GioVeronelli/BREATH/Data_acquired/Furkan/Furkan Protocols.docx

PROTOCOL 1

Protocol 1 – Option 1 – First

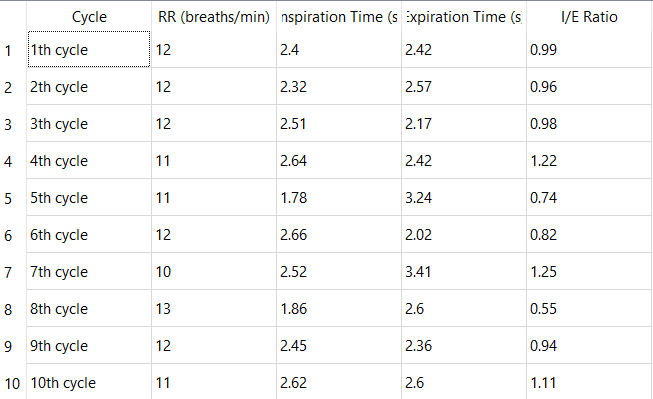
[picture p39: figure]
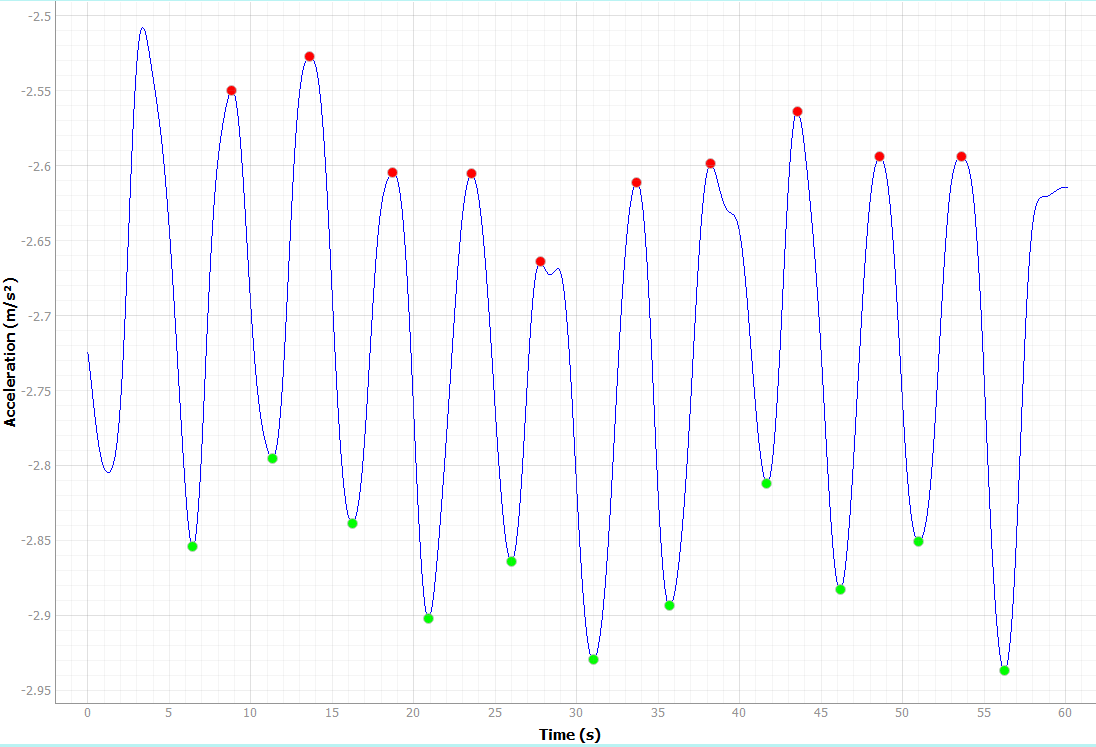
[picture p40: figure]

Protocol 1 – Option 1 – Second

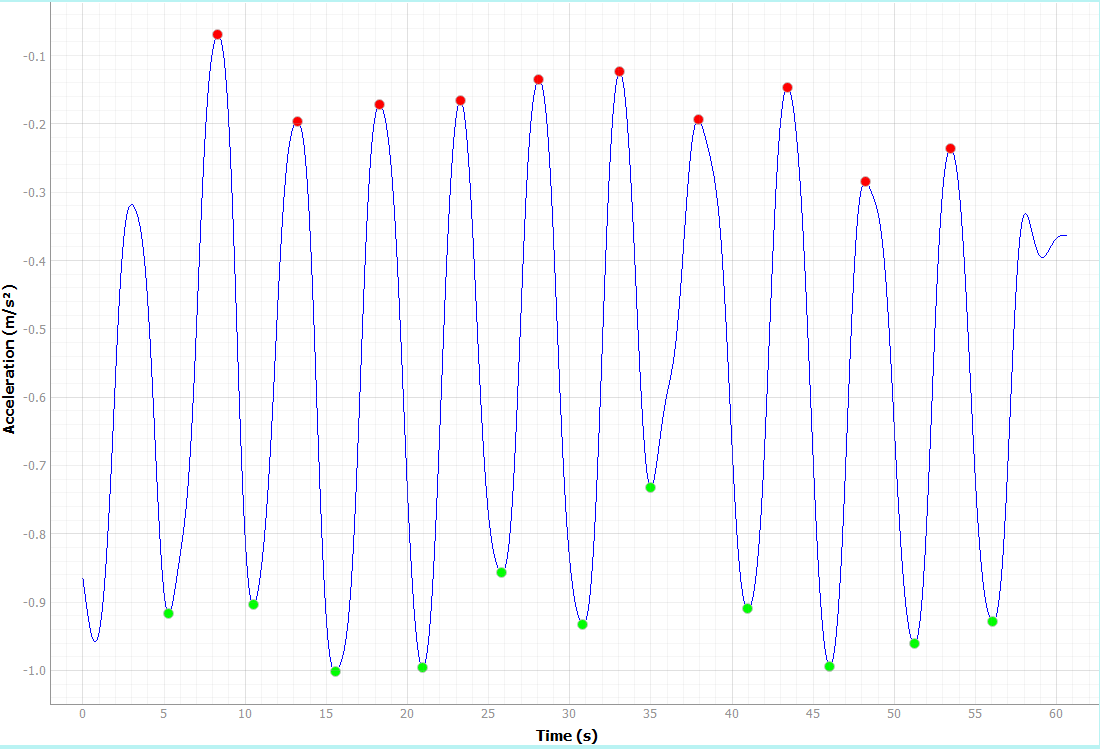
[picture p41: figure]
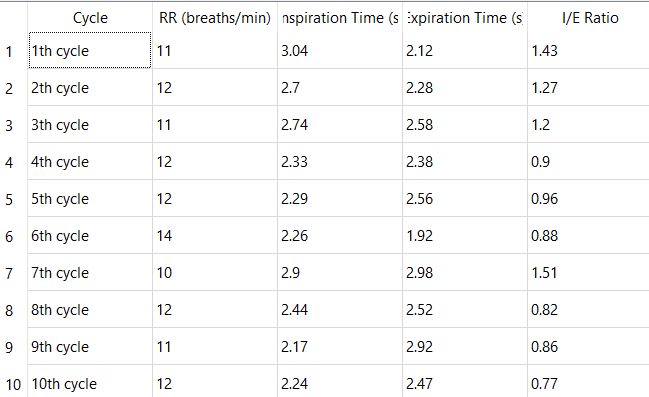
[picture p42: figure]

Protocol 1 – Option 1 – Third

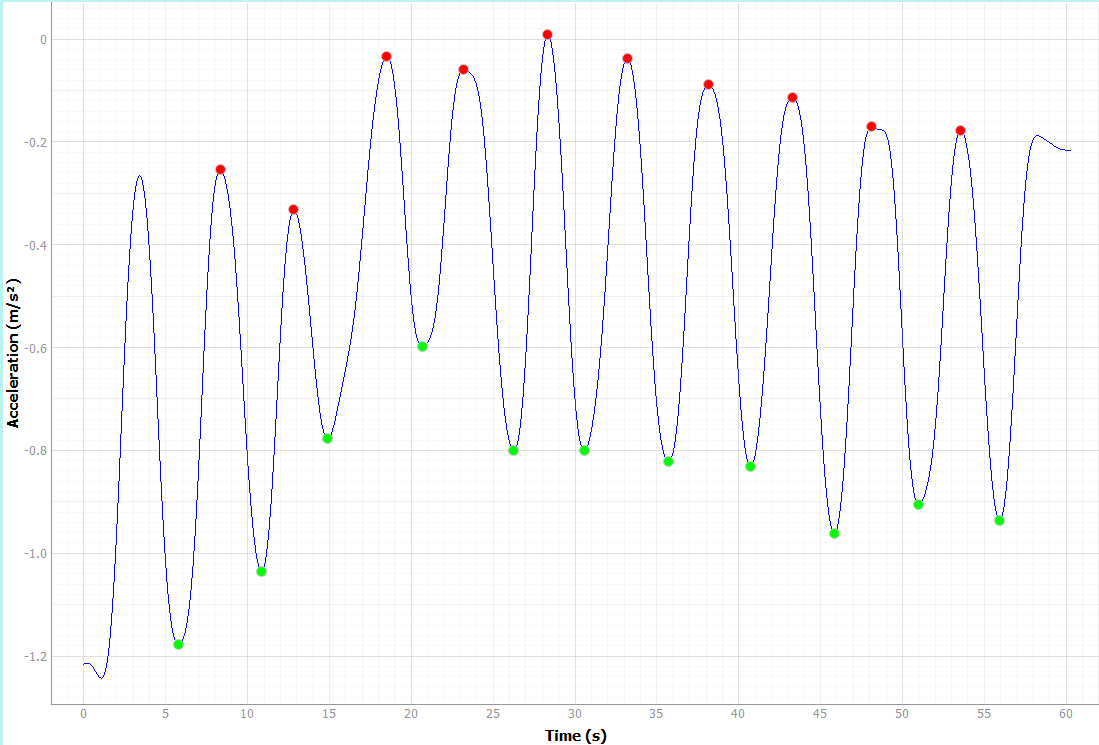
[picture p43: figure]
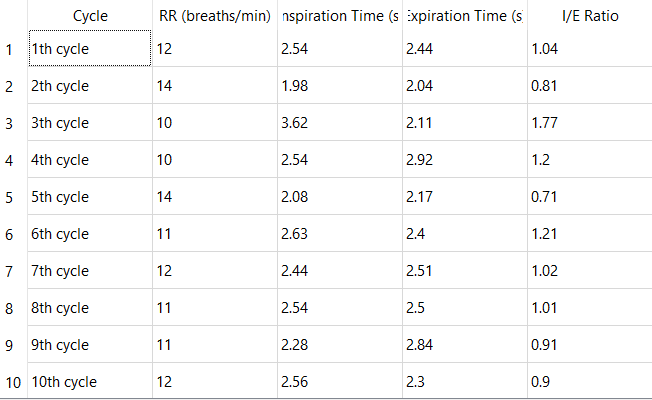
[picture p44: figure]

Protocol 1 Option 2 – First

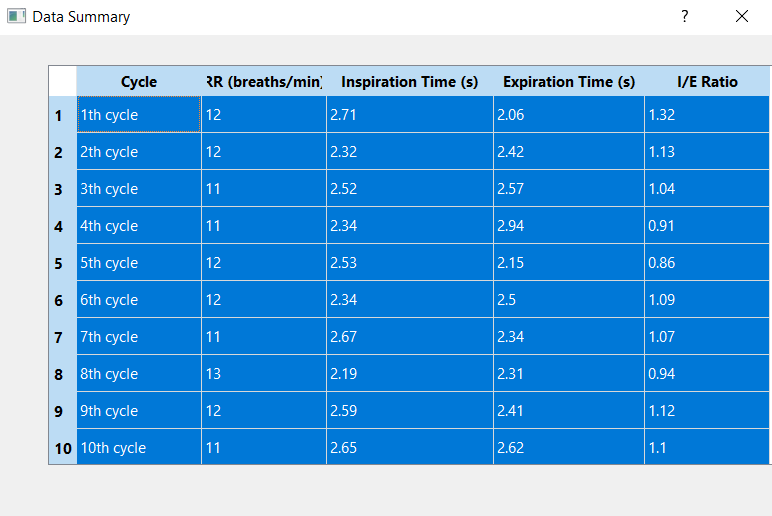
[picture p45: figure]
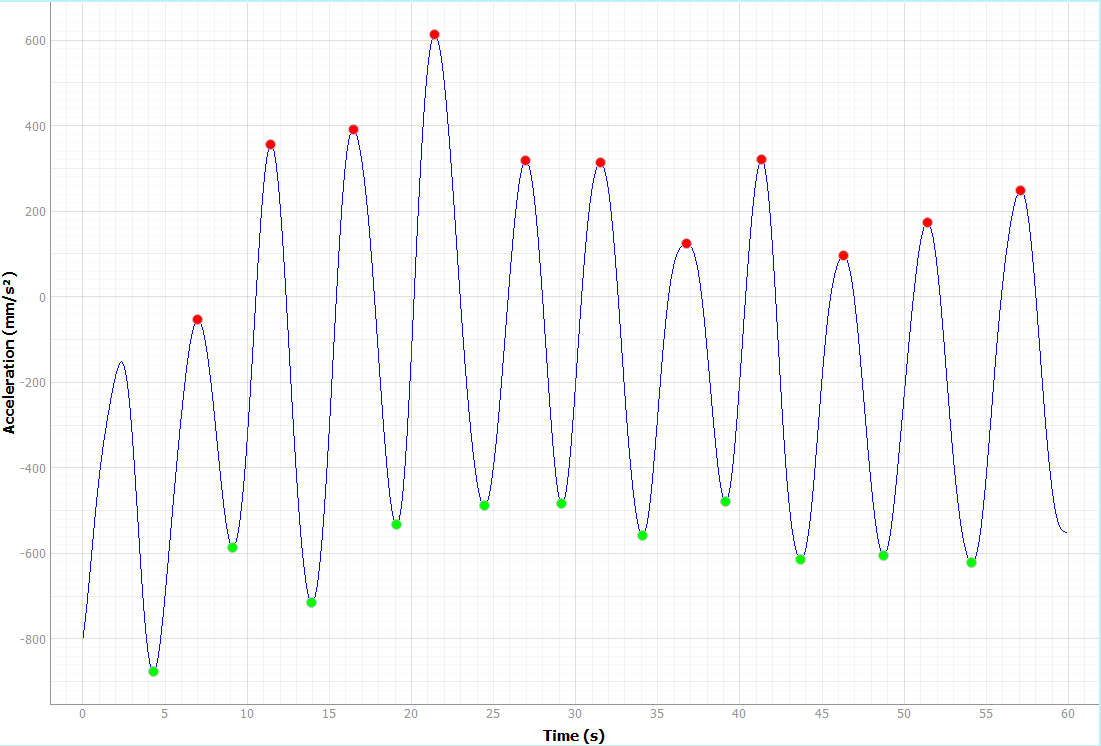
[picture p46: figure]

Protocol 1 Option 2 – Second

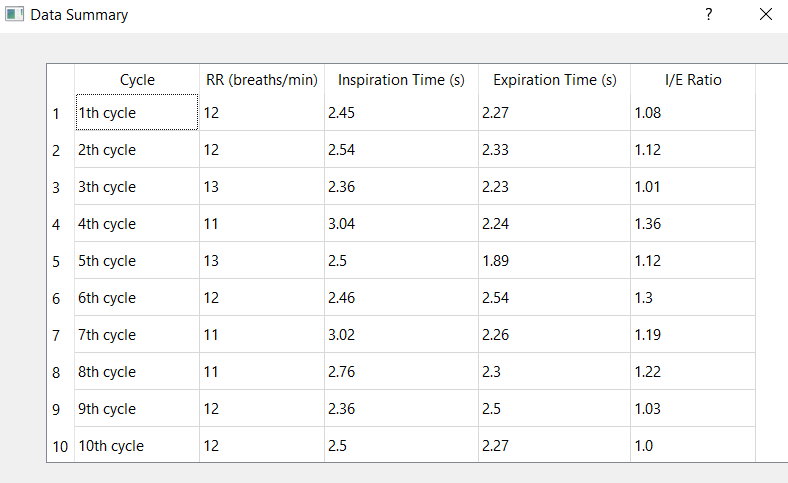
[picture p47: figure]
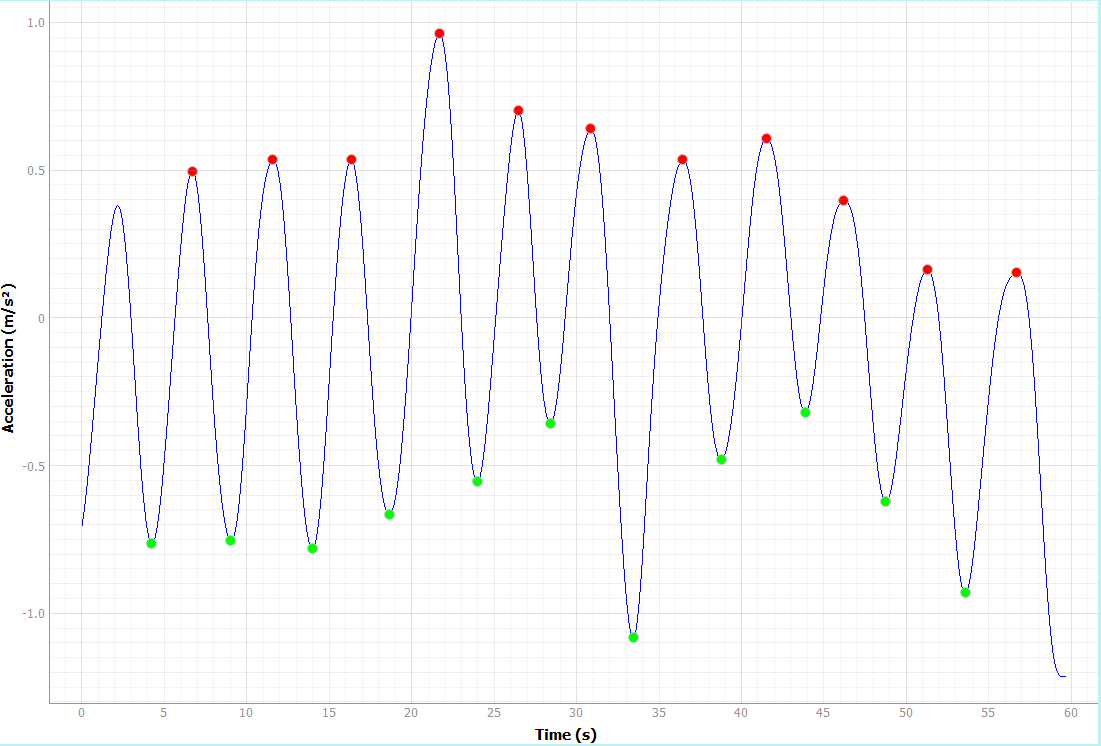
[picture p48: figure]

Protocol 1 Option 2 – Third

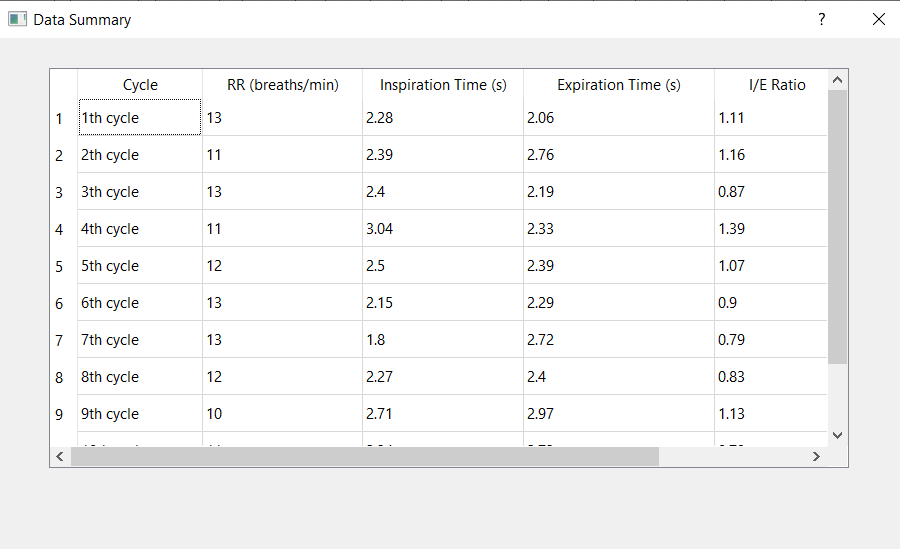
[picture p49: figure]
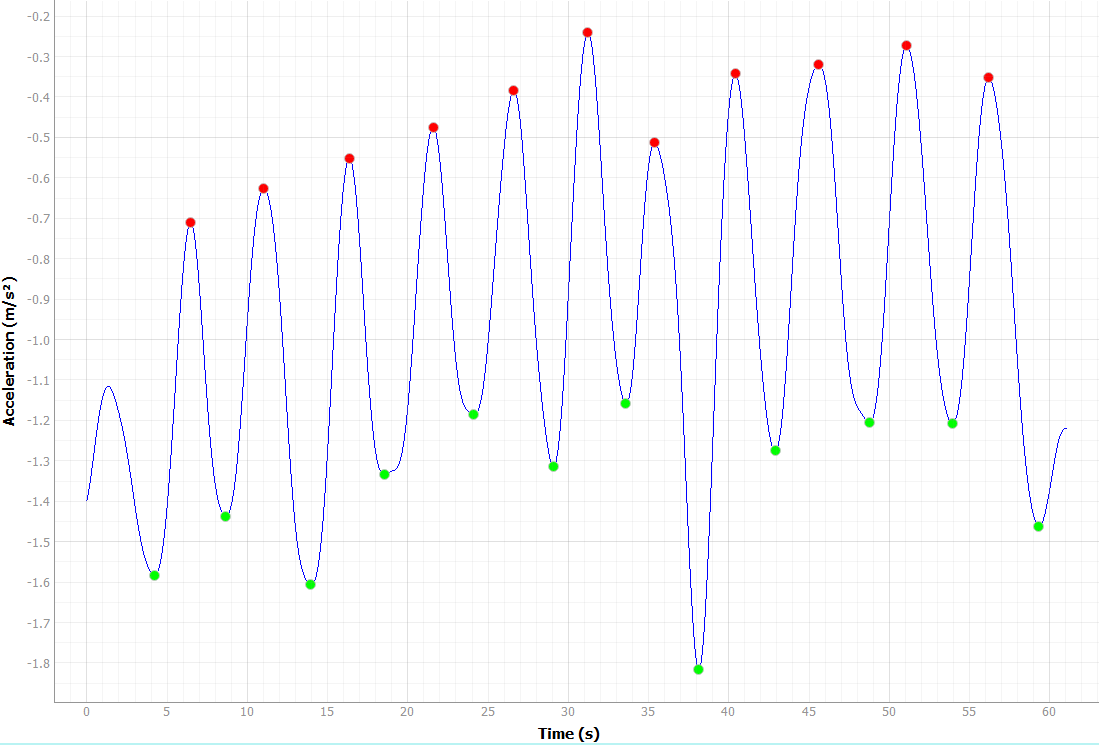
[picture p50: figure]

Protocol 1 – Option 3 – First

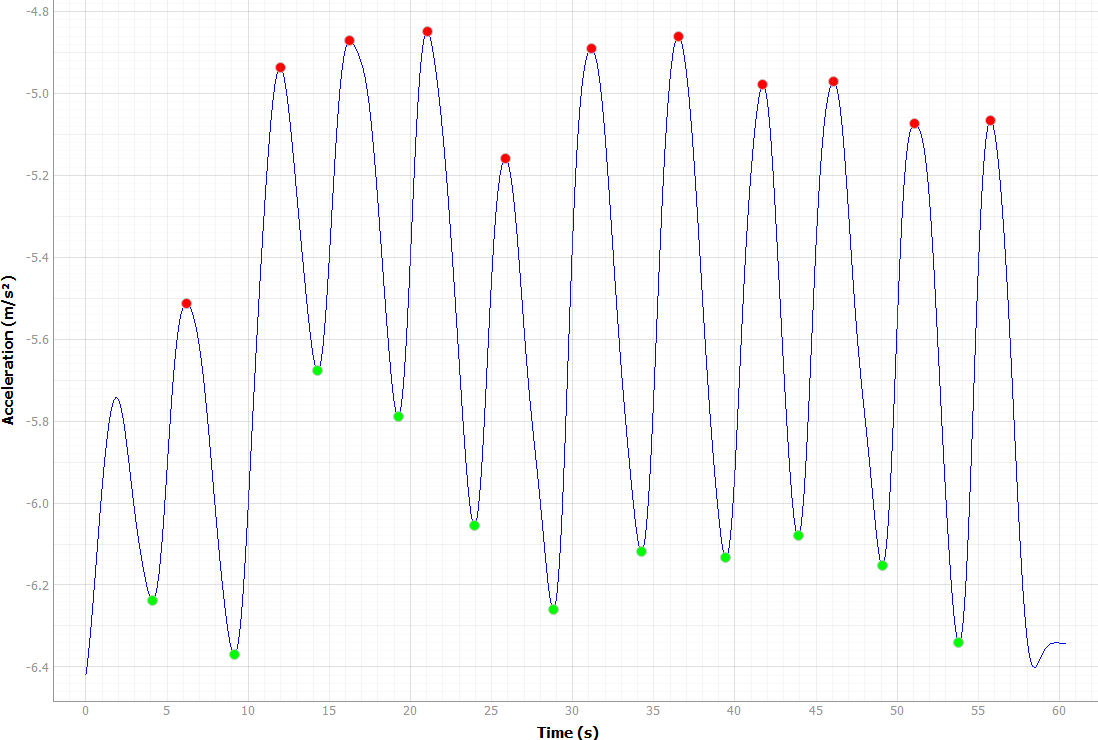
[picture p51: figure]
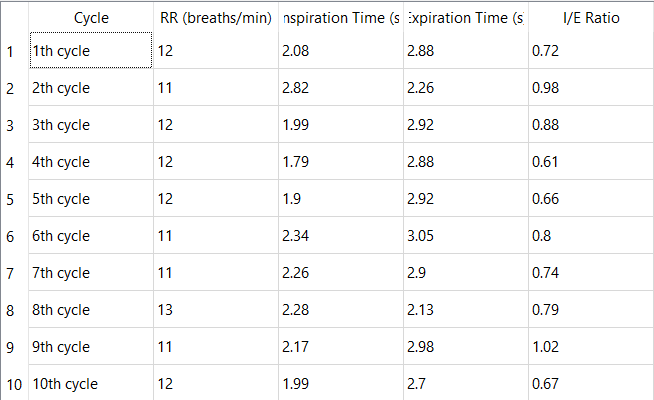
[picture p52: figure]

Protocol 1 – Option 3 – Second

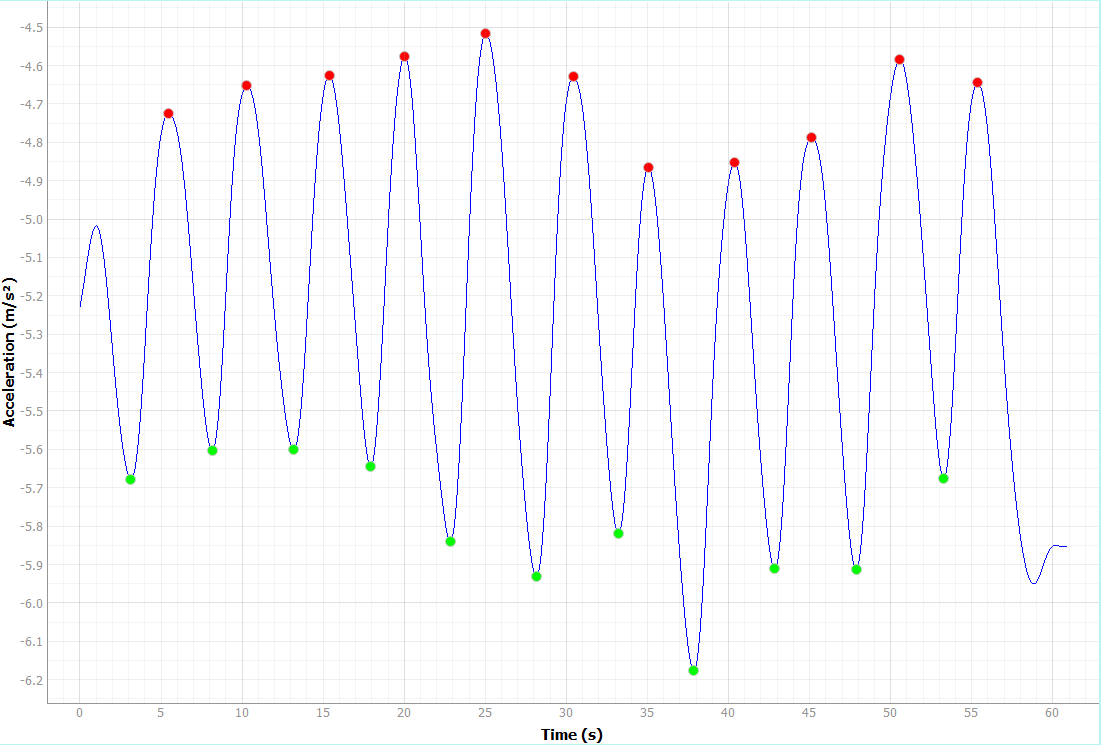
[picture p53: figure]
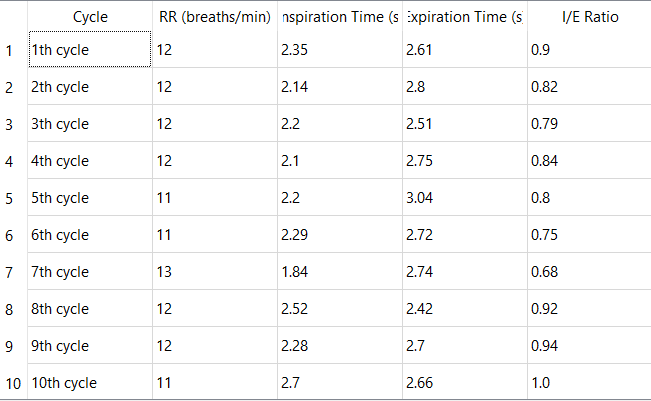
[picture p54: figure]

Protocol 1 – Option 3 – Third

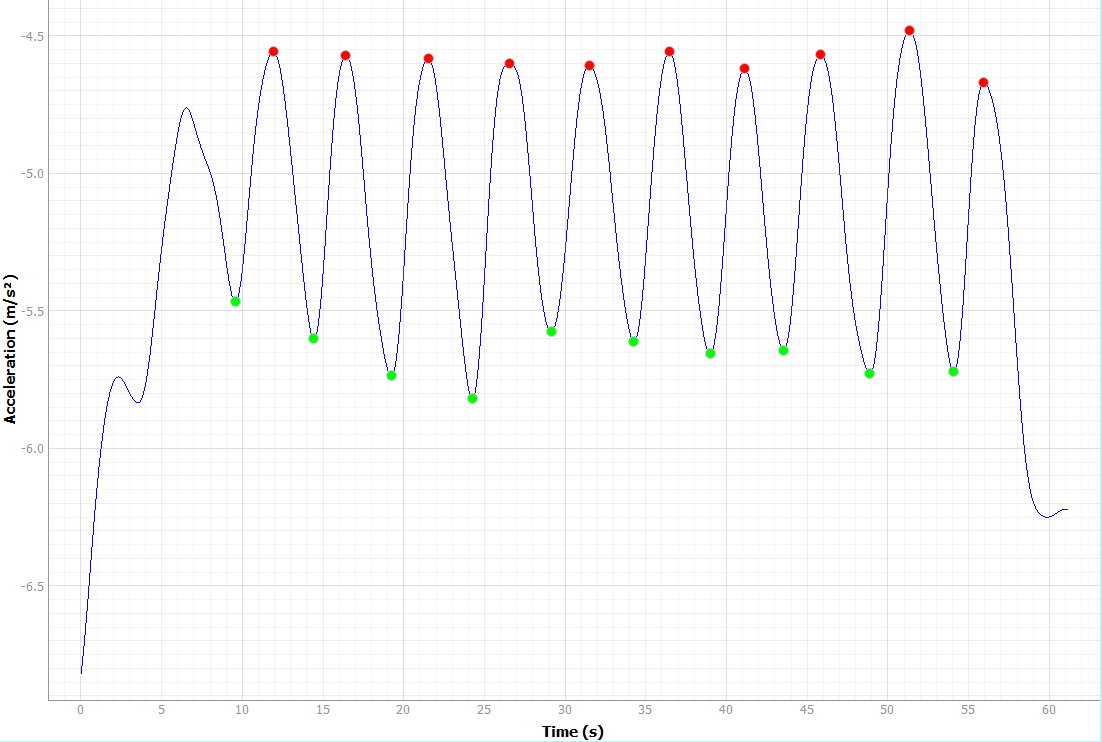
[picture p55: figure]
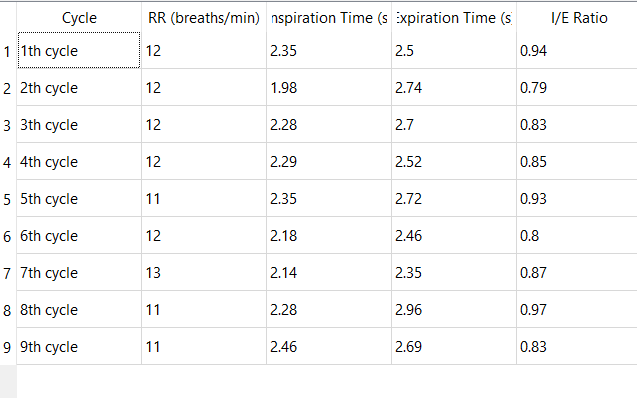
[picture p56: figure]

Protocol 1 – Option 4 – First

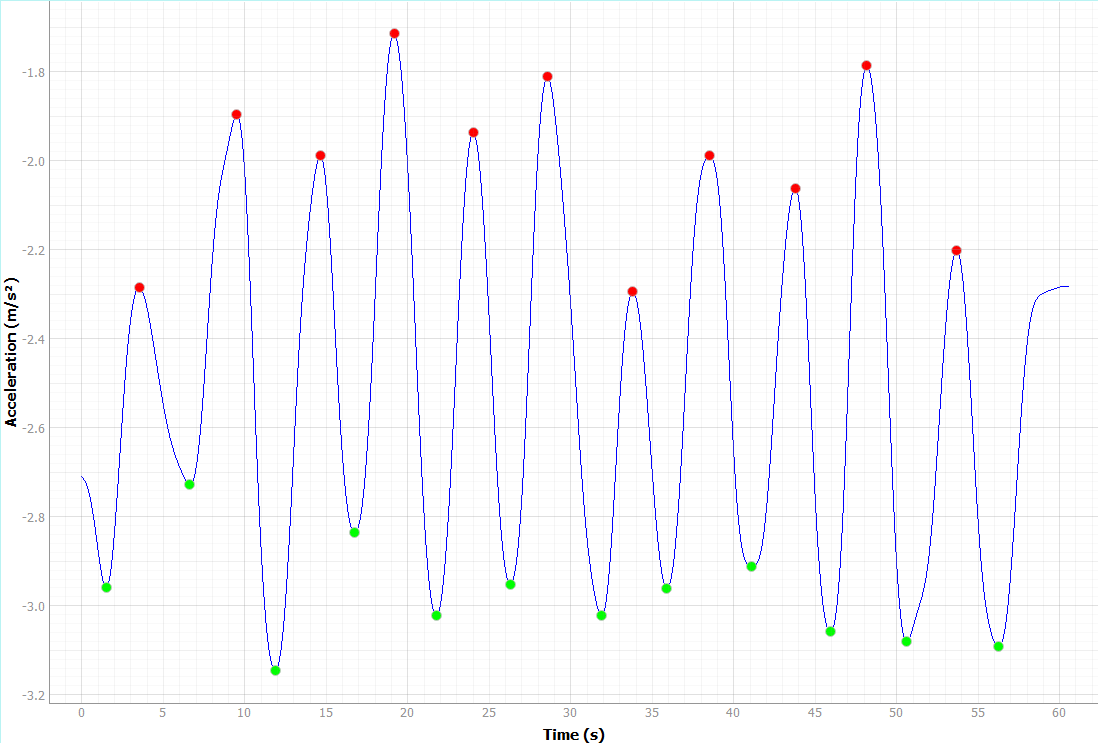
[picture p57: figure]
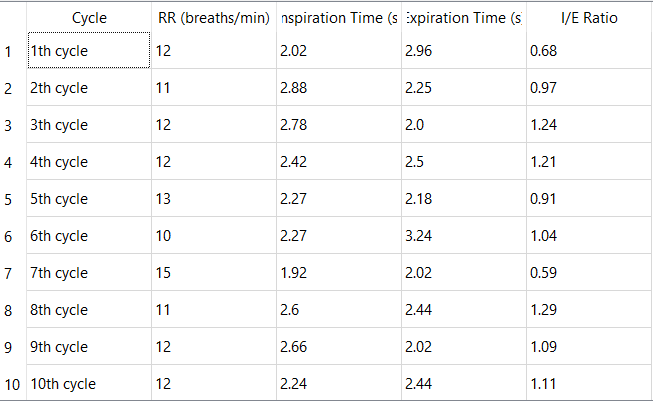
[picture p58: figure]

Protocol 1 – Option 4 – Second

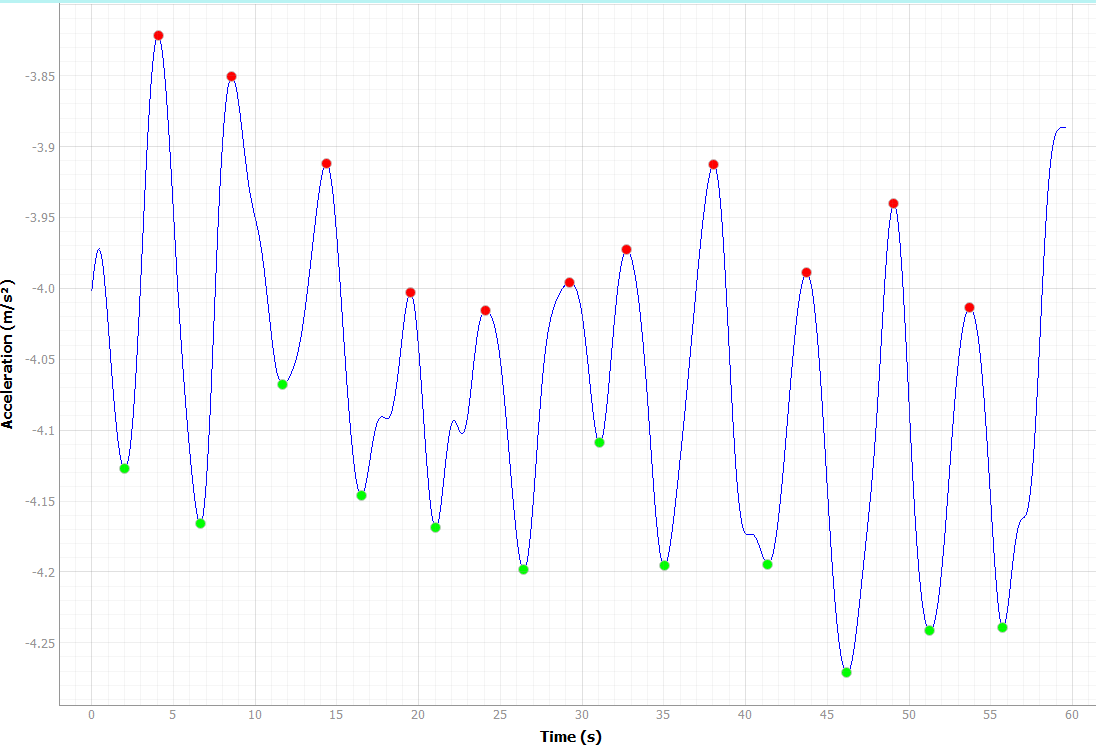
[picture p59: figure]
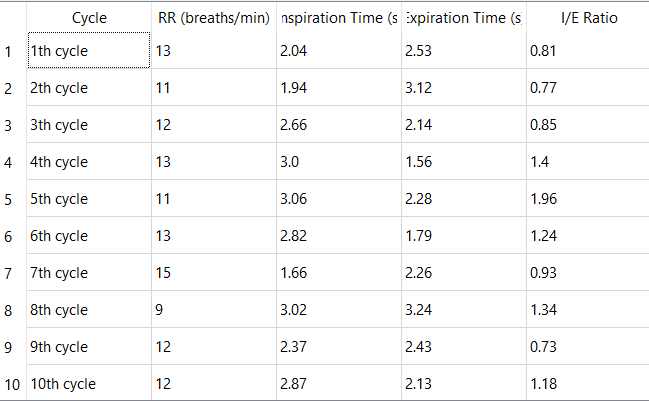
[picture p60: figure]

Protocol 1 – Option 4 – Third

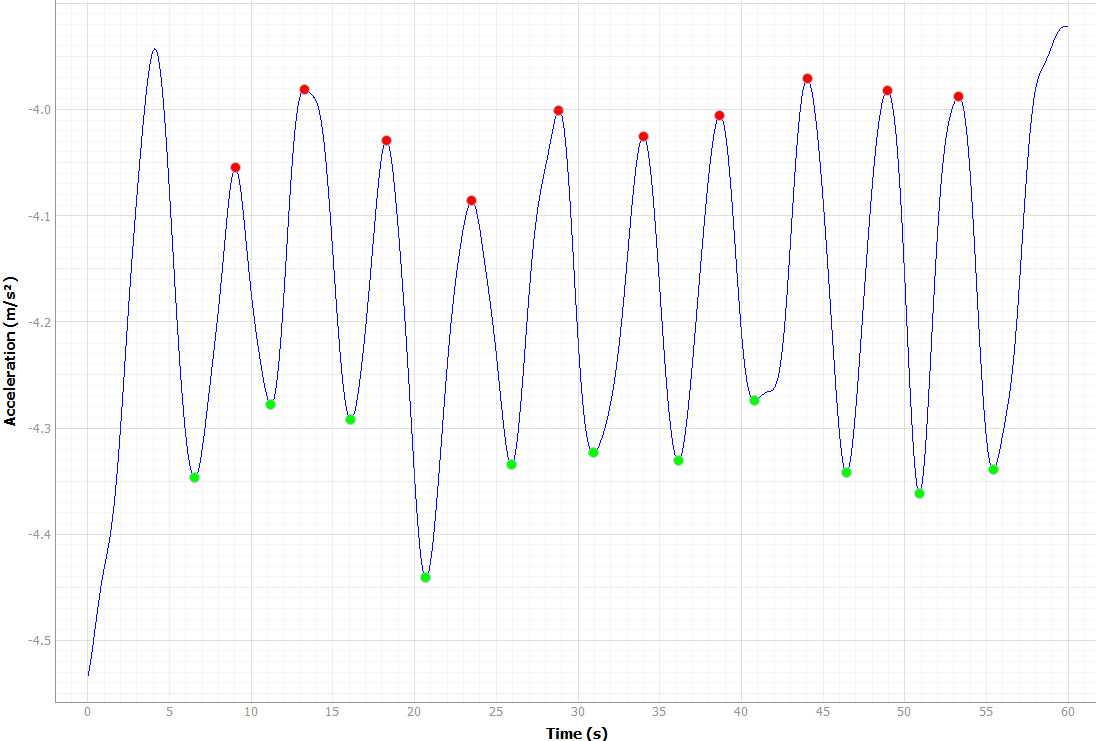
[picture p61: figure]
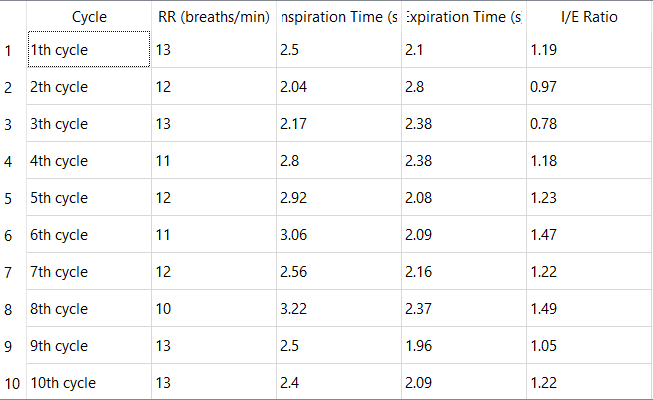
[picture p62: figure]

PROTOCOL 2

Protocol 2 Option 1 – First

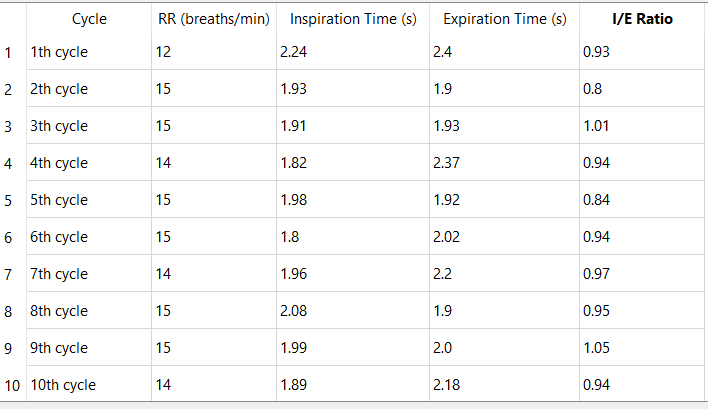
[picture p63: figure]
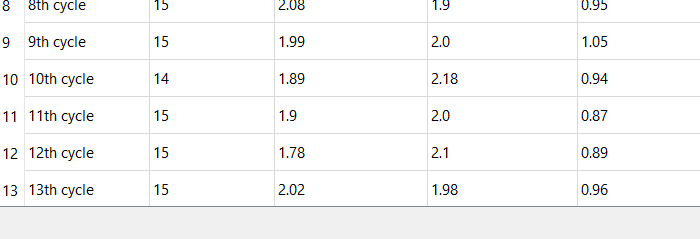
[picture p64: figure]
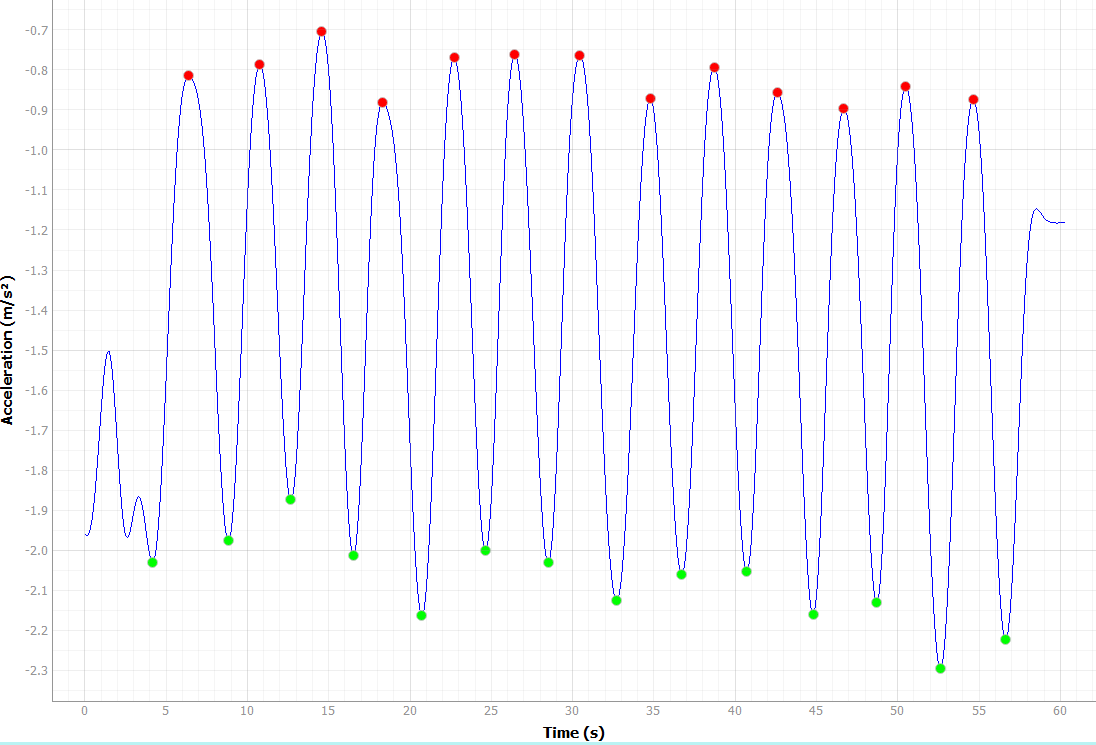
[picture p65: figure]

Protocol 2 Option 1 – Second

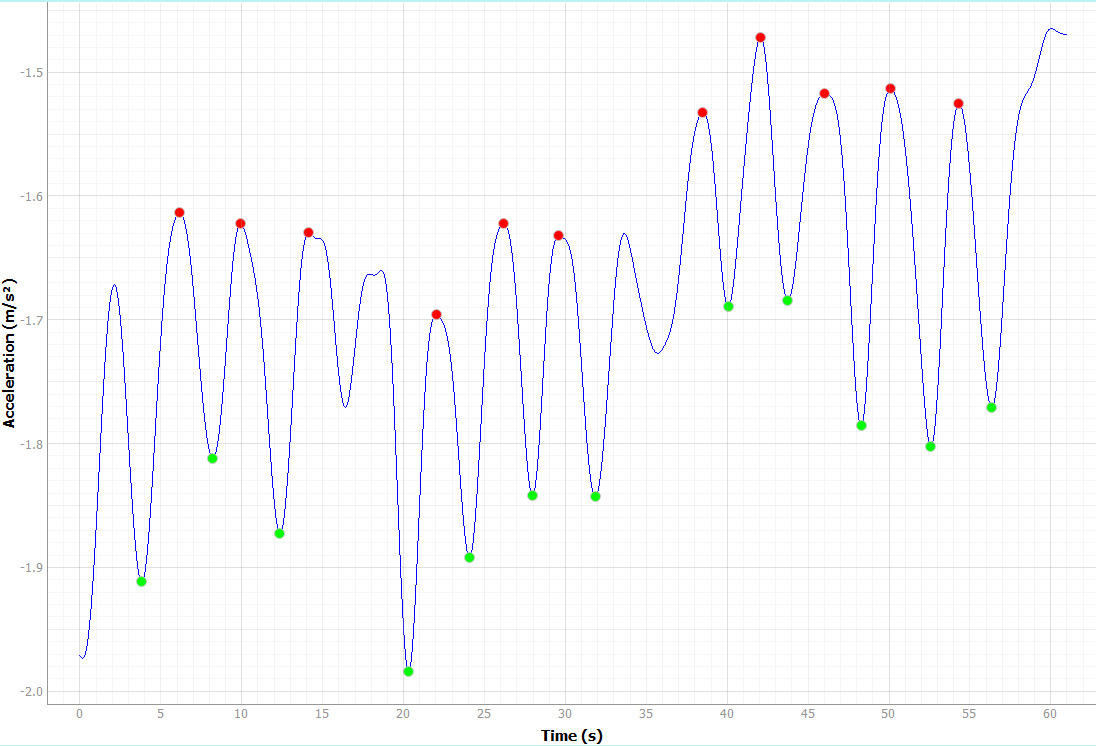
[picture p66: figure]
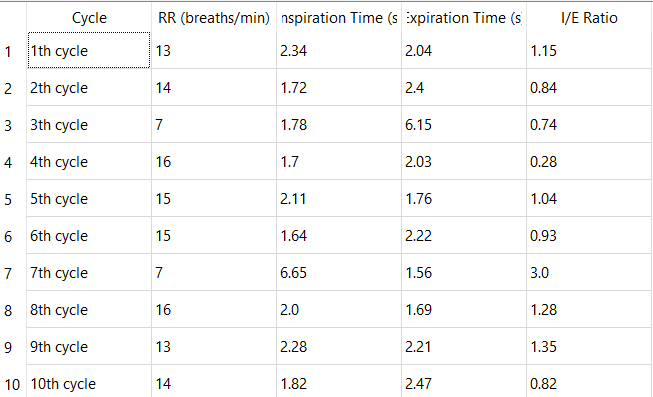
[picture p67: figure]

Protocol 2 Option 1 – Third

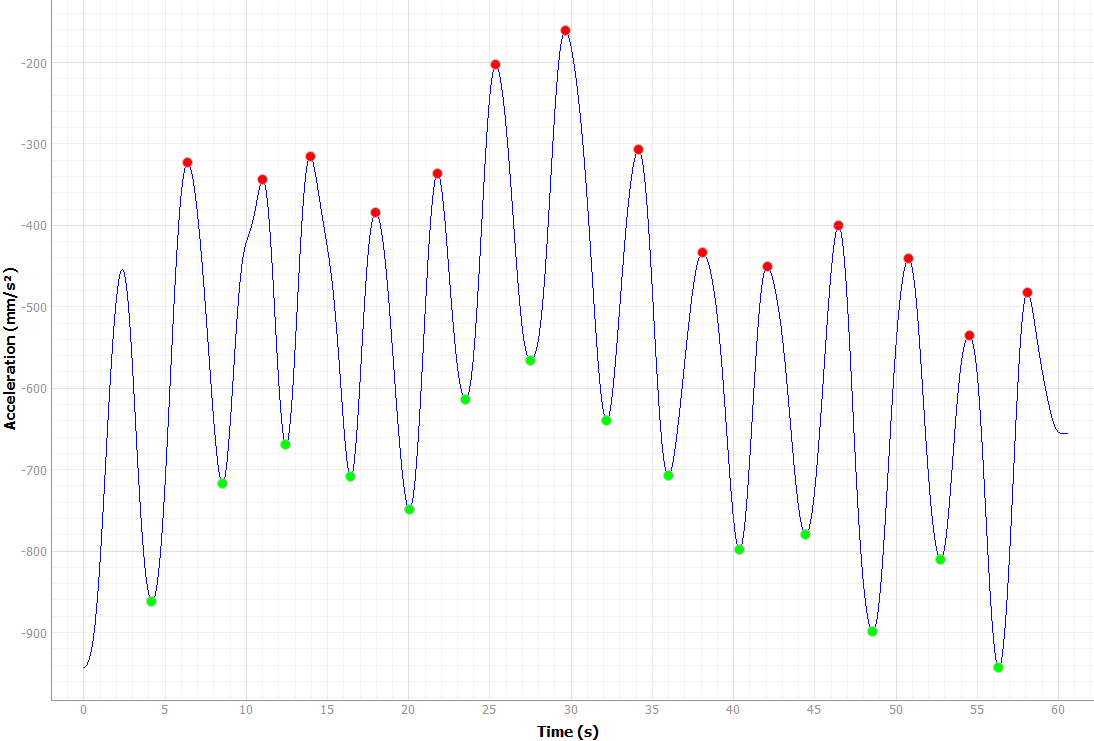
[picture p68: figure]
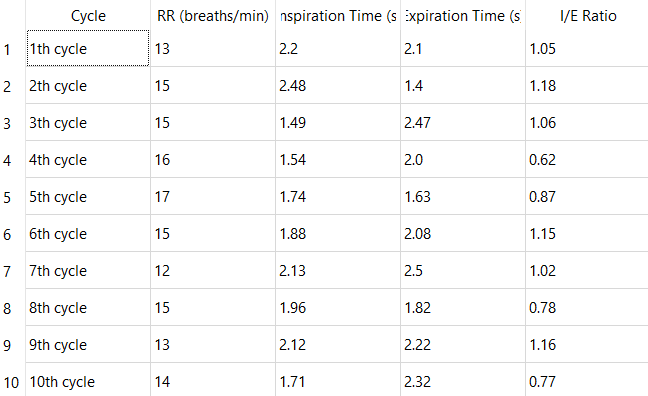
[picture p69: figure]

Protocol 2 Option 2 – First

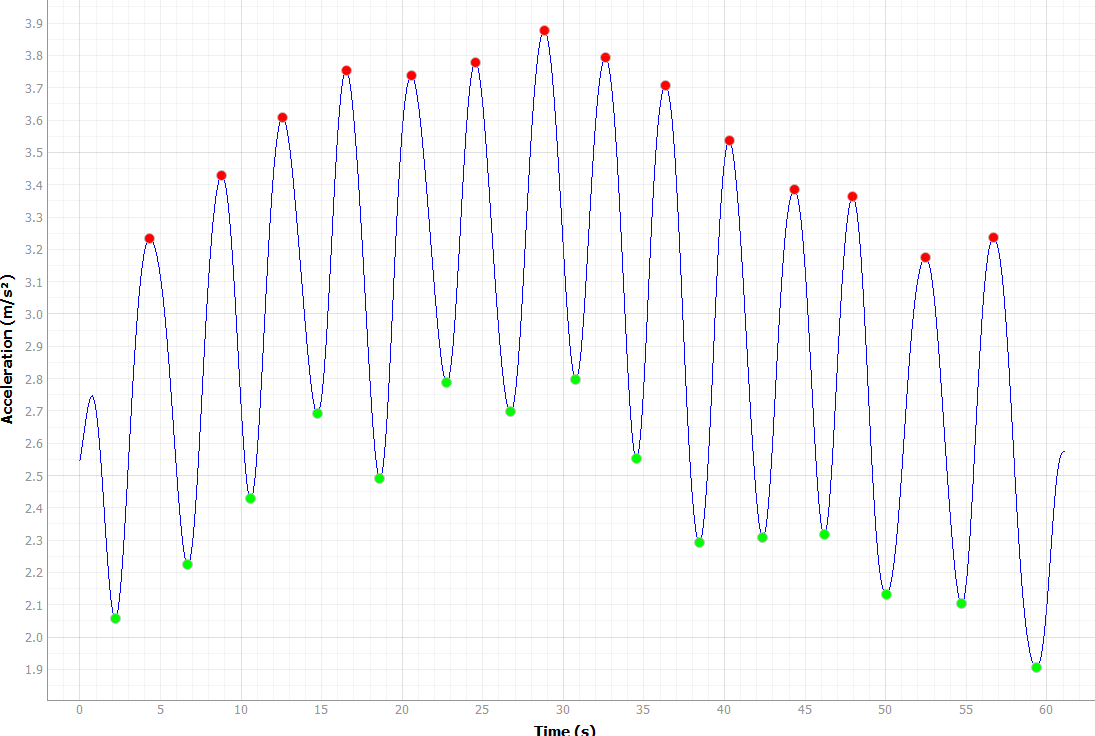
[picture p70: figure]
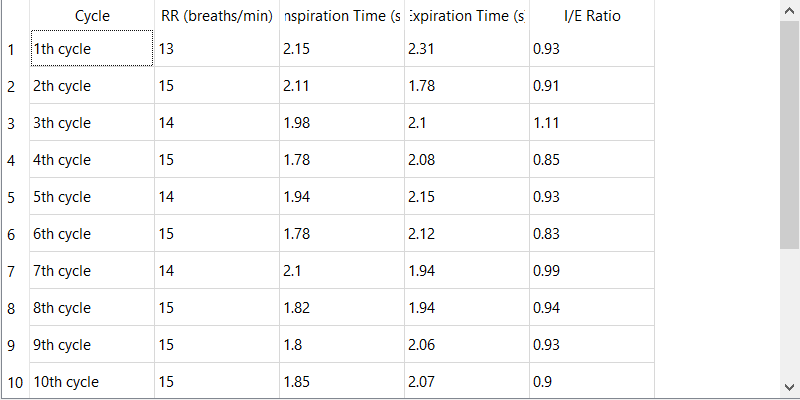
[picture p71: figure]

Protocol 2 Option 2 – Second

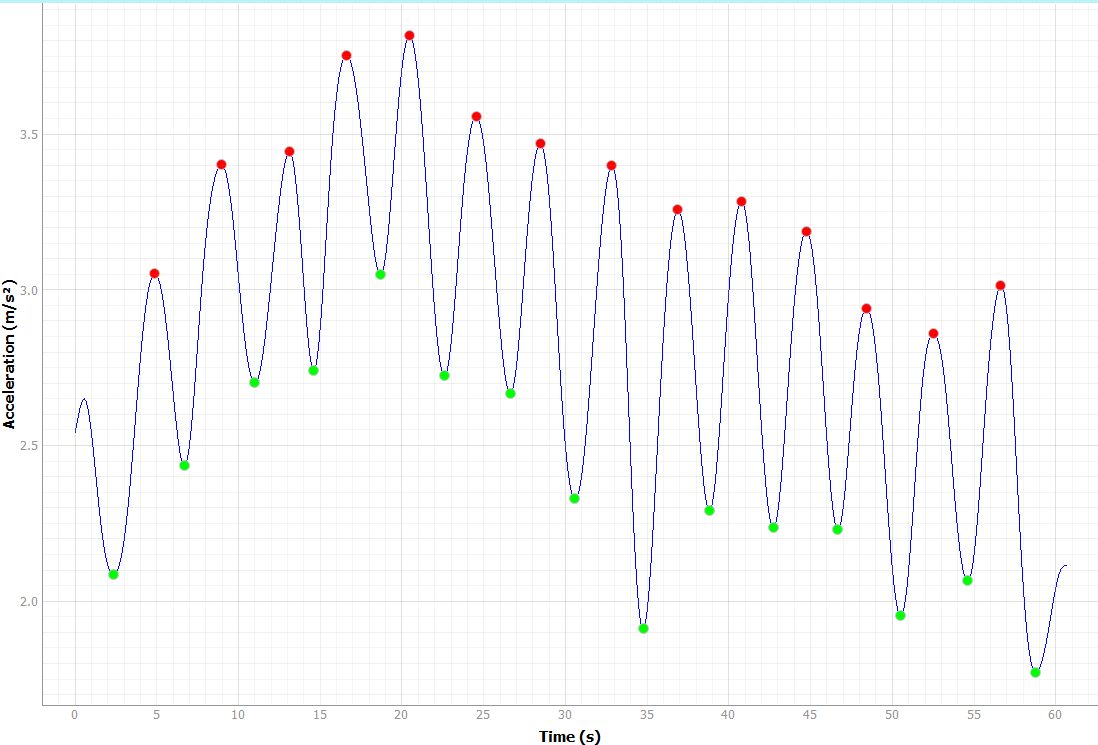
[picture p72: figure]
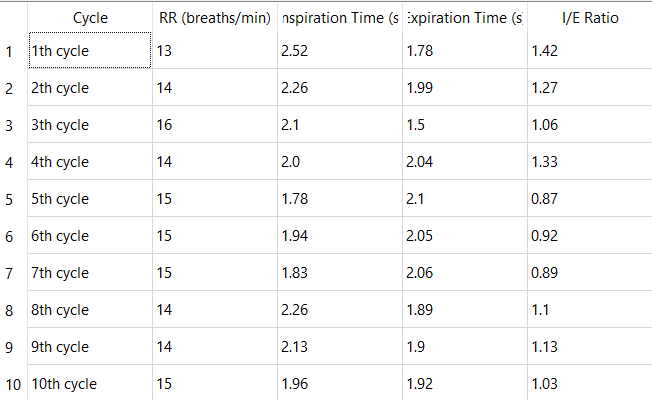
[picture p73: figure]

Protocol 2 Option 2 – Third

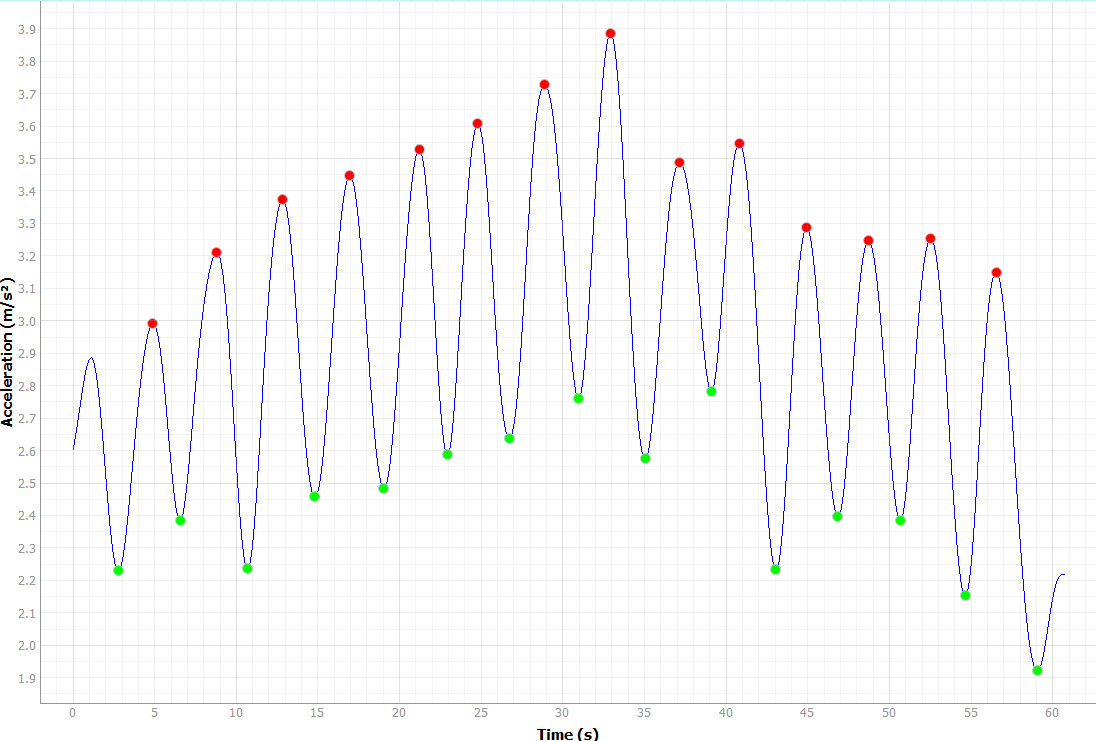
[picture p74: figure]
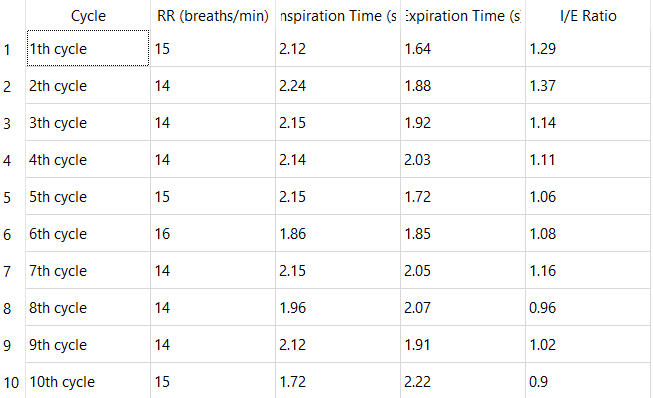
[picture p75: figure]

Protocol 2 Option 3 – First

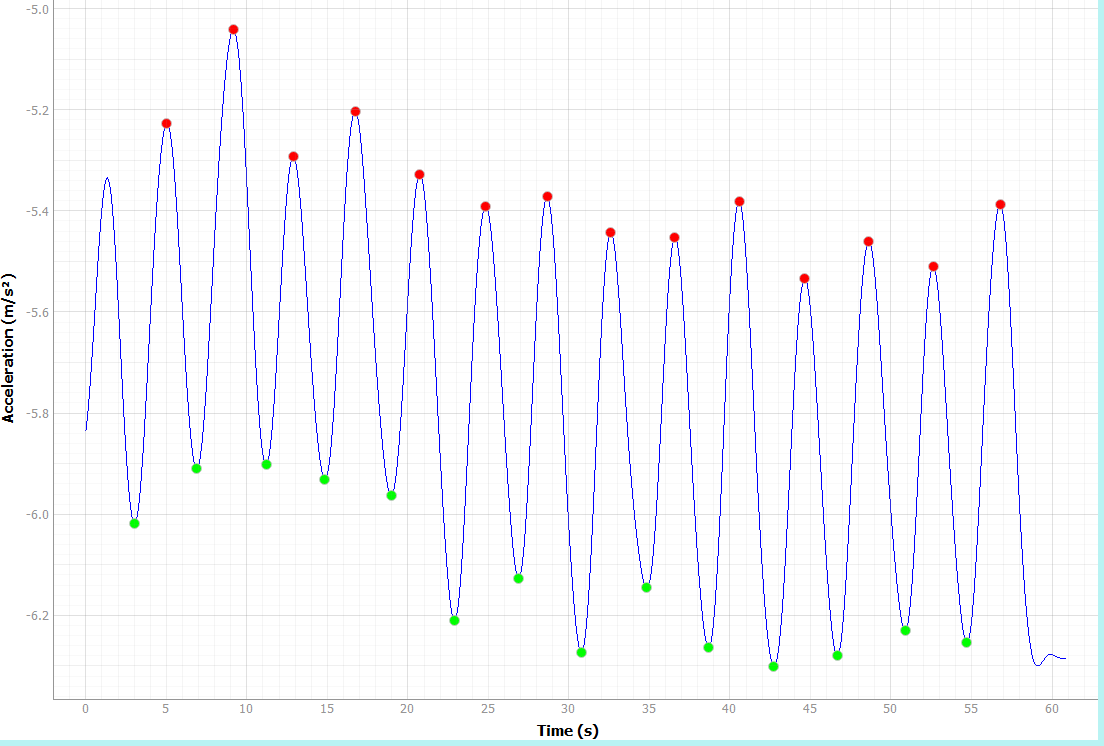
[picture p76: figure]
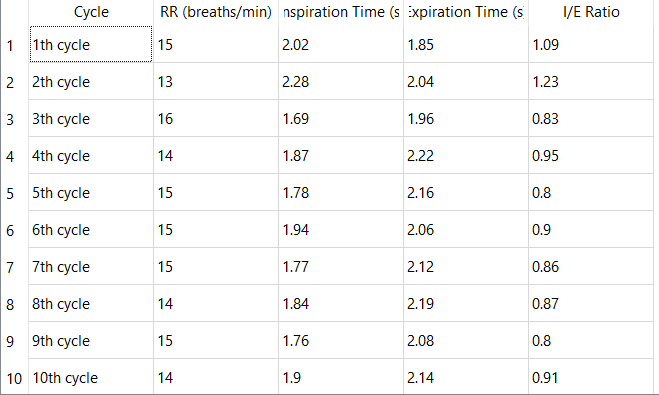
[picture p77: figure]

Protocol 2 Option 3 – Second

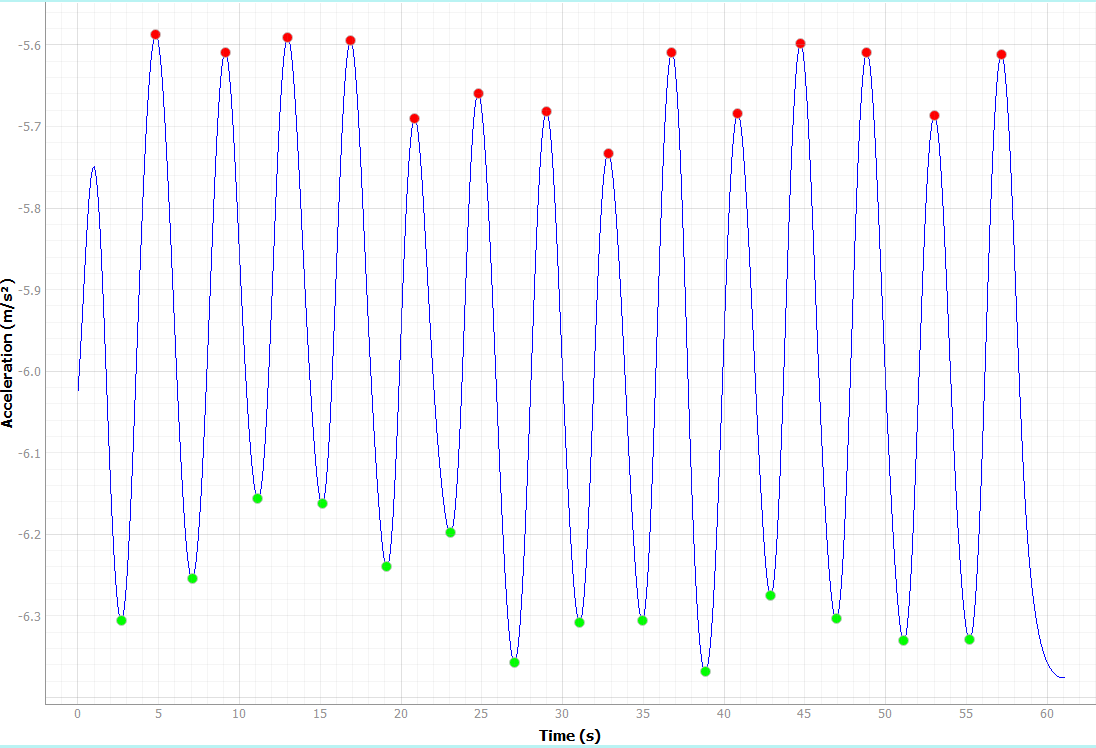
[picture p78: figure]
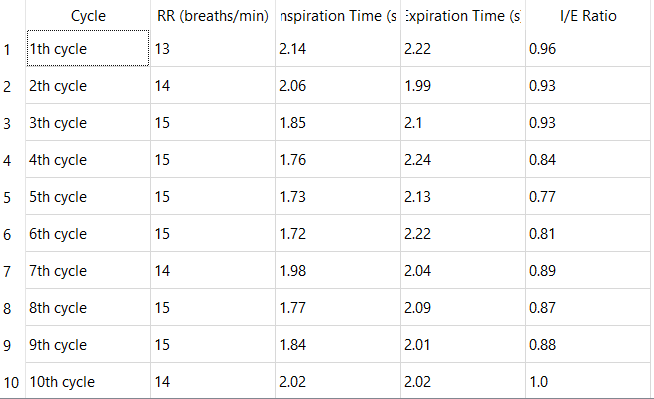
[picture p79: figure]

Protocol 2 Option 3 – Third

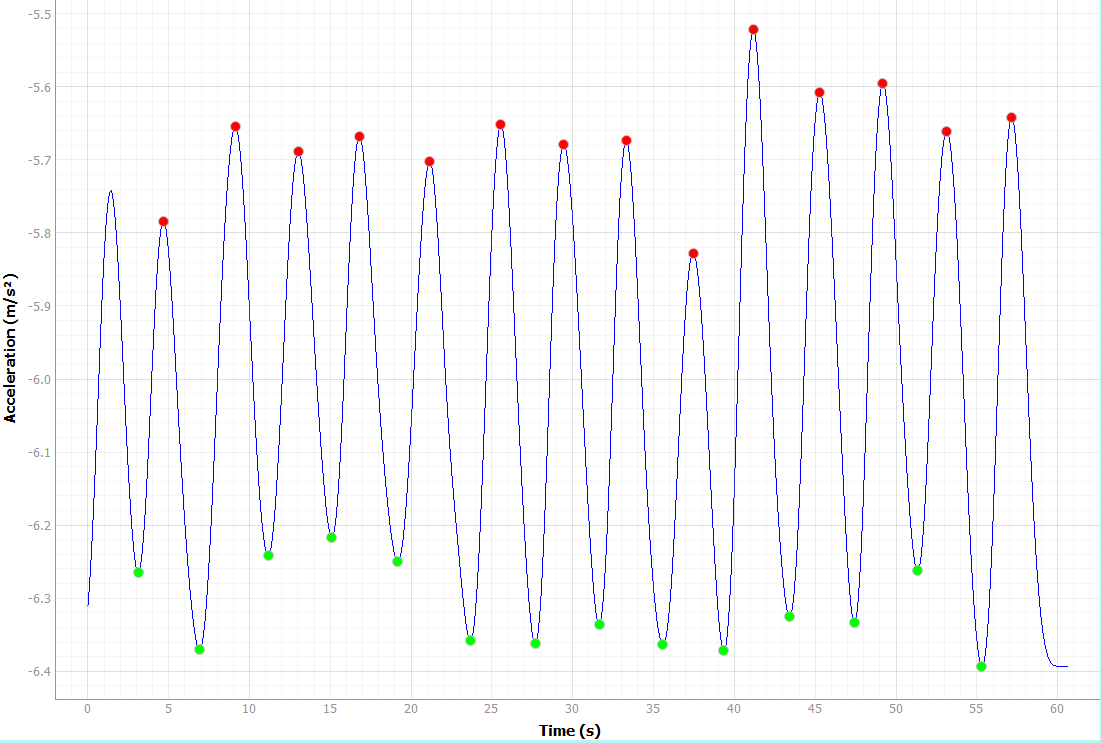
[picture p80: figure]
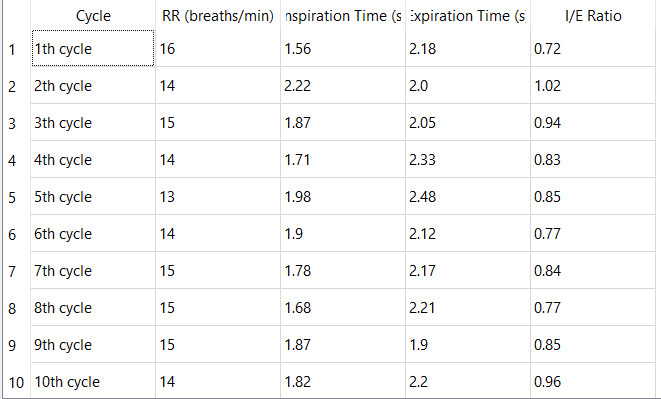
[picture p81: figure]

Protocol 2 Option 4 – First

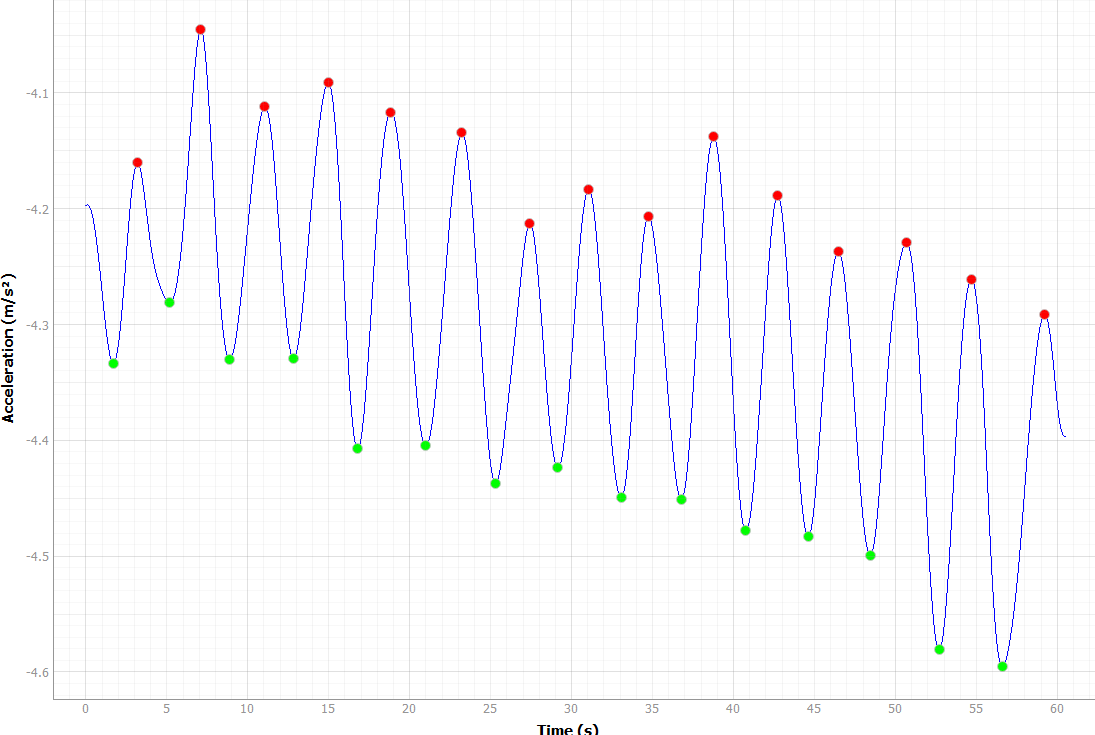
[picture p82: figure]
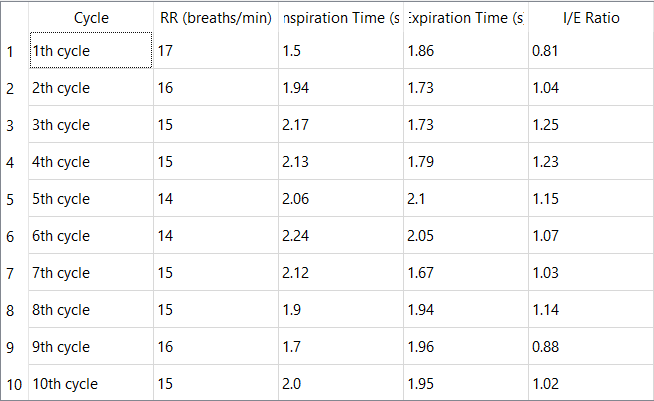
[picture p83: figure]

Protocol 2 Option 4 – Second

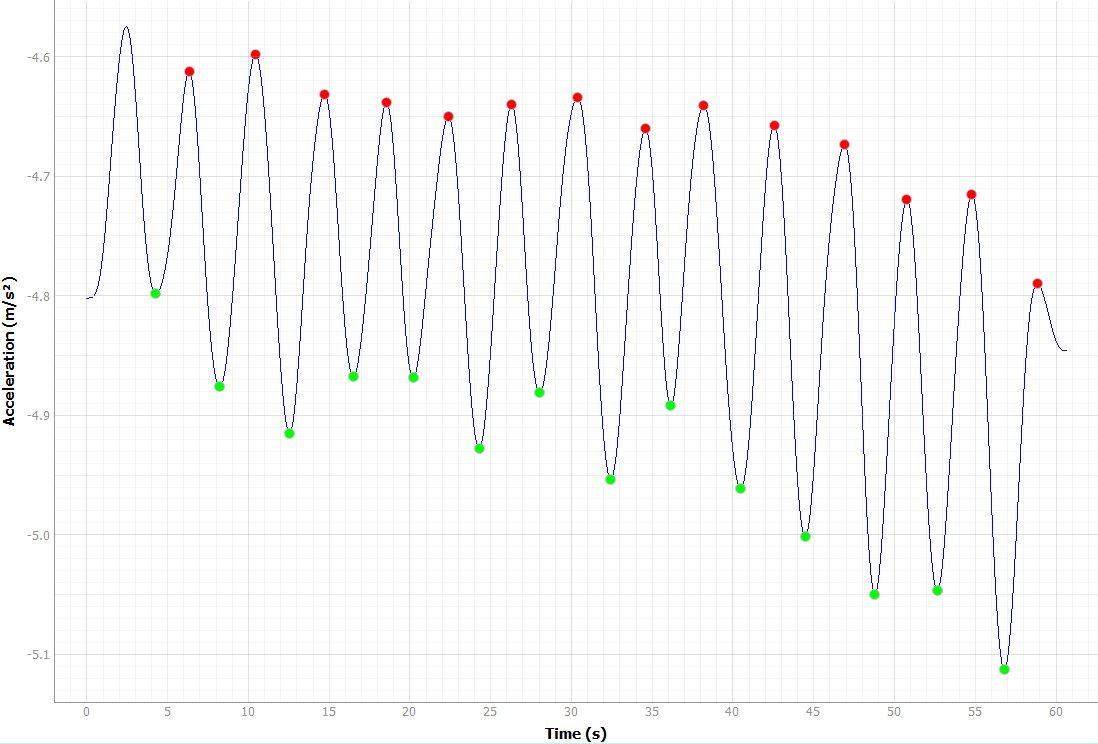
[picture p84: figure]
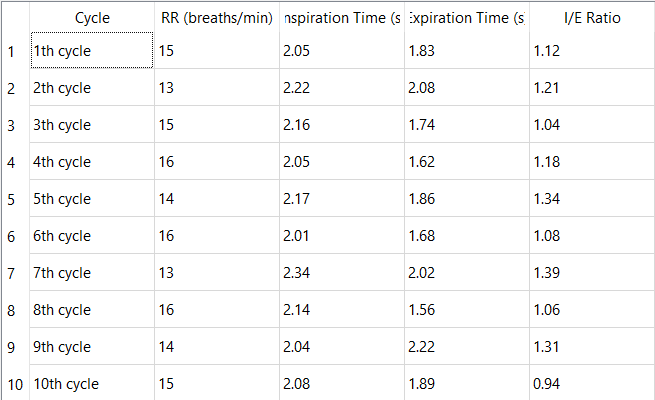
[picture p85: figure]

Protocol 2 Option 4 – Third

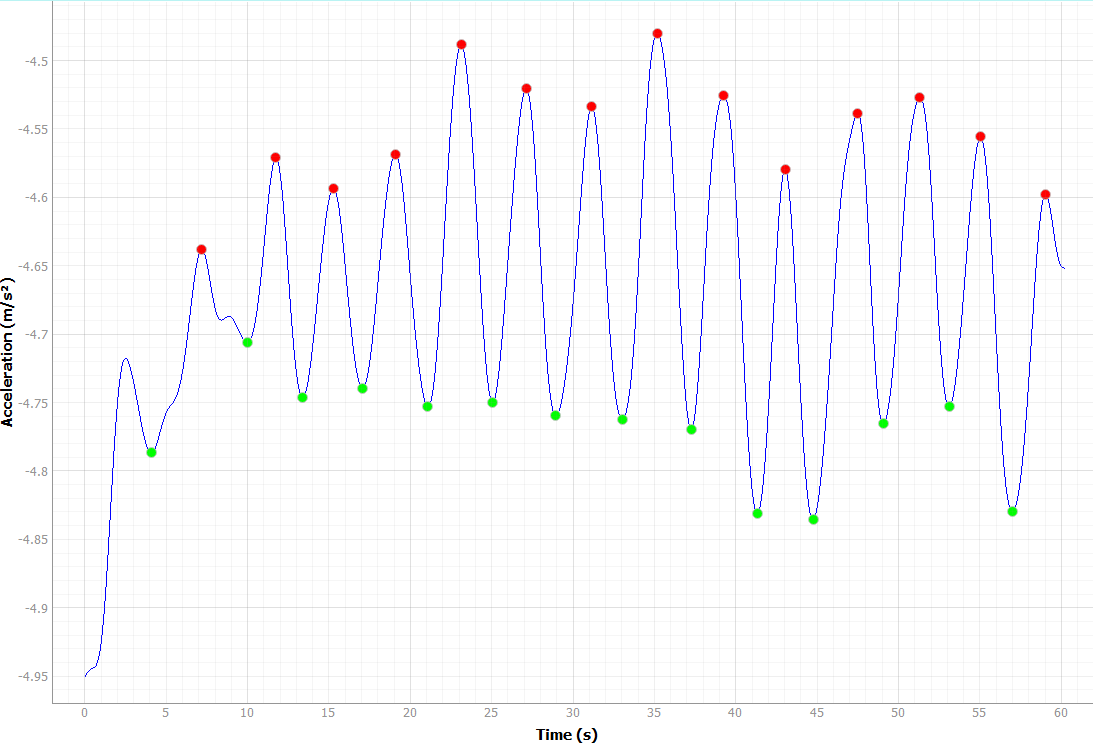
[picture p86: figure]
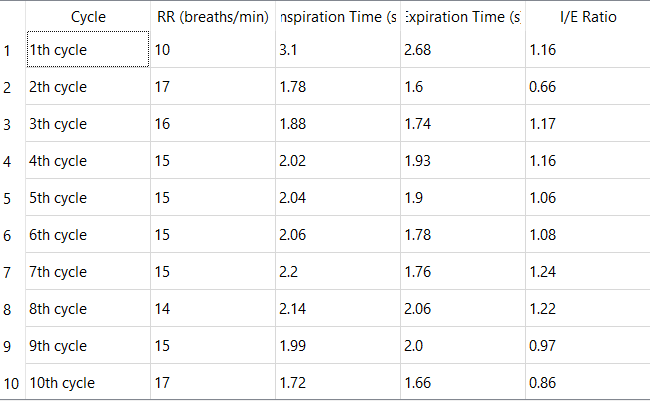
[picture p87: figure]

PROTOCOL 3

Protocol 3 Option 1 – First

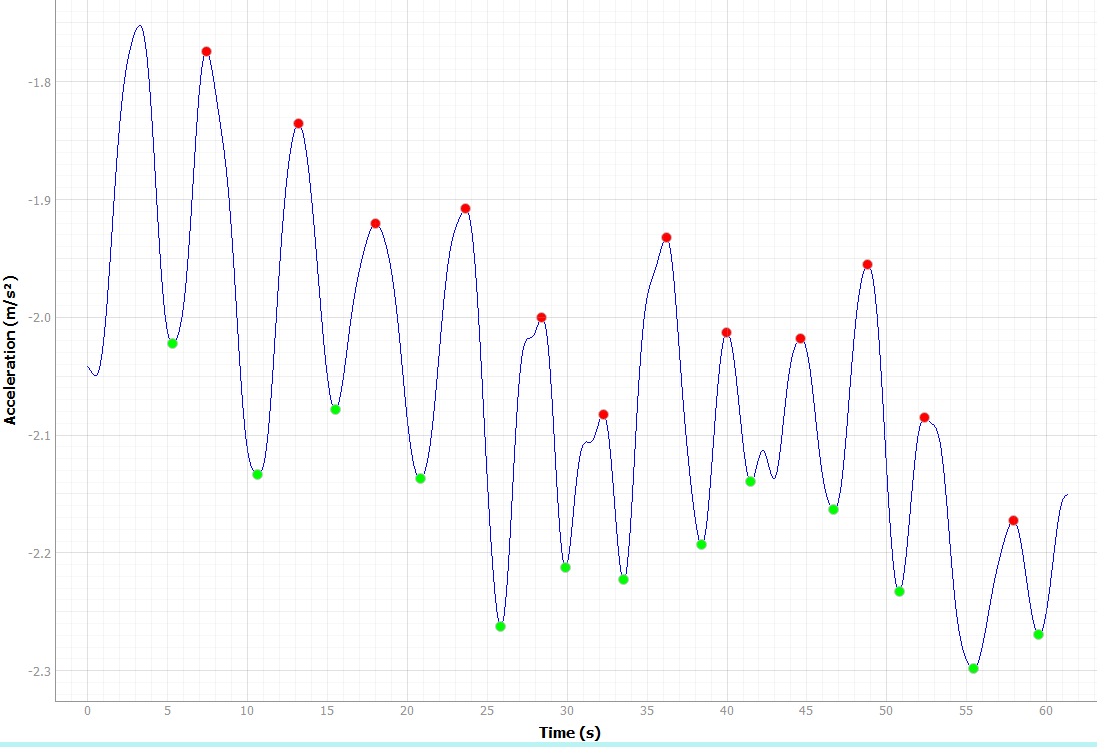
[picture p88: figure]
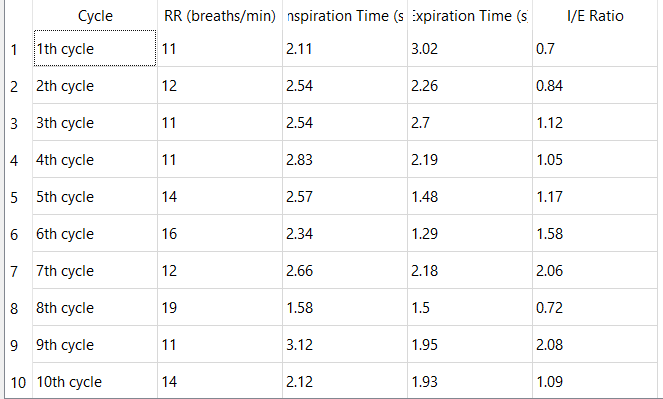
[picture p89: figure]

Protocol 3 Option 1 – Second

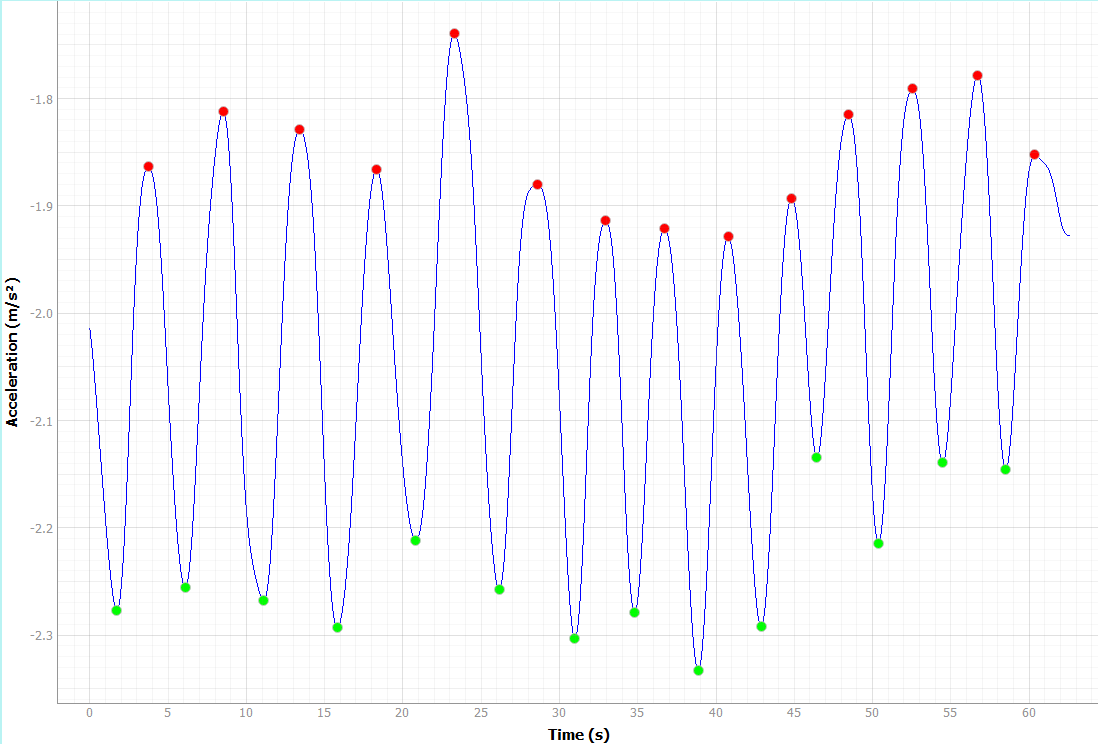
[picture p90: figure]
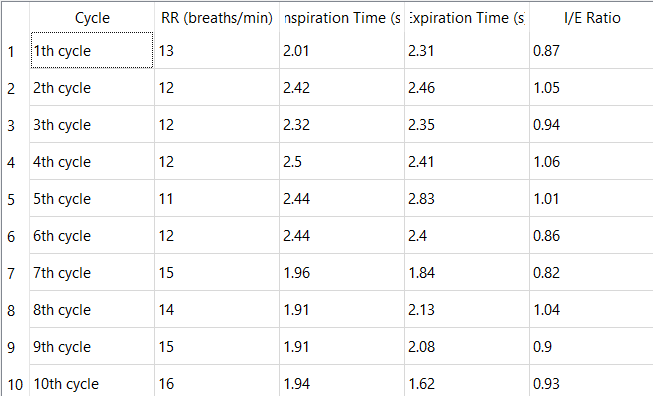
[picture p91: figure]

Protocol 3 Option 1 – Third

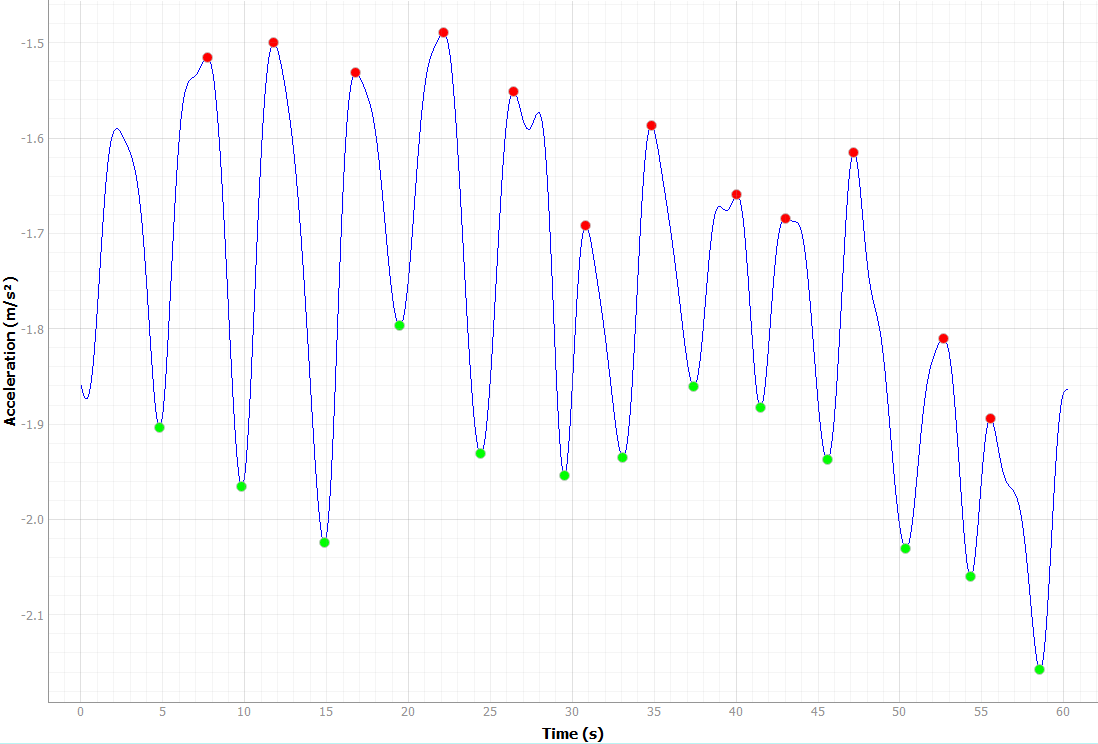
[picture p92: figure]
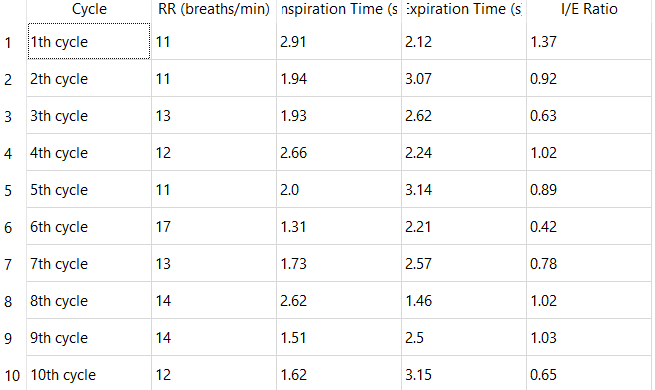
[picture p93: figure]

Protocol 3 Option 2 – First

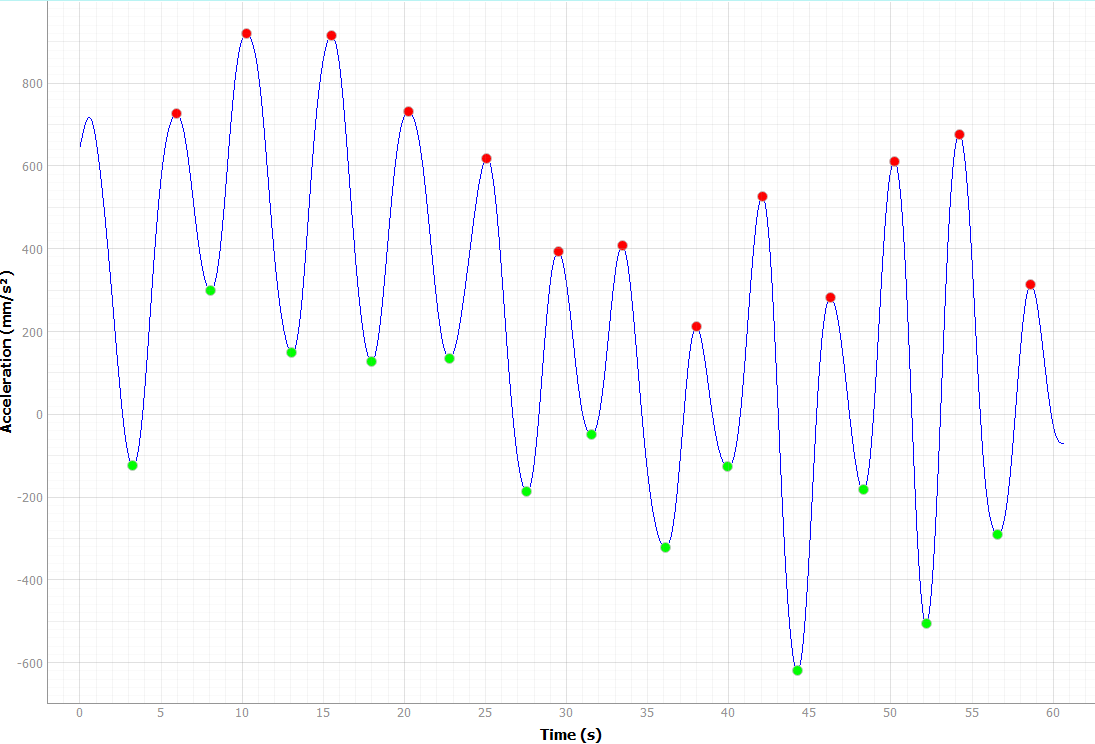
[picture p94: figure]
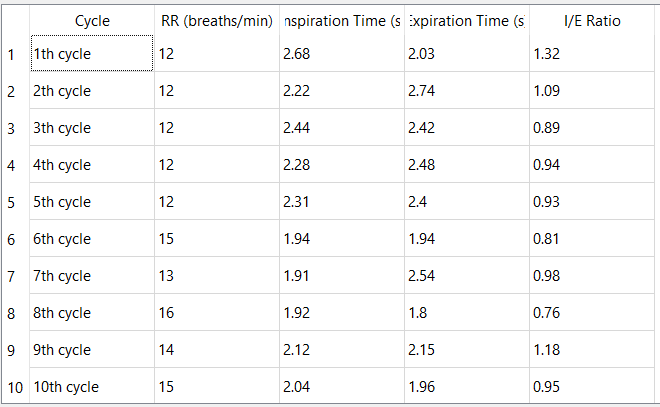
[picture p95: figure]

Protocol 3 Option 2 – Second

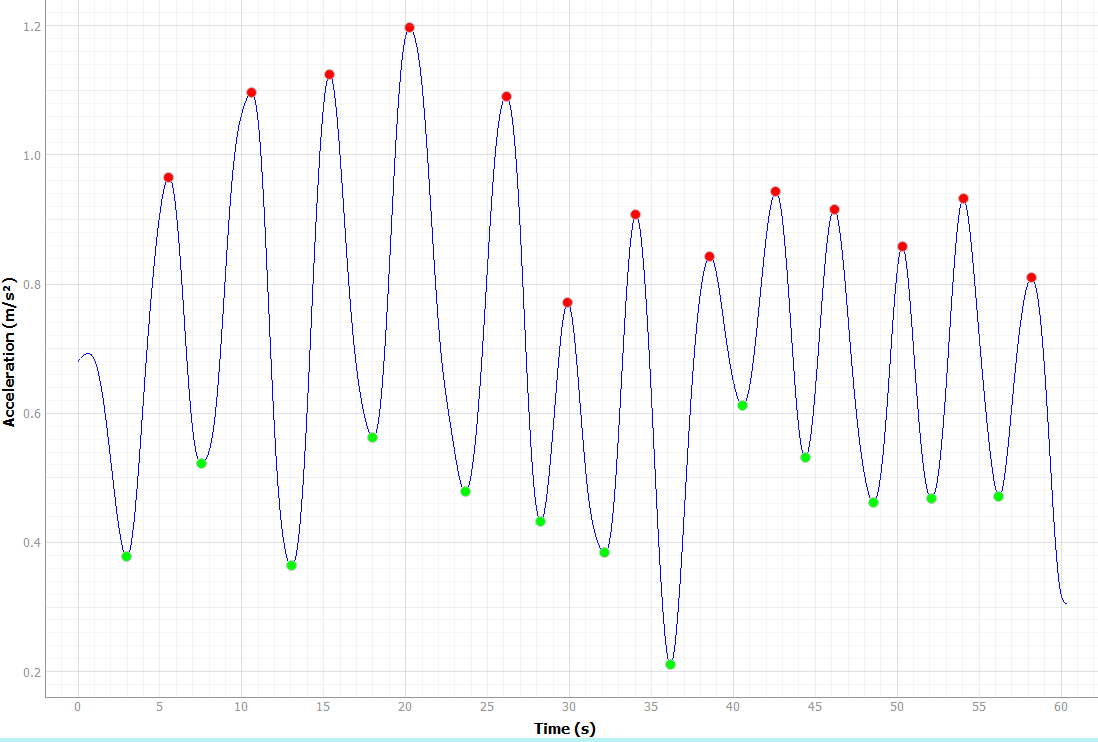
[picture p96: figure]
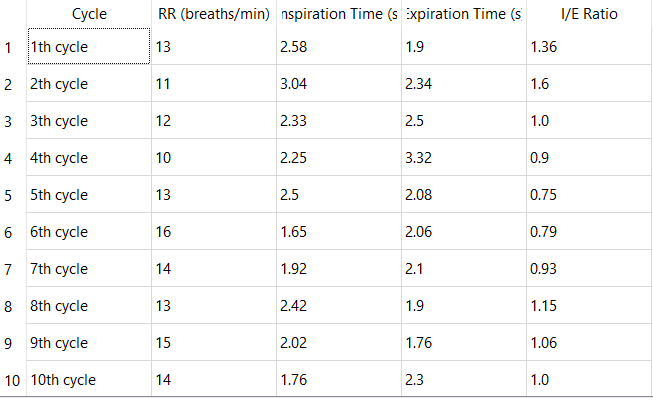
[picture p97: figure]

Protocol 3 Option 2 – Third

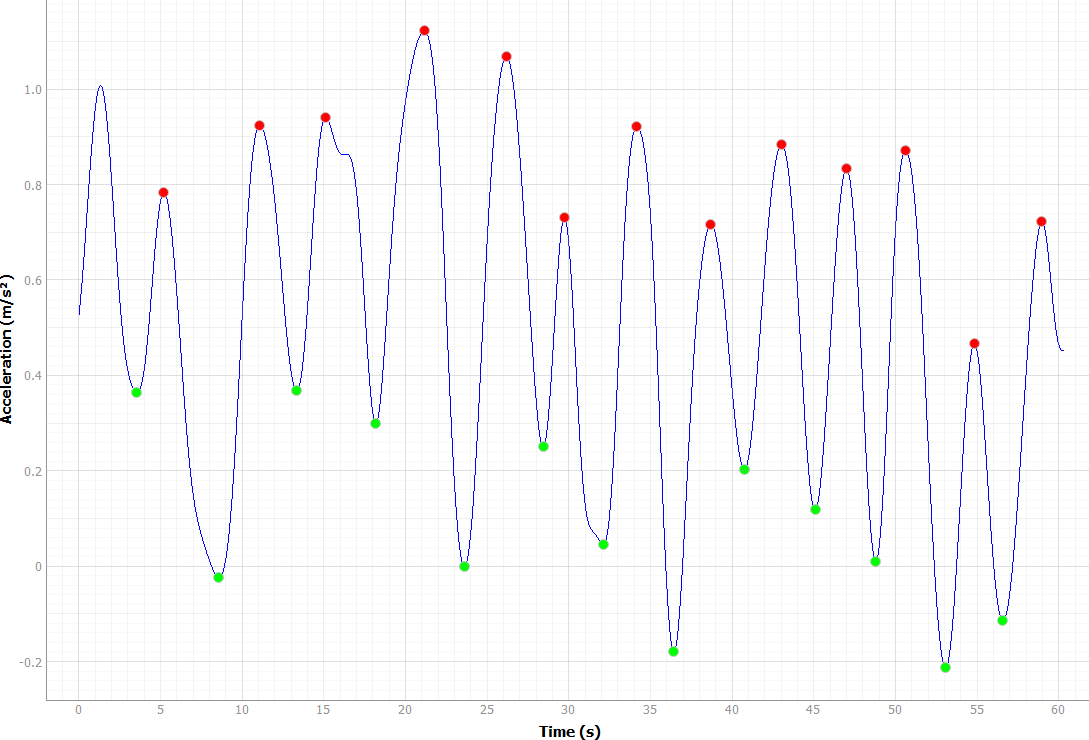
[picture p98: figure]
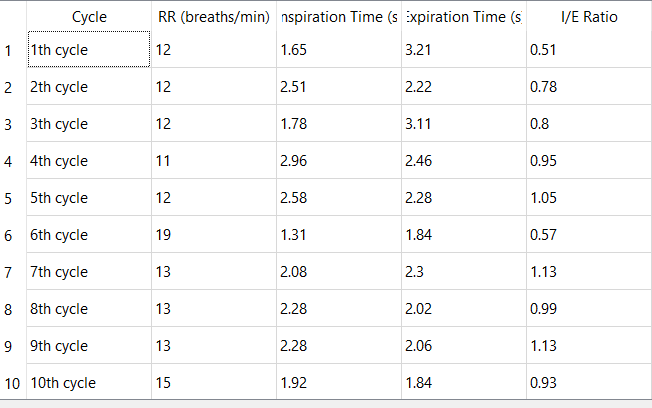
[picture p99: figure]

Protocol 3 Option 3 – First

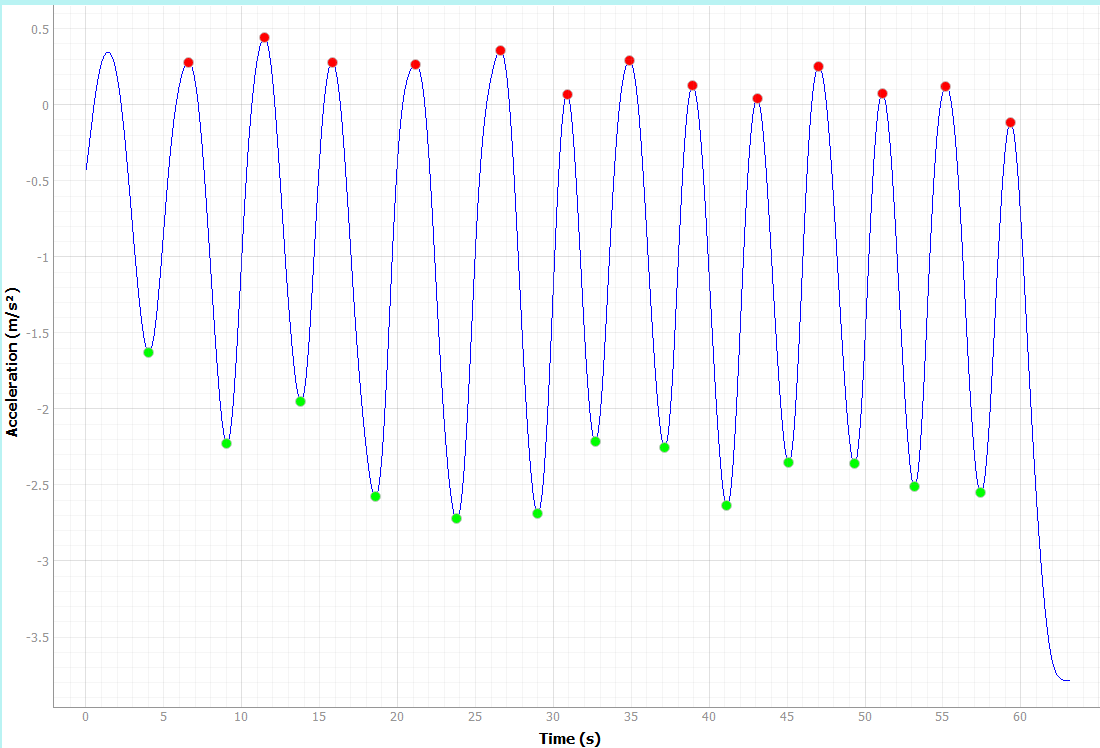
[picture p100: figure]
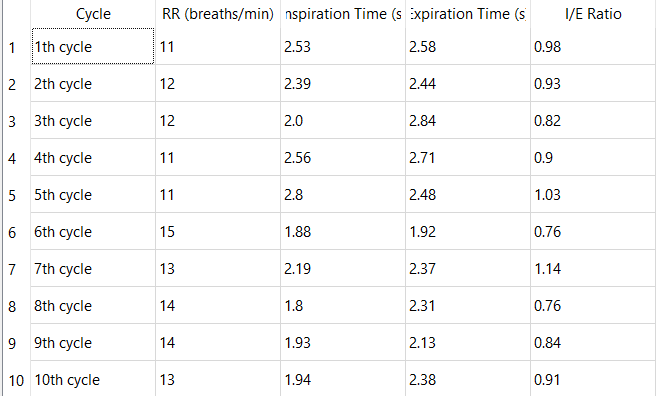
[picture p101: figure]

Protocol 3 Option 3 – Second

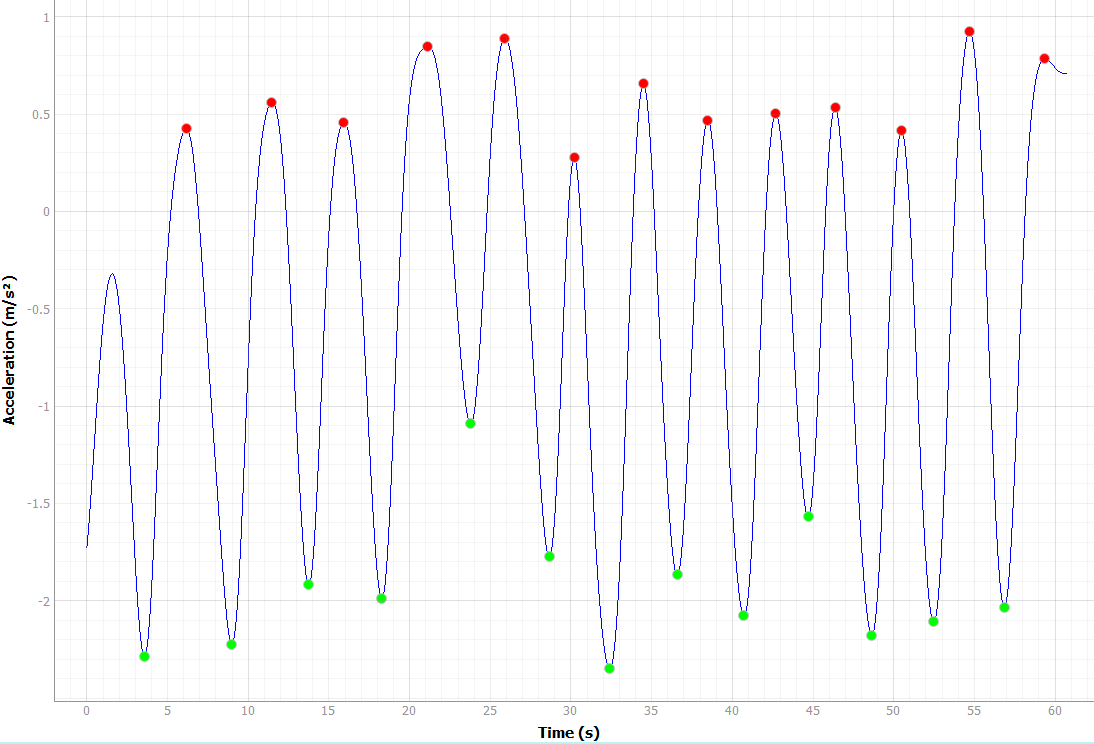
[picture p102: figure]
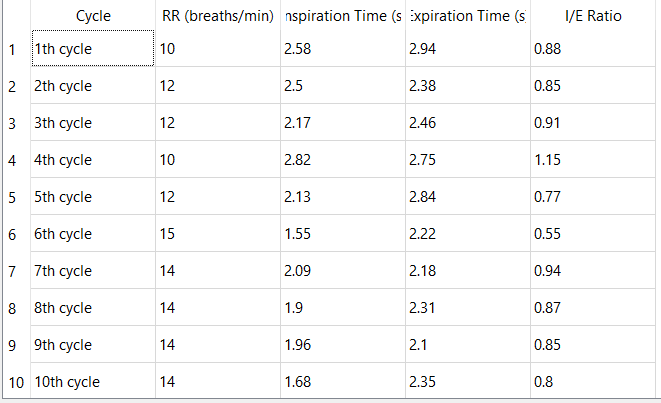
[picture p103: figure]

Protocol 3 Option 3 – Third

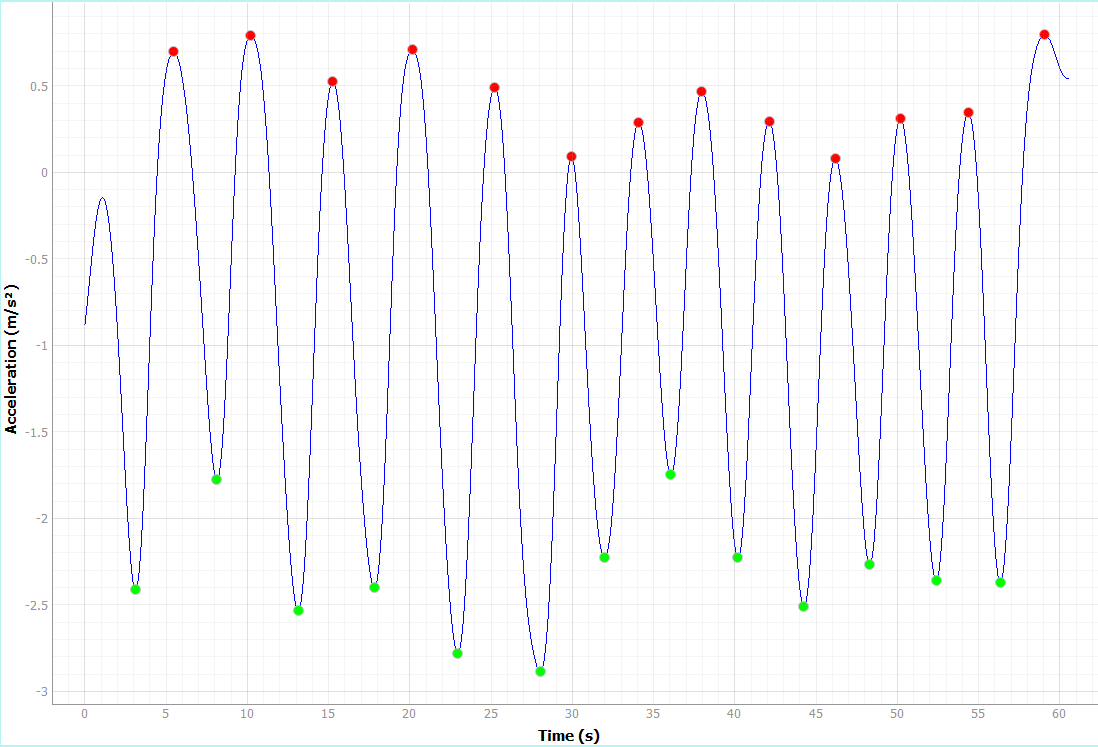
[picture p104: figure]
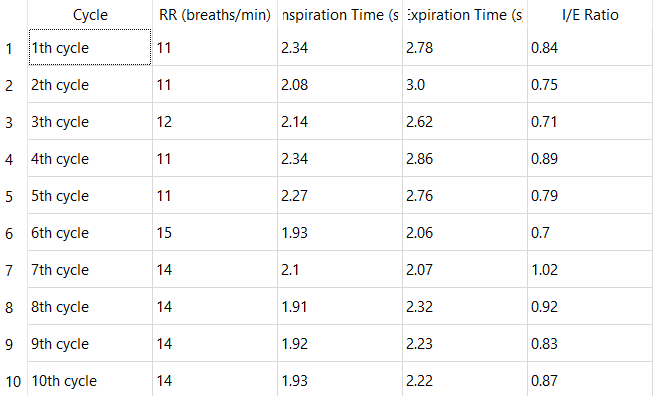
[picture p105: figure]

Protocol 3 Option 4 – First

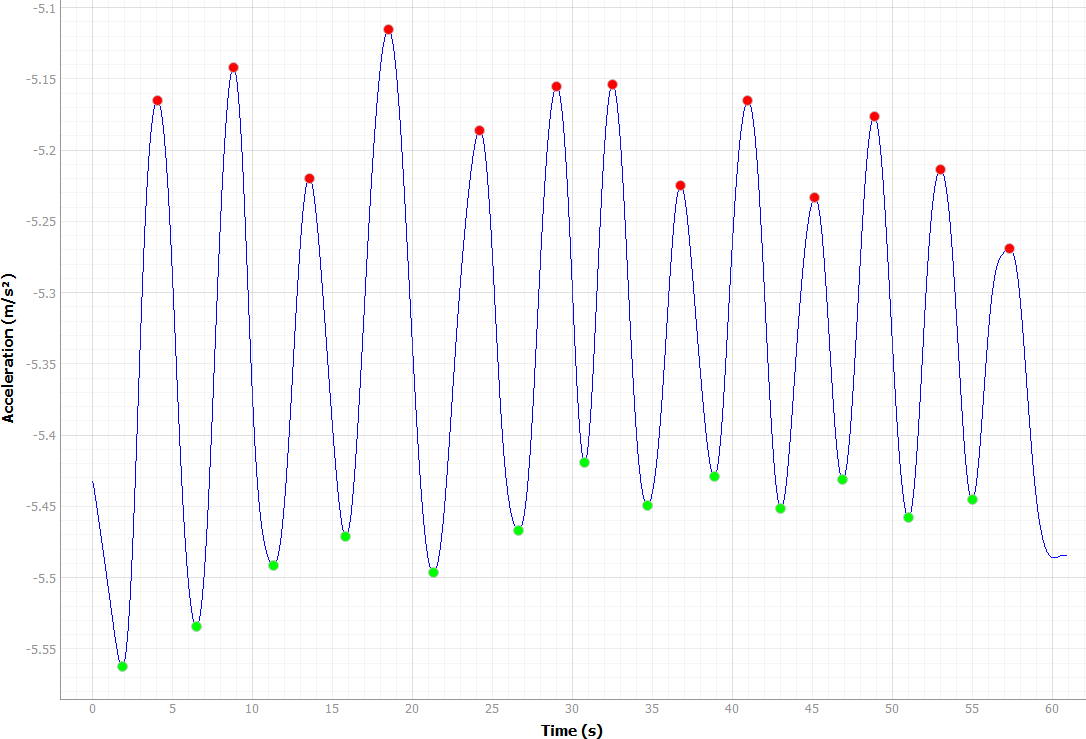
[picture p106: figure]
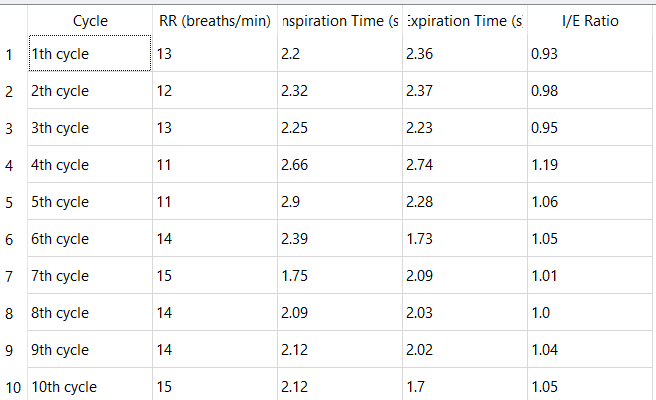
[picture p107: figure]

Protocol 3 Option 4 – Second

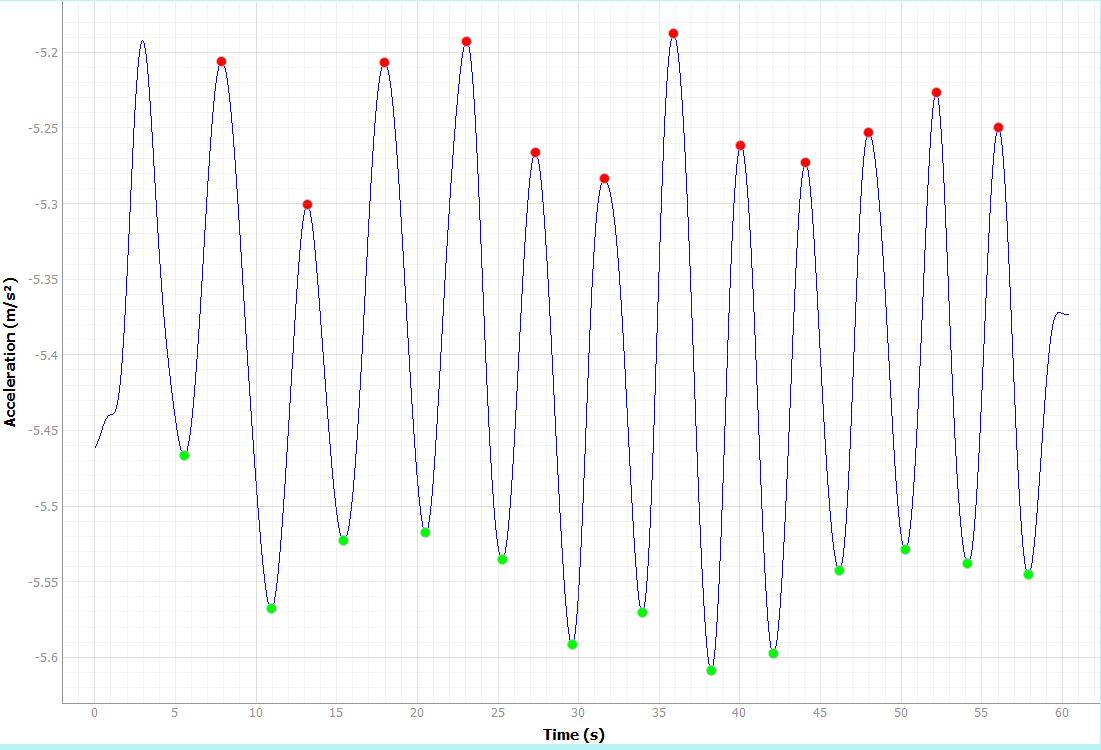
[picture p108: figure]
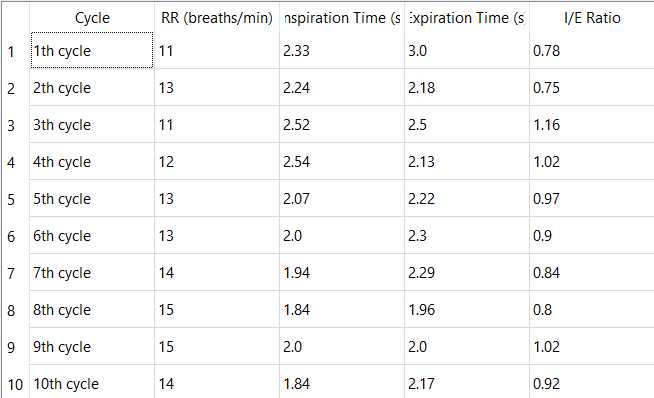
[picture p109: figure]

Protocol 3 Option 4 – Third

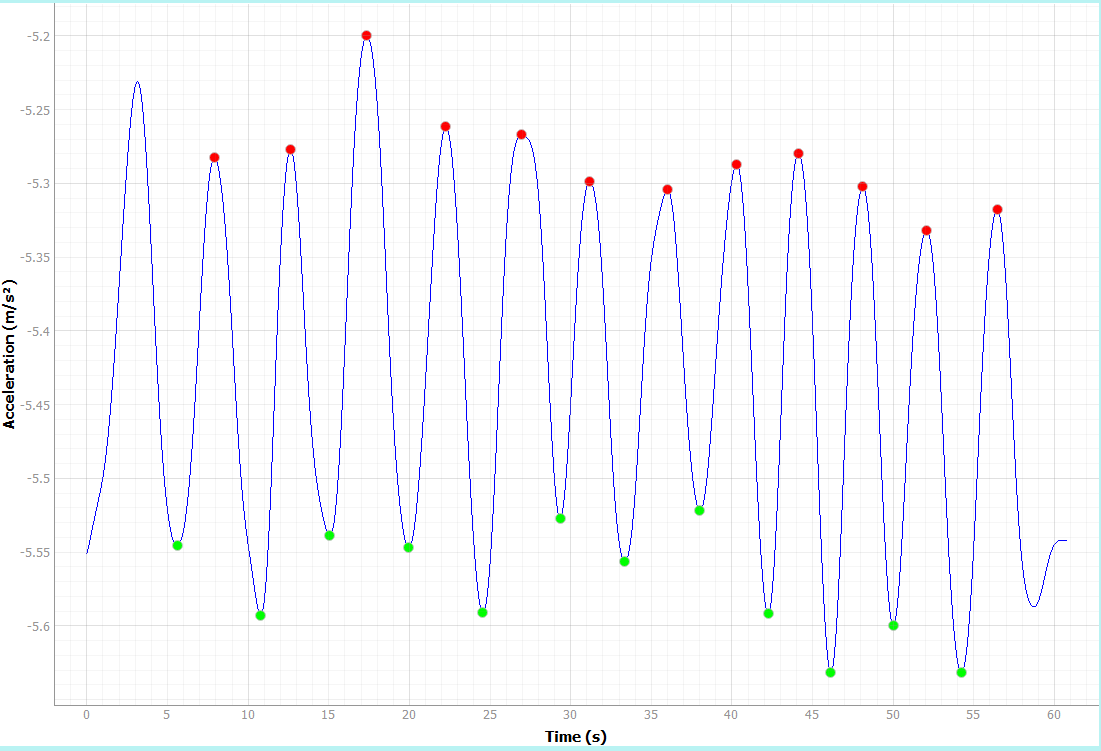
[picture p110: figure]
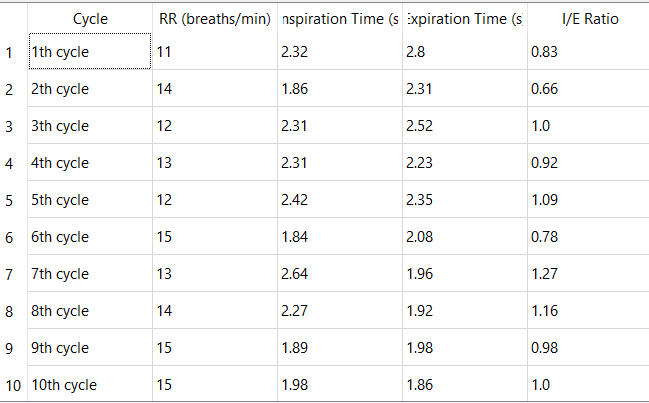
[picture p111: figure]

PROTOCOL 4

Protocol 4 Option 1 – First

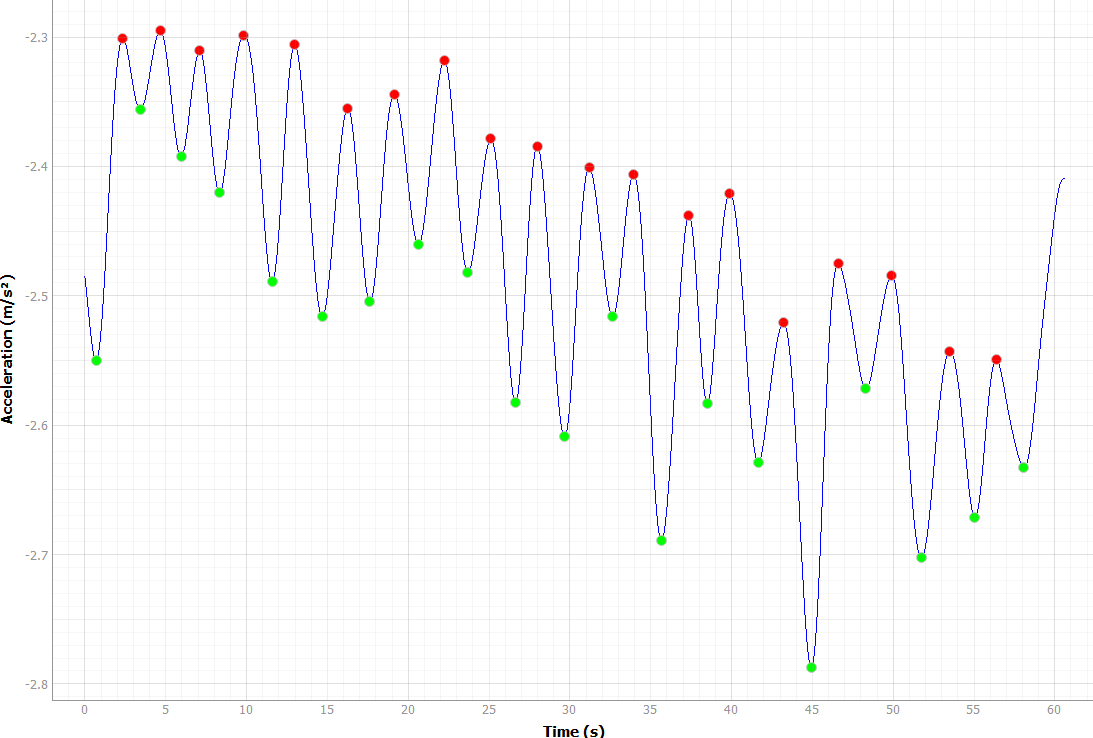
[picture p112: figure]
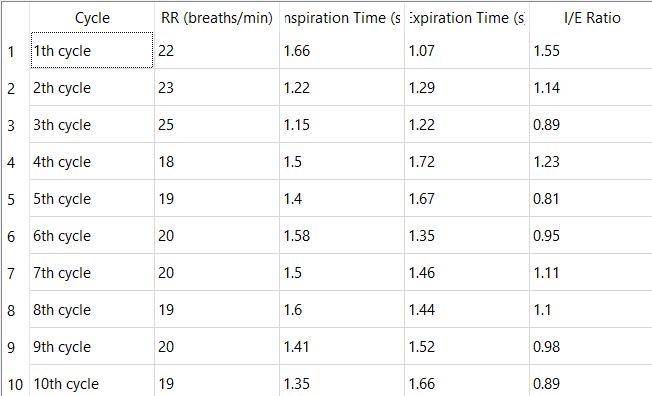
[picture p113: figure]
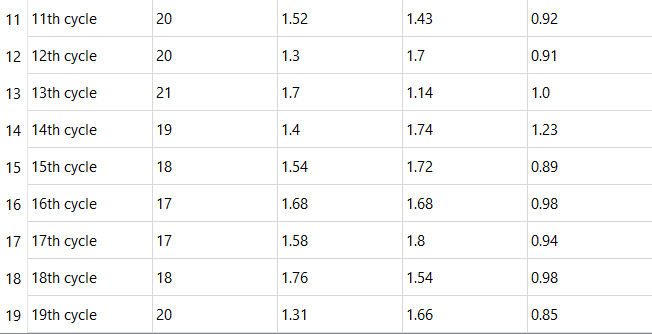
[picture p114: figure]

Protocol 4 Option 1 – Second

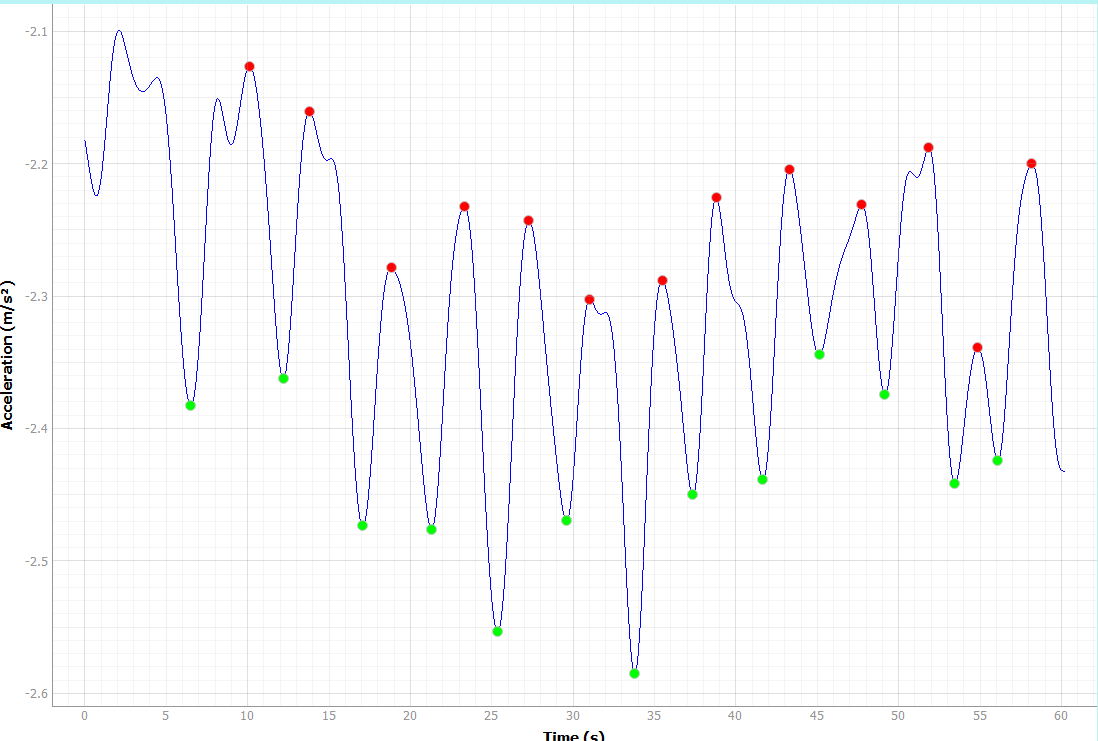
[picture p115: figure]
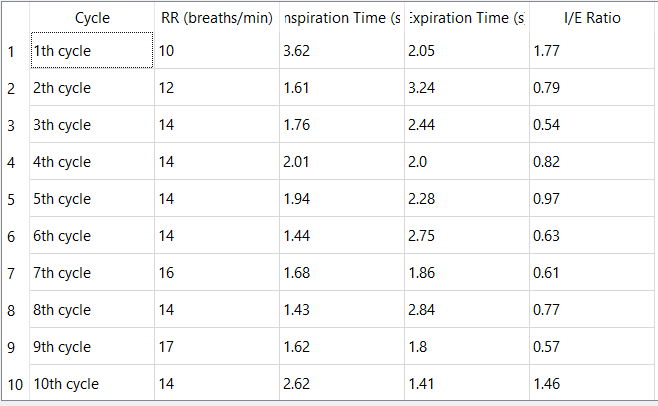
[picture p116: figure]

Protocol 4 Option 1 - Third

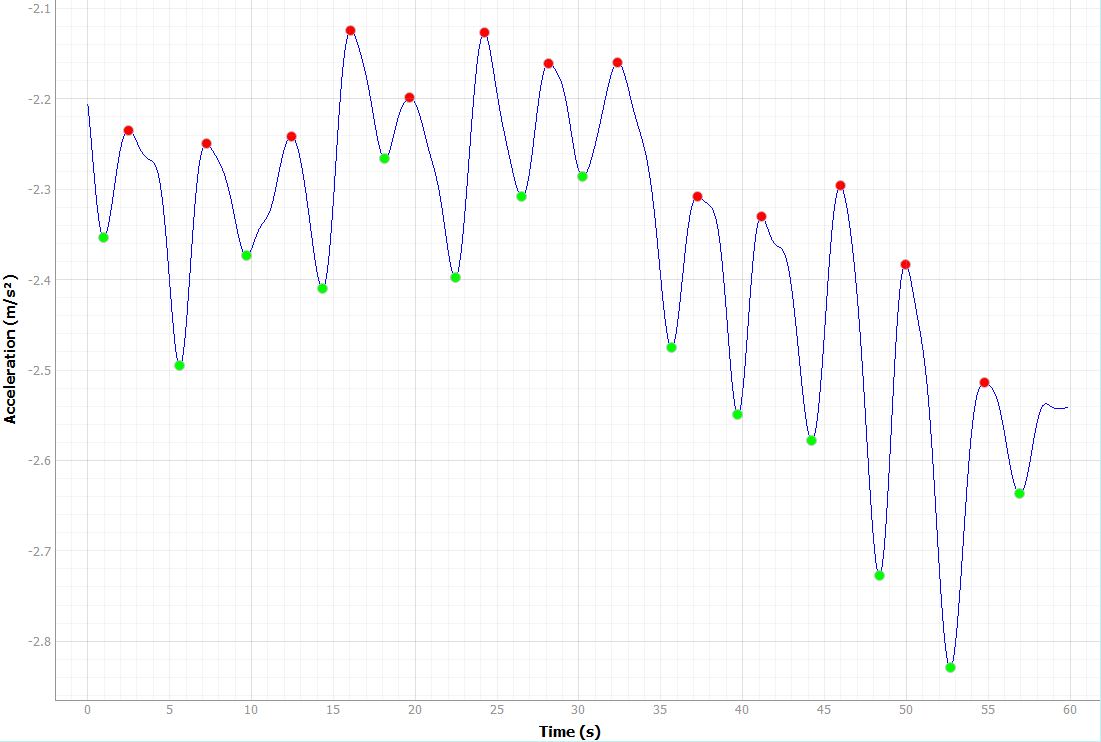
[picture p117: figure]
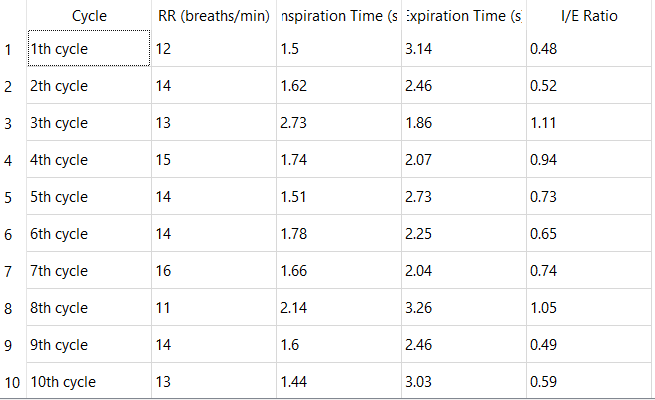
[picture p118: figure]

Protocol 4 Option 2 – First

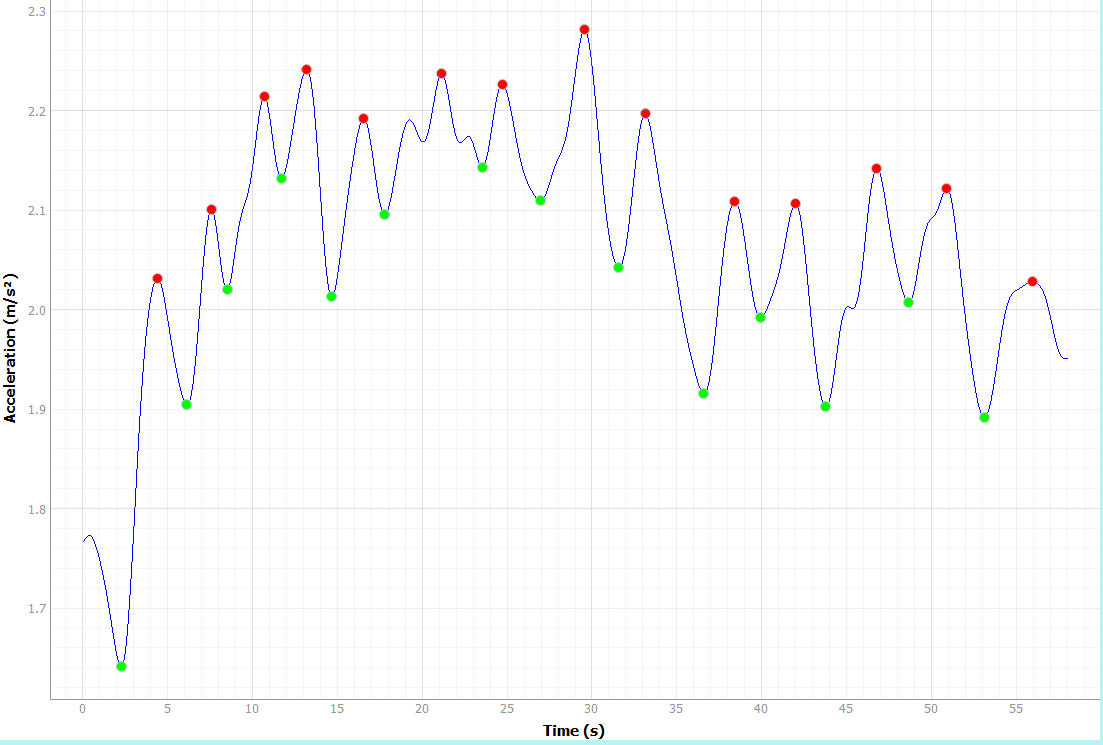
[picture p119: figure]
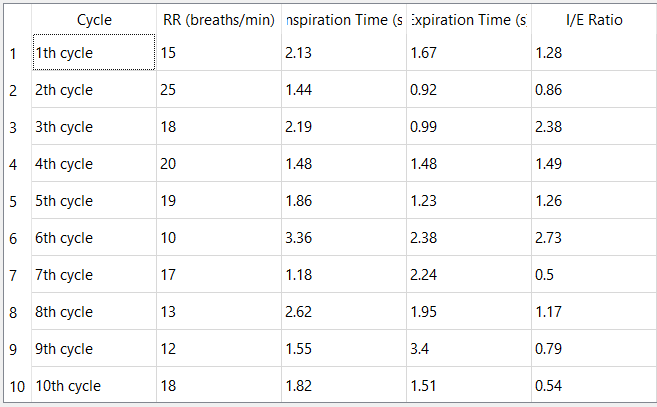
[picture p120: figure]

Protocol 4 Option 2 – Second

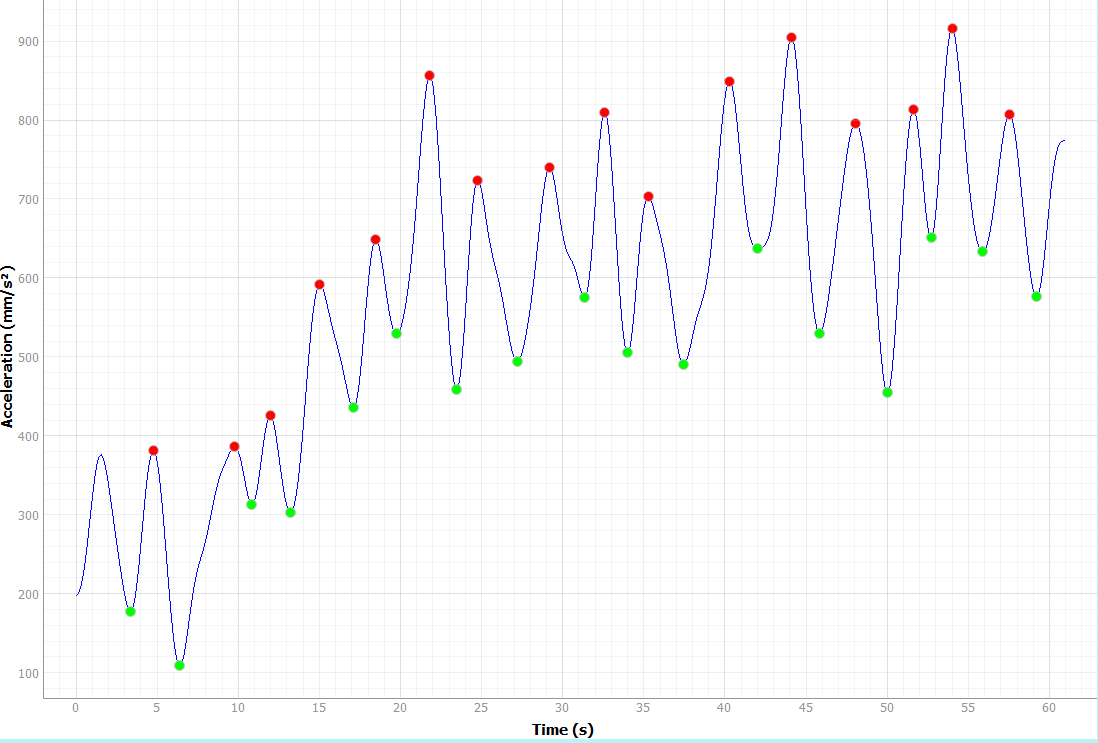
[picture p121: figure]
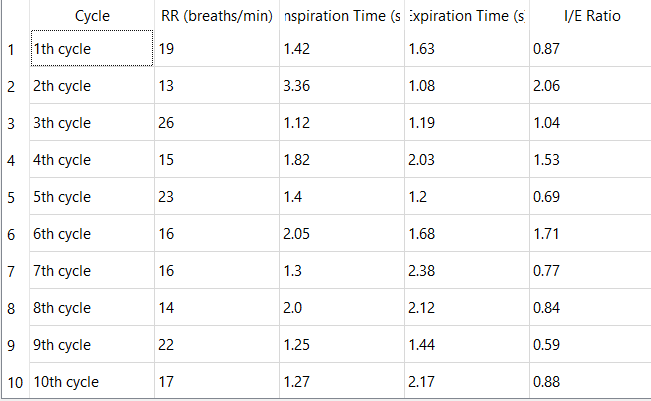
[picture p122: figure]
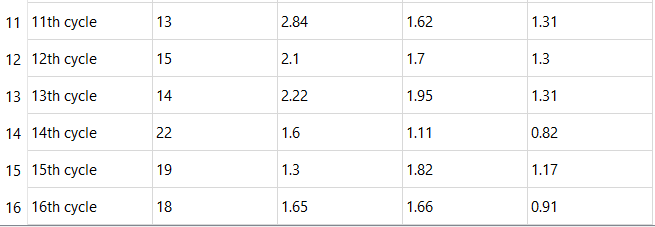
[picture p123: figure]

Protocol 4 Option 2 - Third

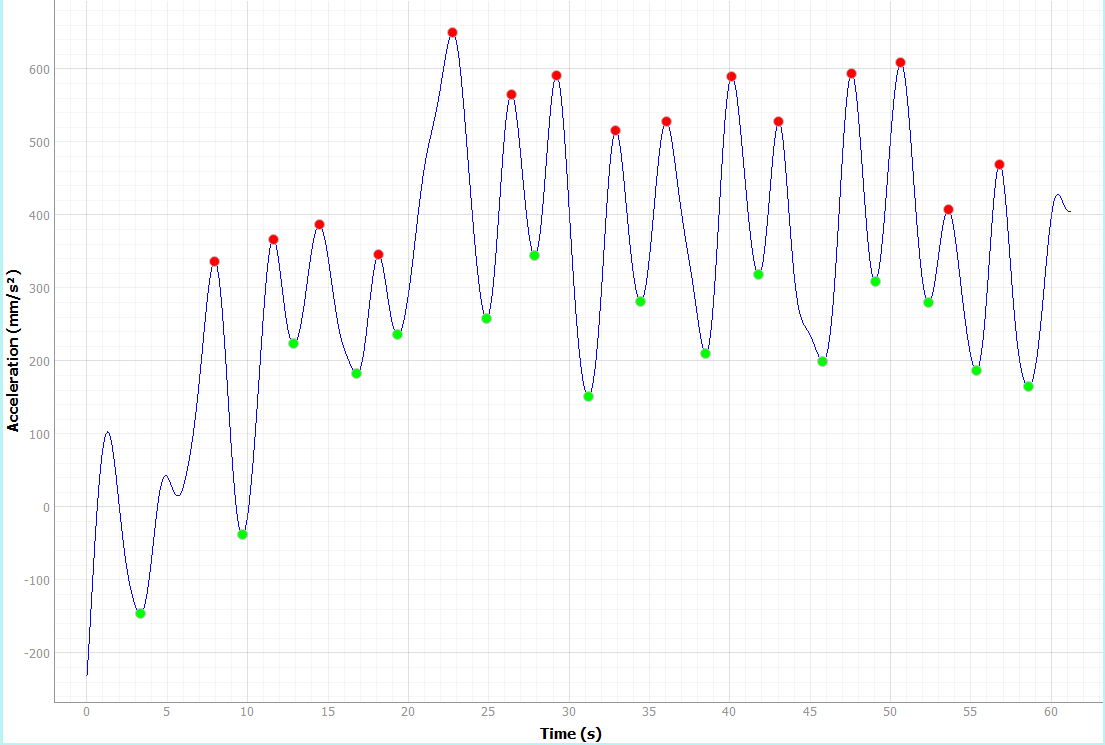
[picture p124: figure]
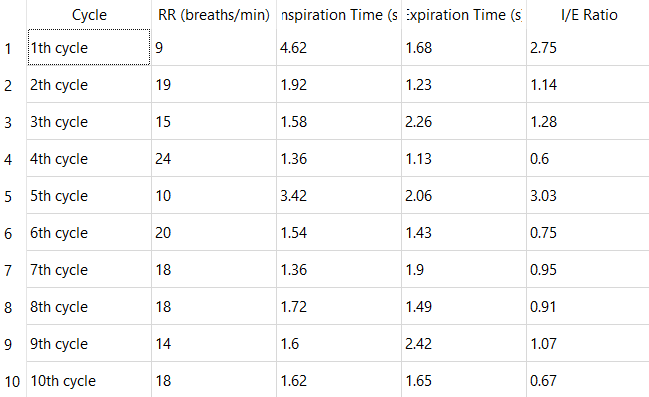
[picture p125: figure]
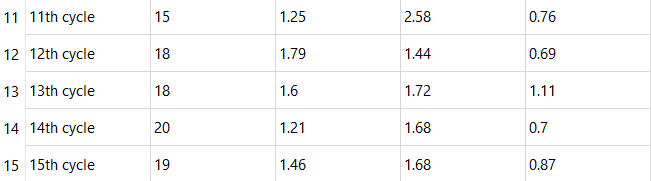
[picture p126: figure]

Protocol 4 Option 3 – First

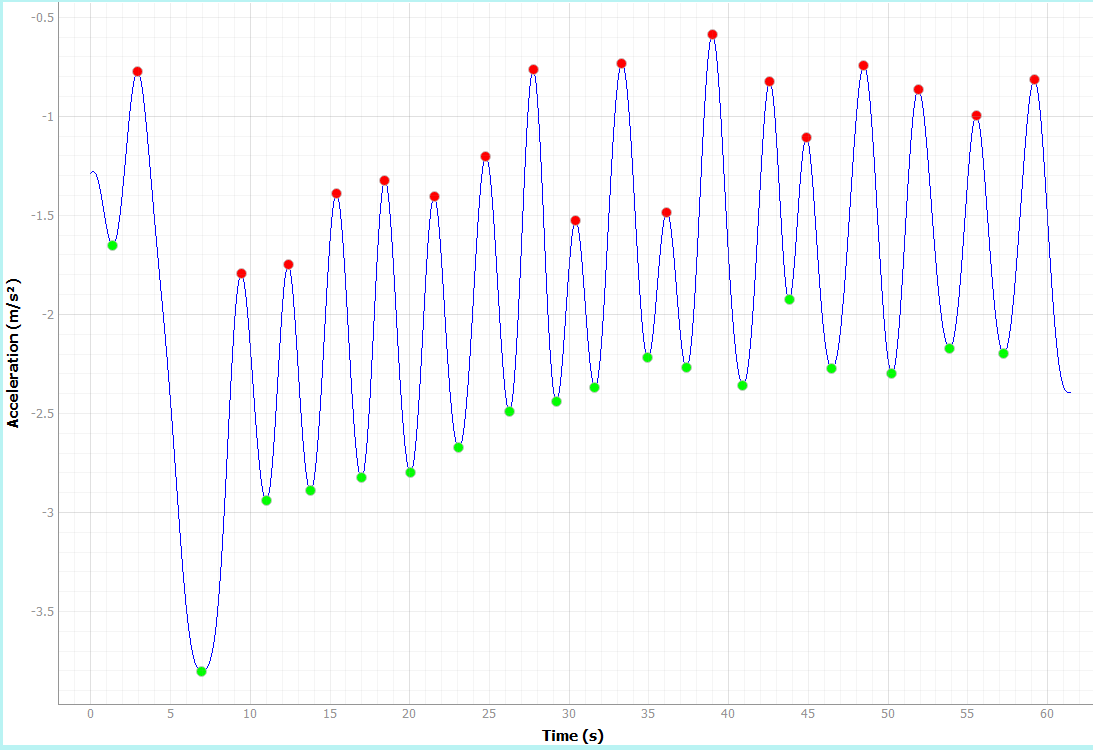
[picture p127: figure]
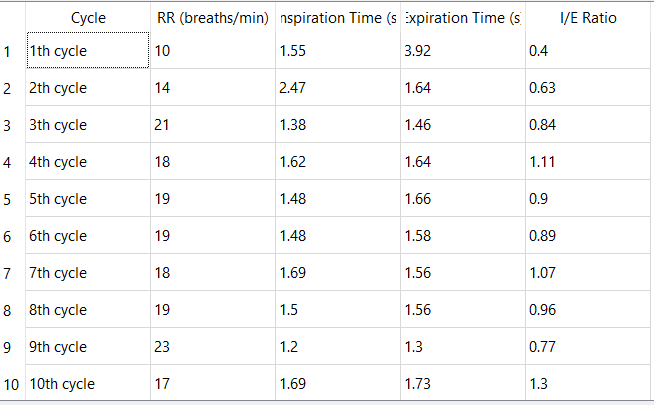
[picture p128: figure]
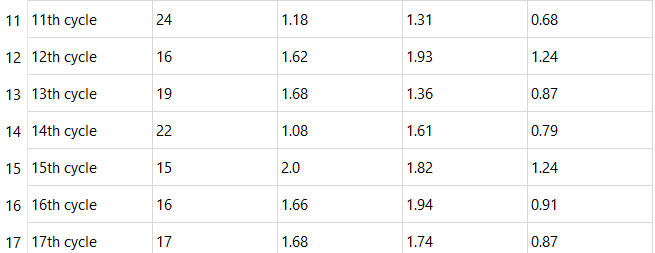
[picture p129: figure]

Protocol 4 Option 3 - Second

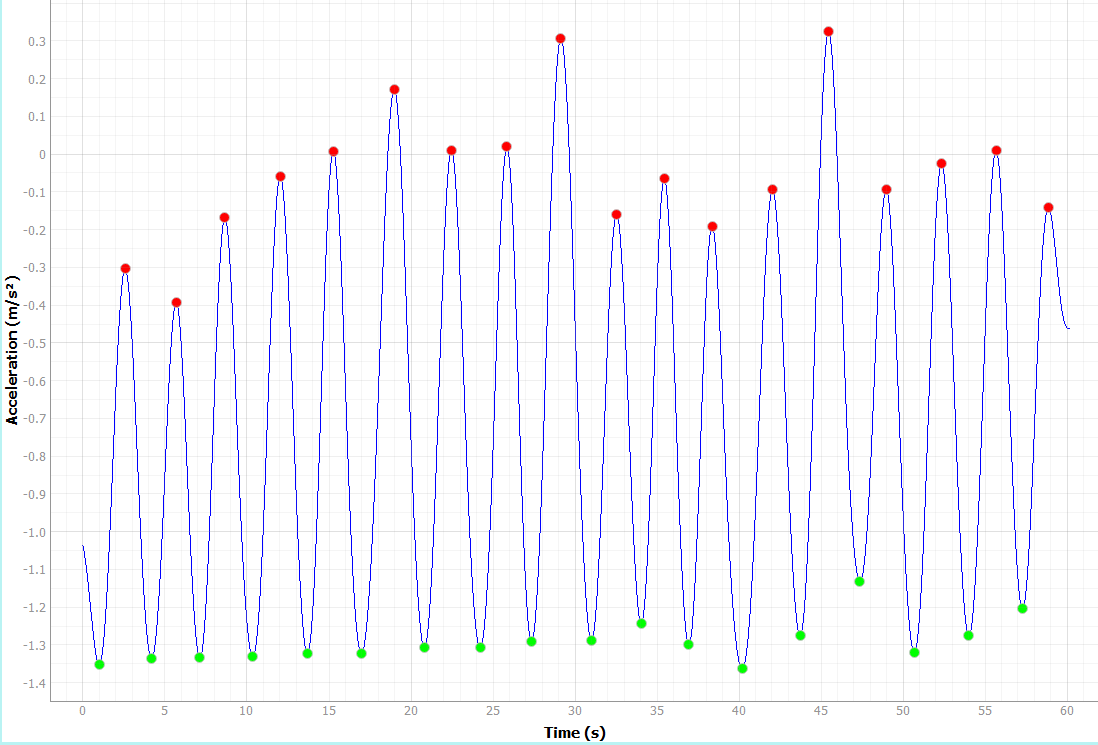
[picture p130: figure]
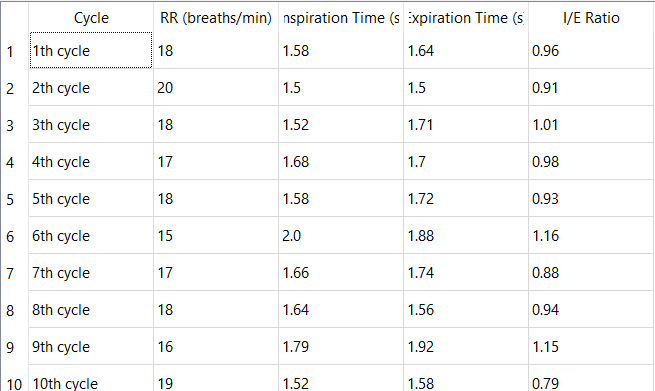
[picture p131: figure]
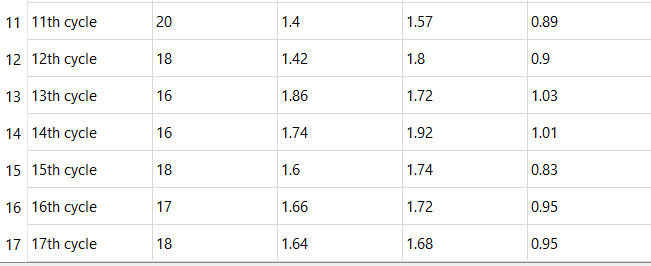
[picture p132: figure]

Protocol 4 Option 3 - Third

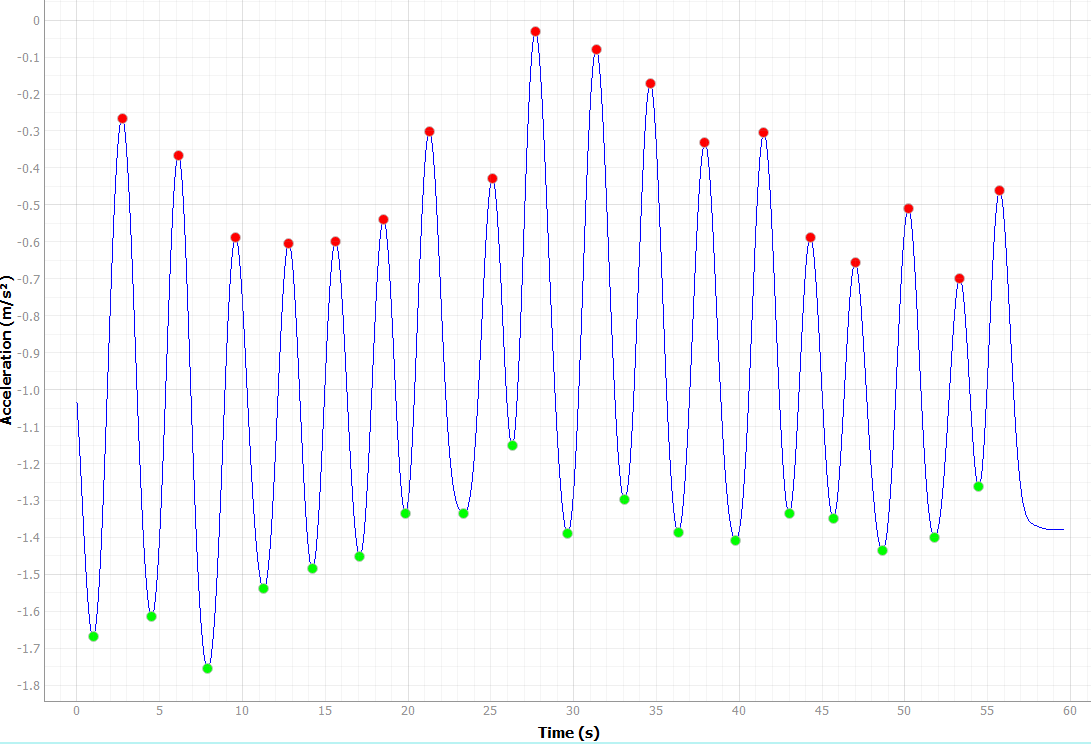
[picture p133: figure]
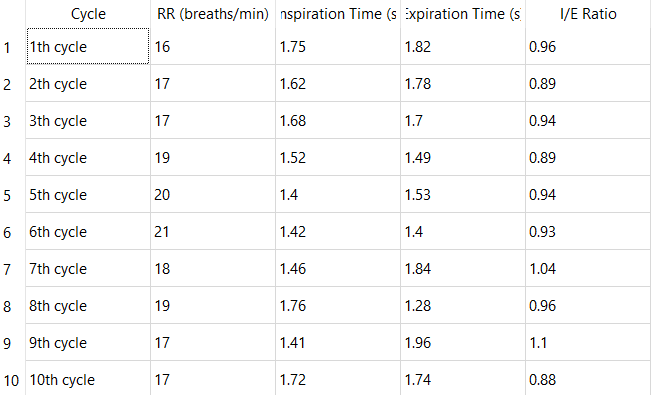
[picture p134: figure]
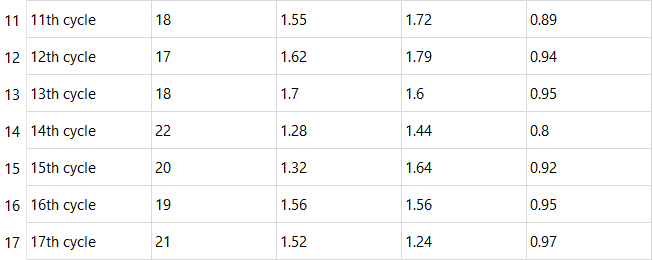
[picture p135: figure]

Protocol 4 Option 4 – First

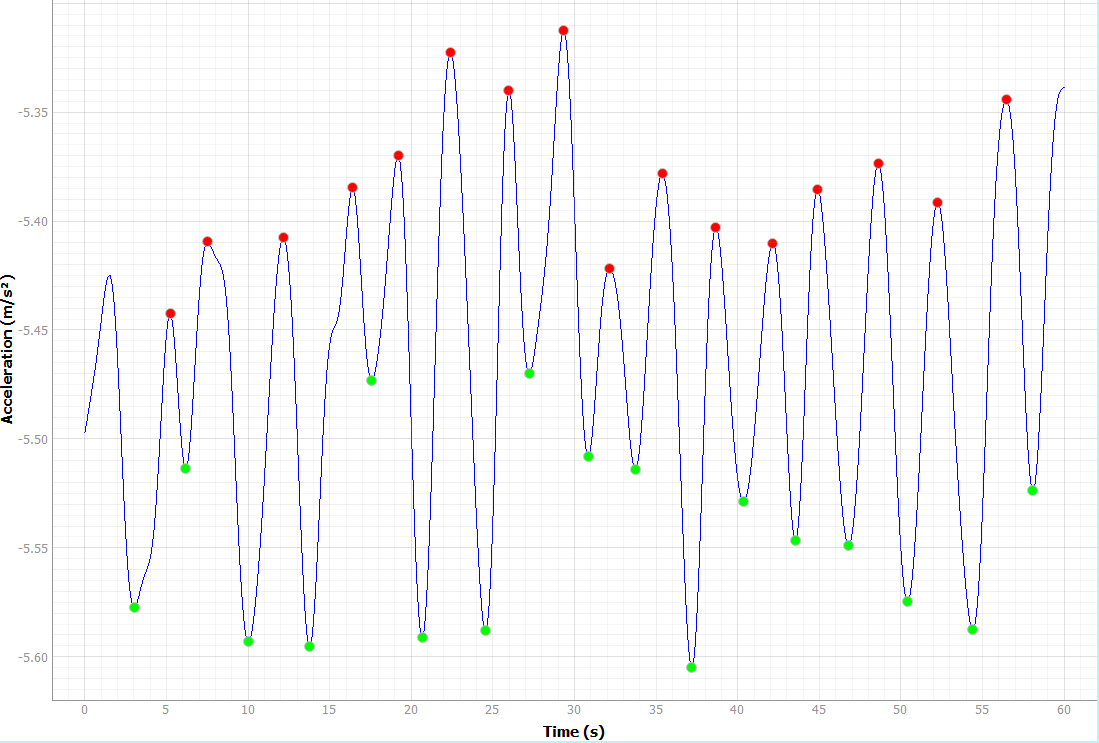
[picture p136: figure]
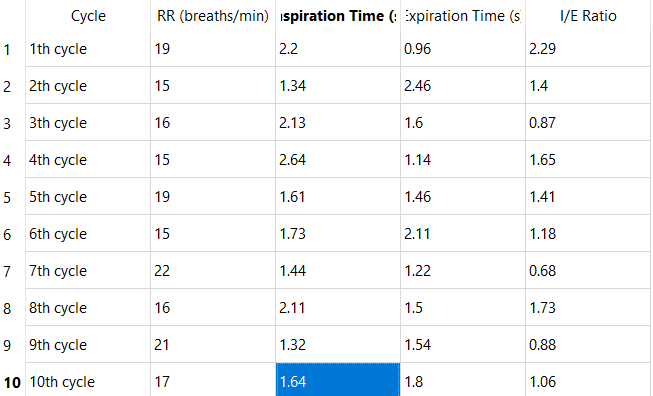
[picture p137: figure]
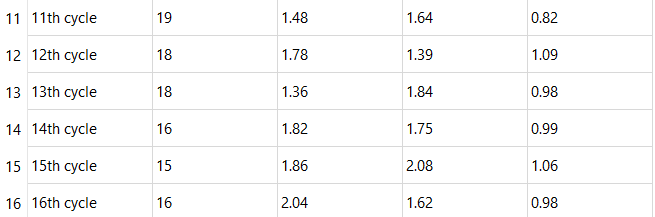
[picture p138: figure]

Protocol 4 Option 4 – Second

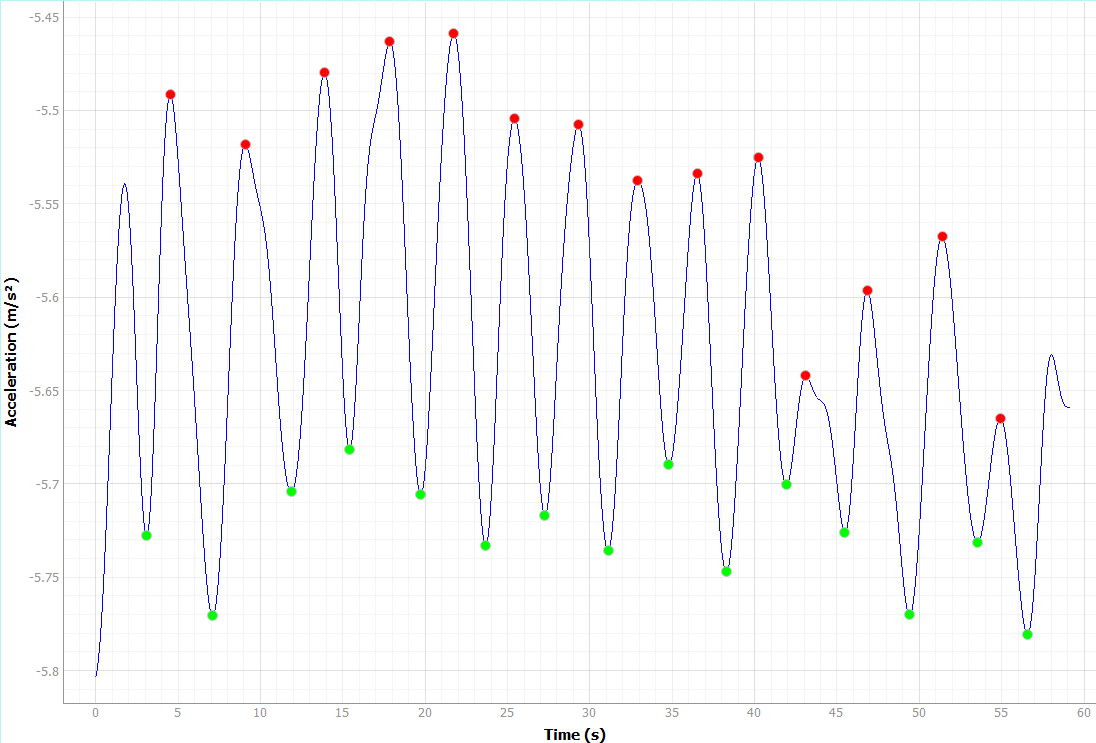
[picture p139: figure]
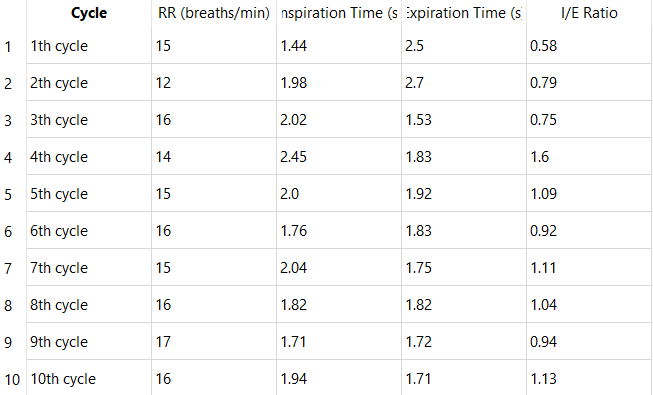
[picture p140: figure]

Protocol 4 Option 4 – Third

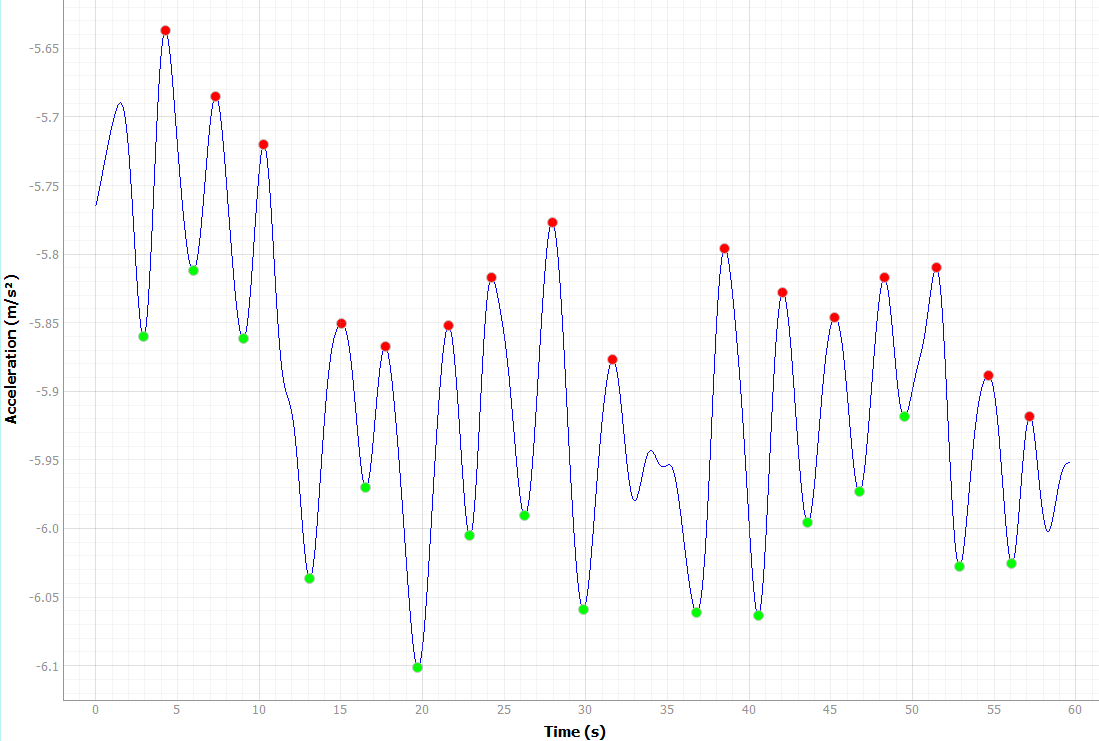
[picture p141: figure]
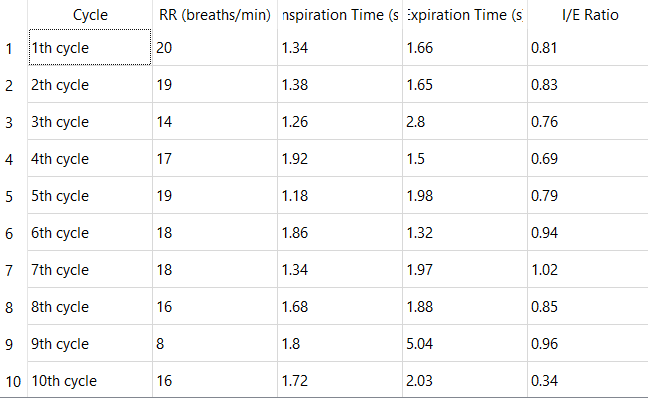
[picture p142: figure]
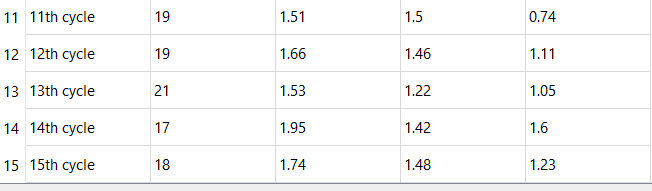
[picture p143: figure]

Weight Try Furkan:

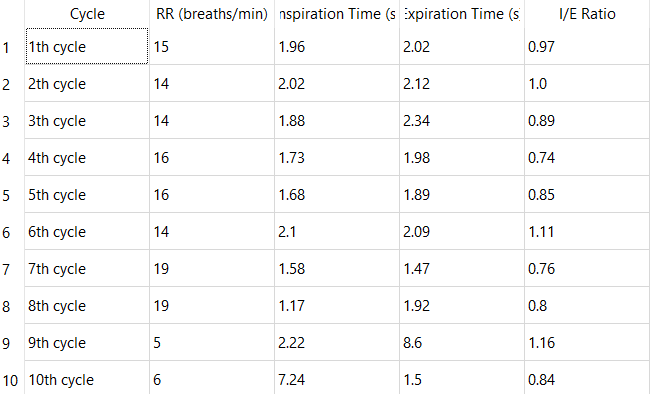
[picture p144: figure]
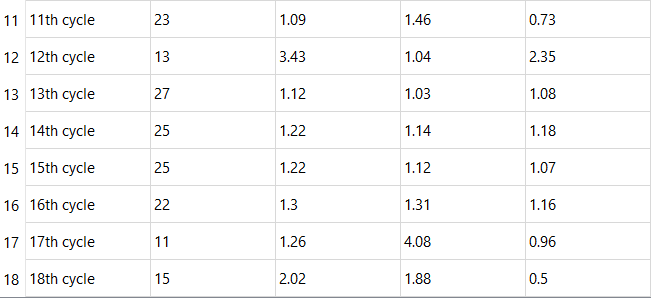
[picture p145: figure]
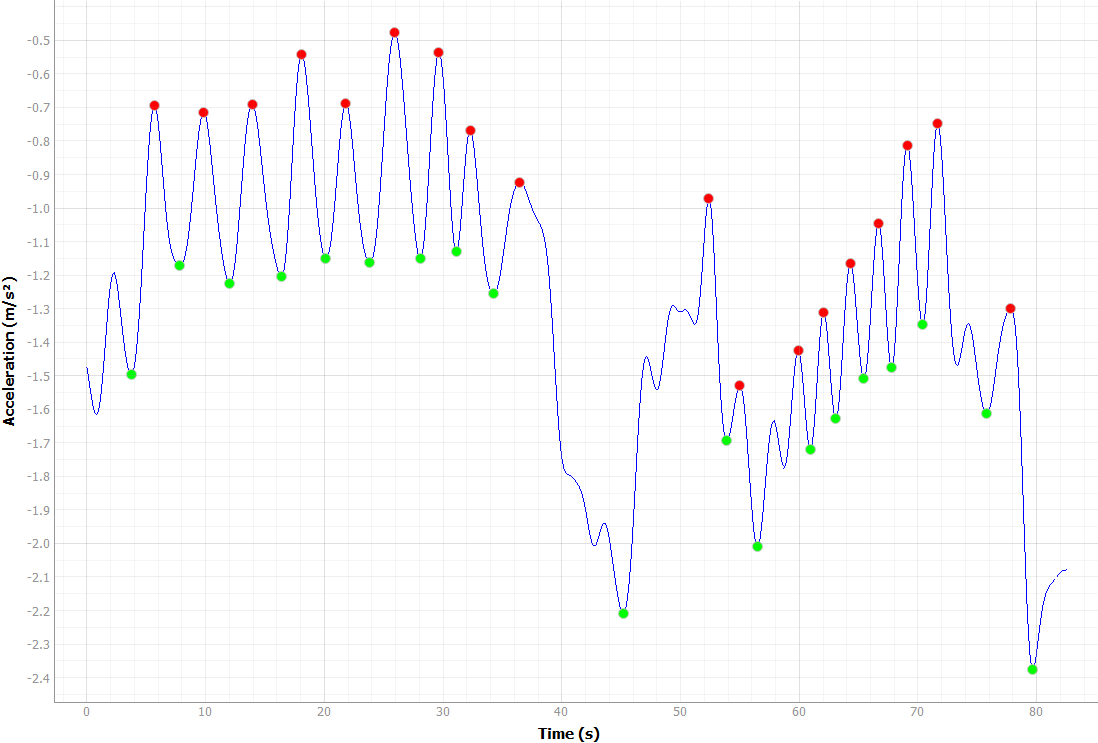
[picture p146: figure]
