GioVeronelli/BREATH/Images/BandSitting1.jpg

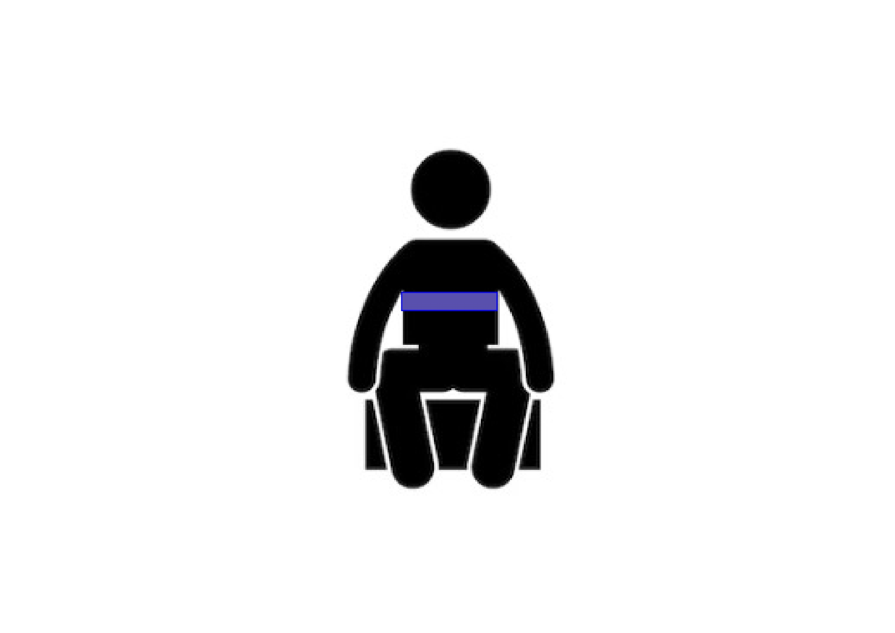
Images/BandSitting1.jpg
