GioVeronelli/BREATH/Images/BandSitting.jpg

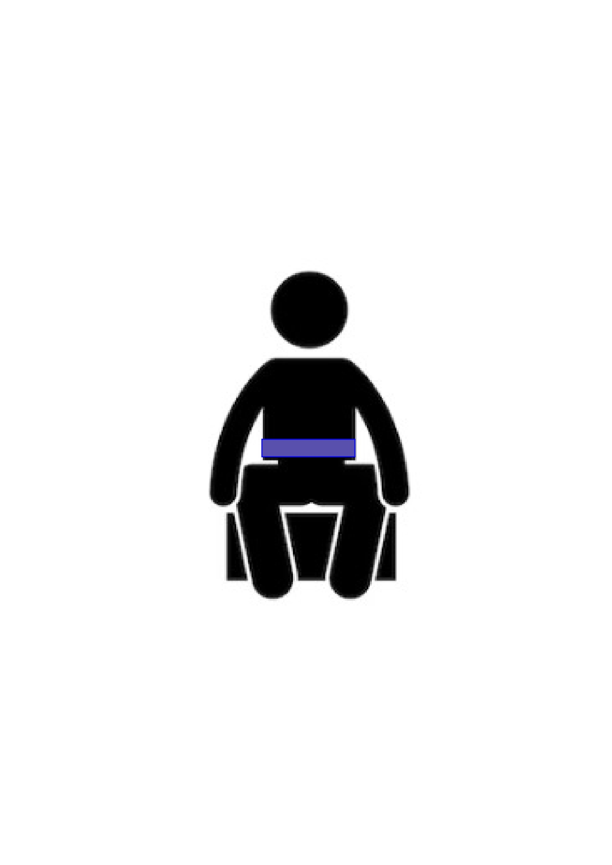
Images/BandSitting.jpg
