GioVeronelli/BREATH/Images/Custom_ISR_Data.jpg

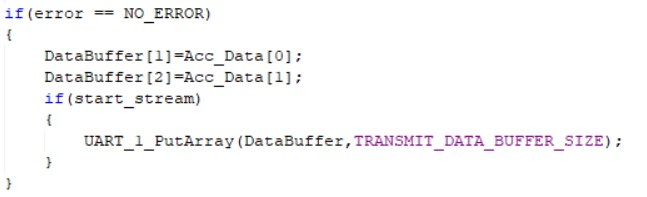
Images/Custom_ISR_Data.jpg
