GioVeronelli/BREATH/Images/First_RT_Acq.png

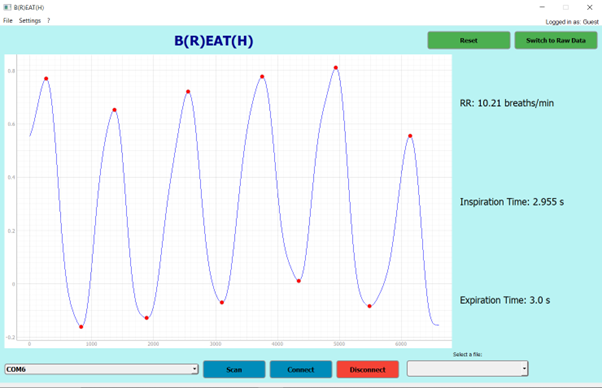
Images/First_RT_Acq.png
