GioVeronelli/BREATH/Images/GUI_ReadData.png

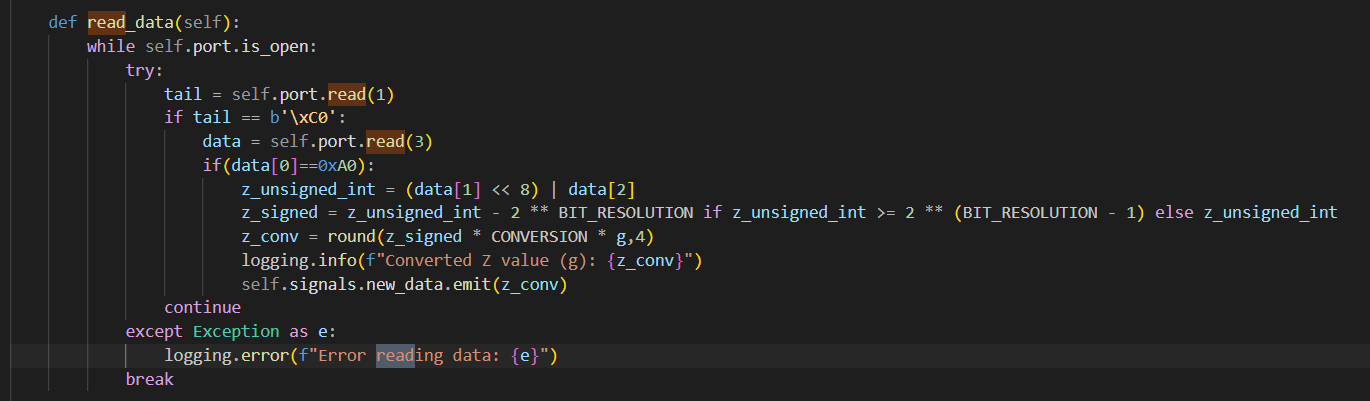
Images/GUI_ReadData.png
