GioVeronelli/BREATH/Images/InterruptRoutines.png

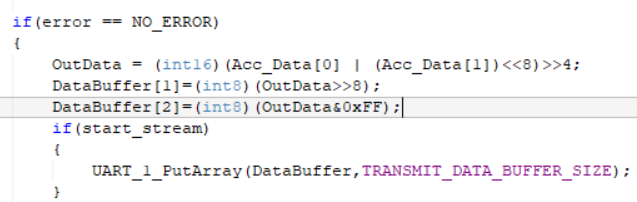
Images/InterruptRoutines.png
