GioVeronelli/BREATH/Images/PCB.jpg

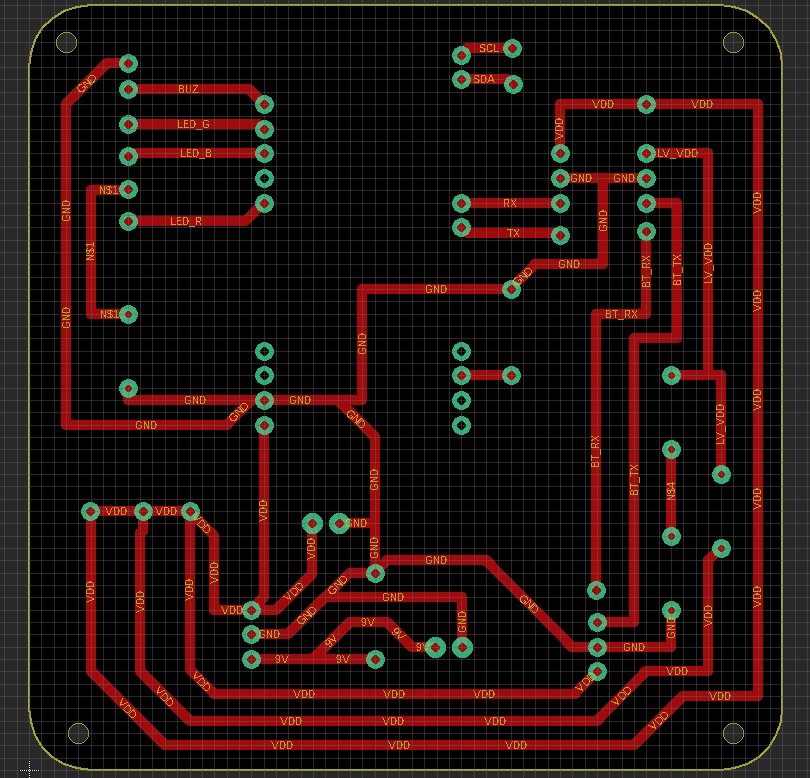
Images/PCB.jpg
