GioVeronelli/BREATH/Images/Pins.jpg

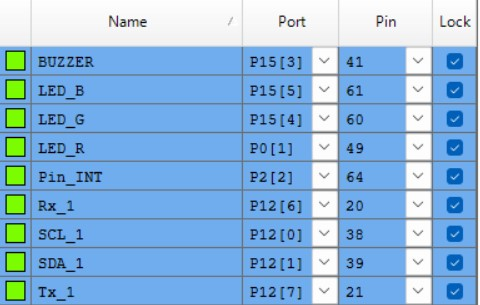
Images/Pins.jpg
