GioVeronelli/BREATH/Images/Raw_Acquisition1.jpg

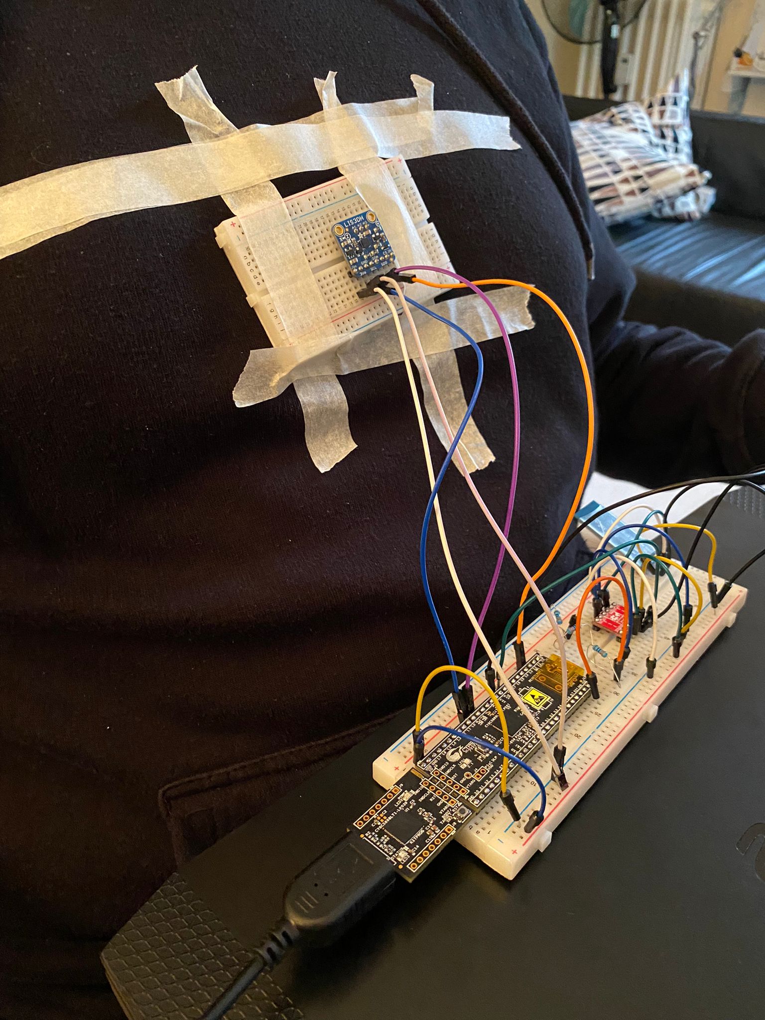
Images/Raw_Acquisition1.jpg
