GioVeronelli/BREATH/Images/Raw_Acquisition2.jpg

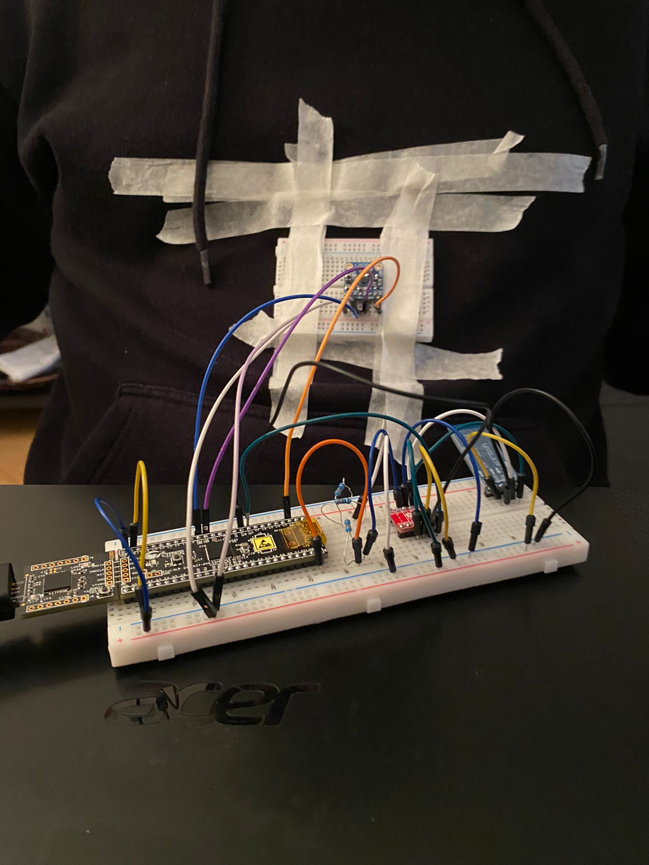
Images/Raw_Acquisition2.jpg
