GioVeronelli/BREATH/Images/Raw_Acquisition3.jpg

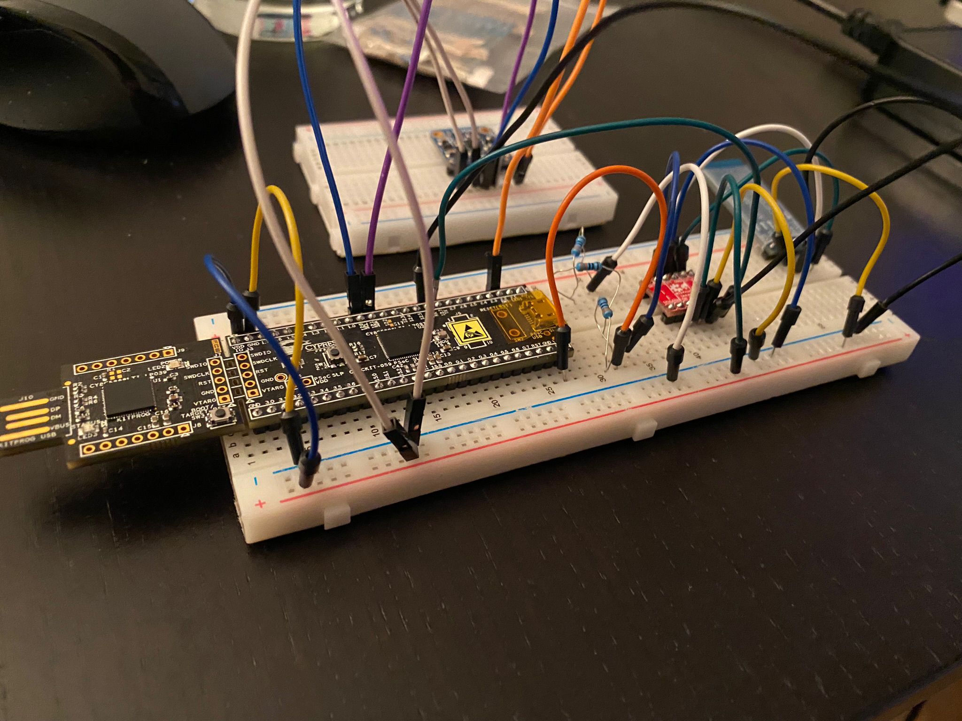
Images/Raw_Acquisition3.jpg
