GioVeronelli/BREATH/Images/TopDesign.jpg

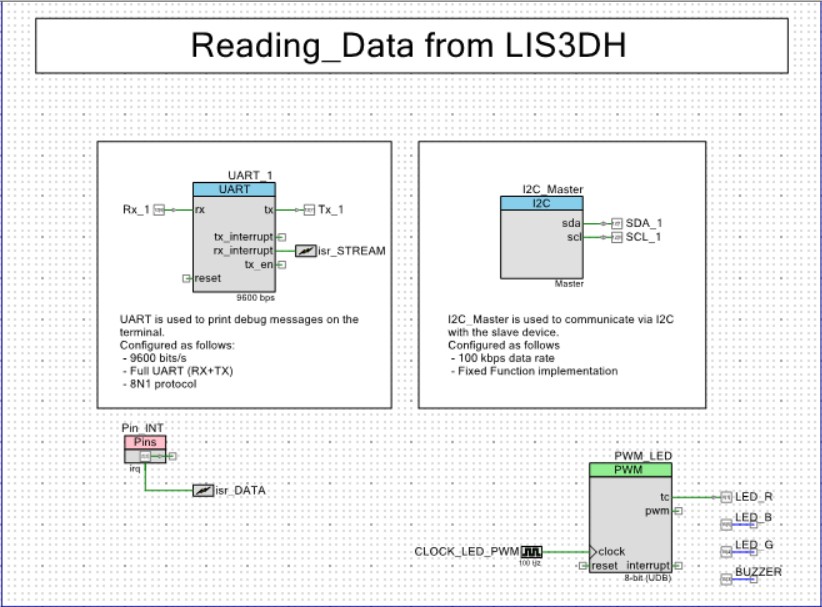
Images/TopDesign.jpg
