GioVeronelli/BREATH/Data_acquired/Guest_B(R)EAT(H)_Test_00-23-57_00-24-56.csv

Raw Data
-0.7063
-1.3342
-0.8633
-1.0595
-0.824
-1.1772
-1.0595
-0.7456
-0.6671
-1.0987
-0.5886
-1.0987
-0.8633
-0.4709
-0.8633
-1.0202
-1.3734
-1.2949
-1.5696
-0.9025
-0.6278
-0.7063
-0.8633
-0.6278
-1.138
-0.5886
-0.824
-0.7848
-0.5886
-1.0202
-1.0595
-0.8633
-1.2949
-1.0202
-0.9025
-1.4126
-1.1772
-1.2164
-1.4519
-0.7848
-0.7063
-1.2164
-1.0595
-0.9418
-1.1772
-0.9025
-0.981
-1.3734
-1.5304
-1.2949
-1.3734
-1.4519
-1.2164
-1.4126
-1.2949
-0.9418
-0.824
-1.138
-1.0595
-0.7848
-1.2557
-1.2949
-1.4126
-1.4911
-1.2557
-1.3734
-1.2557
-0.9418
-1.1772
-1.3734
-1.0202
-1.1772
-1.0987
-0.981
-0.9418
-0.7063
-0.981
-0.7456
-1.0595
-1.0595
-1.2557
-0.981
-1.0595
-1.2949
-1.1772
-1.0595
-0.981
-1.5304
-1.4126
-1.4519
-1.2164
-1.5696
-1.5696
-1.138
-0.9025
-1.4126
-0.824
-1.3342
-1.4126
-1.0595
-1.0595
-0.7456
-0.824
-0.5886
-1.2557
-1.0202
-1.0595
-1.4519
-1.3734
-1.2164
-1.2164
-1.3734
-1.1772
-1.5696
-1.3342
-0.981
-1.2164
-0.981
-0.9025
-1.5696
-1.0987
-1.2164
-1.2164
-1.1772
-1.5696
-1.0595
-1.2164
-1.4911
-1.1772
-1.4126
-1.4519
-1.2164
-1.7658
-1.6481
-1.5304
-1.5696
-1.0202
-1.4911
-1.2949
-1.6088
-1.4126
-1.4519
-0.9025
-0.981
-1.3342
-0.9025
-1.138
-1.8443
-1.1772
-1.6481
-1.2949
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
