GioVeronelli/BREATH/Data_acquired/Guest_B(R)EAT(H)_Test_00-30-52_00-31-54.csv

Raw Data
-0.7456
-0.5101
-0.7848
-1.0987
-0.7063
-0.6671
-1.0202
-0.7848
-1.1772
-0.7848
-0.7063
-0.5886
-0.7848
-1.0595
-1.0595
-0.9418
-1.138
-0.9418
-0.6671
-1.0202
-0.7063
-0.5494
-0.7848
-0.824
-0.5886
-0.981
-0.6671
-0.9025
-1.138
-0.9025
-0.824
-1.138
-0.9418
-0.9418
-0.9025
-0.981
-0.6671
-0.5494
-0.7456
-0.6671
-0.981
-0.824
-1.0595
-0.7063
-0.6278
-0.3924
-0.8633
-0.981
-0.981
-0.7848
-1.0987
-0.9025
-0.5494
-0.6278
-1.0202
-0.5101
-0.5886
-0.824
-1.0202
-0.6671
-0.3924
-1.0987
-0.7063
-0.7848
-0.4316
-0.4709
-1.0202
-0.824
-0.8633
-0.981
-0.7848
-0.6278
-0.9418
-1.0595
-0.4316
-0.6671
-0.7848
-0.3532
-0.7456
-0.9025
-1.2949
-1.2164
-1.3342
-1.0202
-0.4709
-0.1177
-0.981
-0.7848
-0.4709
-1.2164
-0.981
-0.7456
-0.7848
-1.138
-0.7848
-1.138
-0.9025
-0.8633
-0.4316
-0.5494
-0.5494
-0.6671
-0.824
-1.2164
-0.981
-0.7848
-0.5494
-0.9418
-0.7848
-0.5494
-0.7456
-0.5886
-0.9025
-0.5494
-0.7848
-1.0987
-1.0202
-0.9025
-1.138
-0.824
-0.7063
-0.4709
-0.6671
-0.3139
-0.3924
-0.9418
-1.0595
-1.0987
-0.7063
-1.3342
-0.9418
-0.5494
-0.7848
-0.7456
-0.2747
-0.824
-0.5101
-0.4709
-0.8633
-1.0202
-0.7063
-0.7063
-0.7848
-0.5886
-1.4519
-0.9418
-0.7063
-0.7848
-0.981
-0.4316
-0.824
-0.9025
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
