GioVeronelli/BREATH/Data_acquired/Guest_B(R)EAT(H)_Test_02-07-59_02-09-04.csv

Raw Data
-4.6303
-4.4341
-4.1594
-4.4341
-4.2379
-4.5518
-4.2379
-3.8063
-4.2772
-4.1594
-4.6696
-4.1987
-4.0417
-4.2379
-4.1987
-4.5911
-4.748
-4.5911
-4.5518
-4.0417
-4.3949
-4.7088
-4.905
-4.6303
-4.3556
-4.1987
-4.5126
-4.7873
-4.748
-4.4734
-4.2772
-4.6303
-4.8658
-4.5126
-4.1594
-4.4734
-4.6303
-4.9442
-4.7088
-4.748
-4.2772
-4.4734
-4.6696
-4.9835
-4.5911
-4.1594
-4.2379
-4.5518
-4.9442
-4.5911
-4.6303
-4.4734
-4.3556
-4.8658
-4.4734
-4.3556
-4.6303
-4.5911
-4.905
-4.4734
-4.5126
-4.1202
-4.4734
-4.5911
-4.905
-4.5126
-4.5518
-4.0025
-4.081
-4.5126
-4.3556
-4.1987
-3.8848
-3.6886
-4.3949
-4.3556
-4.3164
-4.6303
-4.9835
-4.8658
-4.905
-5.1797
-5.062
-4.8265
-4.6303
-4.8265
-4.905
-5.5721
-5.3366
-5.1012
-4.7088
-5.1012
-5.5328
-5.6898
-5.4544
-5.2582
-5.2974
-6.0822
-5.8075
-5.9252
-6.4746
-6.3176
-5.9645
-6.5531
-6.7493
-6.6316
-6.4354
-6.3961
-6.9455
-6.9062
-6.5923
-7.1024
-7.024
-6.3961
-5.6898
-5.2582
-5.8468
-5.9252
-5.6506
-5.4936
-5.2582
-4.9835
-5.1797
-4.7873
-4.4341
-4.9442
-4.9835
-4.748
-4.6696
-4.905
-4.7873
-4.3556
-4.081
-4.3164
-4.3949
-4.3949
-3.8455
-3.4139
-3.2177
-3.6101
-3.1392
-3.2569
-3.6886
-3.4924
-3.1392
-3.4531
-3.5316
-3.0607
-2.9822
-2.5506
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
