GioVeronelli/BREATH/Data_acquired/Guest_B(R)EAT(H)_Test_22-11-20_22-12-31.csv

Raw Data
-9.81
-9.4961
-9.1822
-9.5746
-9.3391
-9.6923
-9.7708
-9.6138
-9.4568
-9.8492
-9.81
-9.5353
-9.7315
-9.7708
-9.5353
-9.2606
-9.653
-9.3391
-9.2999
-9.3391
-10.0847
-9.8492
-9.4961
-9.4176
-9.653
-9.1429
-9.1822
-9.3784
-10.0454
-9.653
-9.4176
-9.7315
-9.2214
-9.9277
-9.6923
-9.6138
-9.2999
-9.6923
-9.3391
-9.4176
-9.4961
-10.2024
-9.6138
-9.9277
-9.8492
-9.5353
-9.4176
-9.5353
-9.4961
-9.4176
-9.6138
-9.6138
-9.4568
-9.4961
-10.0847
-9.8885
-9.4176
-9.2606
-9.6138
-9.0644
-9.2606
-9.4961
-10.0847
-9.6923
-9.3784
-9.81
-9.3391
-9.1037
-9.7315
-9.4568
-9.3391
-9.6923
-9.2999
-9.4961
-9.2606
-9.2606
-9.81
-9.8885
-9.3784
-9.653
-9.6923
-9.8492
-9.2999
-9.3391
-9.5746
-9.2214
-9.2606
-9.6138
-10.1239
-9.7708
-9.4176
-9.5746
-9.6923
-9.1822
-9.1822
-9.7315
-10.0847
-9.8492
-9.4568
-9.3784
-9.4961
-9.2999
-9.5353
-9.653
-9.6923
-10.0454
-9.7708
-9.4176
-9.3784
-9.7315
-9.653
-10.0454
-10.0062
-9.8885
-9.81
-9.4176
-9.2214
-9.1037
-9.81
-10.0454
-9.5353
-9.7708
-9.653
-9.2214
-9.8885
-9.8492
-9.4568
-9.1429
-9.4568
-9.7315
-10.0847
-10.0062
-10.0454
-9.653
-9.7315
-9.2606
-9.2999
-9.5746
-10.0062
-9.653
-9.6923
-9.7315
-9.5746
-9.2606
-9.4568
-9.6138
-9.1429
-9.6923
-9.653
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
