GioVeronelli/BREATH/Data_acquired/Guest_B(R)EAT(H)_Test_22-13-50_22-14-08.csv

Raw Data
-9.4568
-9.3784
-9.3784
-9.6138
-9.4568
-9.3784
-9.653
-9.8492
-9.7708
-9.81
-9.5746
-9.8885
-9.8885
-9.6923
-9.7708
-9.4568
-9.2999
-9.7315
-9.5353
-9.5746
-9.653
-9.1037
-9.2214
-9.1429
-9.3784
-9.6138
-9.1822
-9.5353
-10.0454
-9.4176
-9.8885
-10.0062
-9.6138
-9.6923
-9.3784
-9.6923
-9.1822
-9.5746
-9.1822
-9.4961
-9.5746
-9.3784
-9.3784
-9.7315
-9.81
-9.3391
-9.6923
-9.8492
-9.5353
-9.3391
-9.6923
-9.4961
-9.3784
-9.653
-9.81
-9.6138
-9.8492
-9.653
-9.4568
-9.4568
-9.9277
-9.3784
-9.3784
-9.653
-9.0644
-9.3784
-9.653
-10.2024
-9.81
-9.6923
-9.5353
-9.6923
-9.1037
-9.6923
-9.3784
-9.5353
-9.6923
-9.3391
-9.5353
-9.4568
-9.653
-9.5746
-9.9277
-9.6923
-9.6138
-9.1429
-9.2214
-9.1037
-9.3391
-9.4961
-9.8492
-9.6923
-9.4961
-9.7708
-9.4961
-9.1822
-9.6923
-9.4568
-9.2606
-9.6923
-9.5746
-9.3784
-9.7708
-9.6923
-9.5746
-10.0062
-9.81
-9.653
-9.81
-9.2999
-9.6138
-9.653
-9.8492
-9.5746
-9.5353
-9.2214
-9.6923
-9.1037
-9.6138
-9.4176
-9.653
-9.4568
-9.2606
-9.4961
-9.4961
-9.2999
-9.4568
-9.7708
-9.967
-10.0454
-9.81
-9.1037
-9.1822
-9.5353
-9.4176
-9.4568
-9.5353
-9.653
-9.4568
-9.3391
-9.3391
-9.1822
-9.2606
-9.1429
-9.4961
-9.967
-9.2999
-9.6138
-9.6923
-9.6138
-9.5353
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
