GioVeronelli/BREATH/PSoC_CODE/GatheringData/06-Read_ACC_Data_BCP.cydsn/CortexM3/ARM_GCC_541/Debug/LINK_options.txt

-Wl,--start-group -o "C:\\Users\\Giovanni\\Desktop\\AY2324_II_Project-1\\PSoC_CODE\\GatheringData\\06-Read_ACC_Data_BCP.cydsn\\CortexM3\\ARM_GCC_541\\Debug\\06-Read_ACC_Data_BCP.elf" ".\\CortexM3\\ARM_GCC_541\\Debug\\main.o" ".\\CortexM3\\ARM_GCC_541\\Debug\\InterruptRoutine.o" ".\\CortexM3\\ARM_GCC_541\\Debug\\I2C_Interface.o" ".\\CortexM3\\ARM_GCC_541\\Debug\\cyfitter_cfg.o" ".\\CortexM3\\ARM_GCC_541\\Debug\\cymetadata.o" ".\\CortexM3\\ARM_GCC_541\\Debug\\Cm3Start.o" ".\\CortexM3\\ARM_GCC_541\\Debug\\06-Read_ACC_Data_BCP.a" "D:\\Programmi\\Cypress\\PSoC\ Creator\\4.4\\PSoC\ Creator\\psoc\\content\\cycomponentlibrary\\CyComponentLibrary.cylib\\CortexM3\\ARM_GCC_541\\Debug\\CyComponentLibrary.a" -mcpu=cortex-m3 -mthumb -L "Generated_Source\\PSoC5" "-Wl,-Map,.\\CortexM3\\ARM_GCC_541\\Debug/06-Read_ACC_Data_BCP.map" -T "Generated_Source\\PSoC5\\cm3gcc.ld" -specs=nano.specs -Wl,--gc-sections -g -ffunction-sections -Og -ffat-lto-objects -Wl,--end-group
