GioVeronelli/BREATH/PCB/RespirationSchematics.brd

## EAGLE design PCB/RespirationSchematics.brd (2025-03-09)

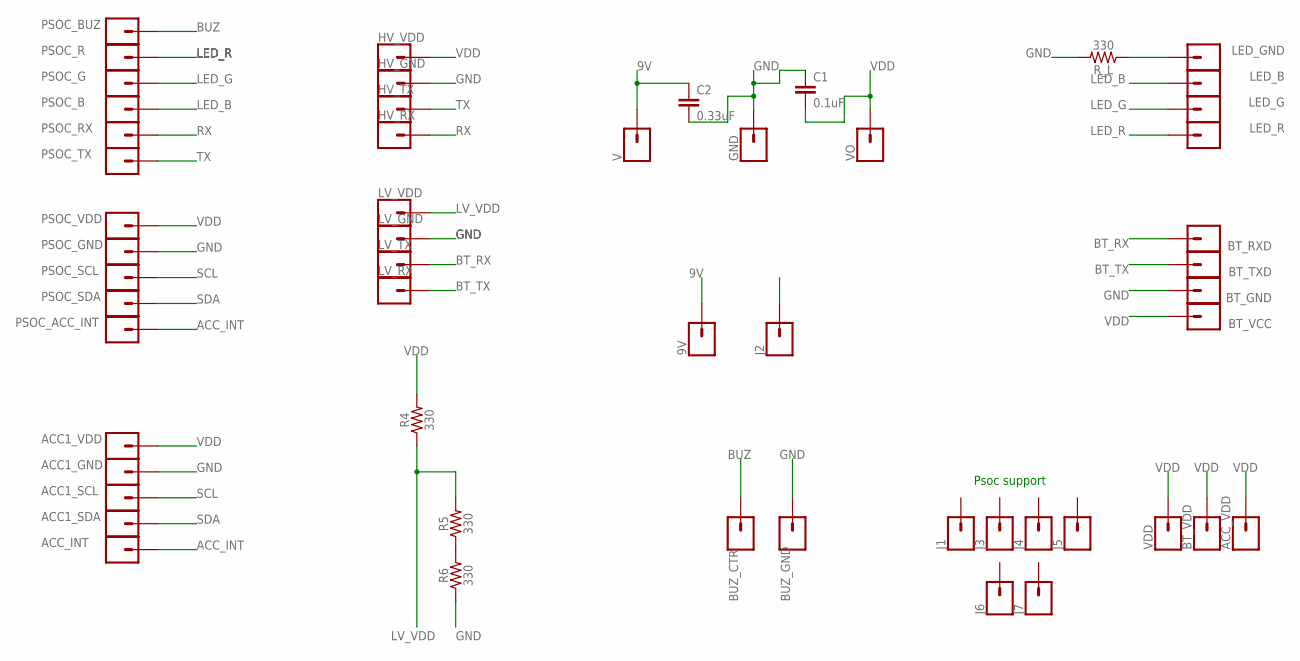
[picture p160: schematic RespirationSchematics.sch]

Parts:
9V: CONN_01; 1X01
ACC1_GND, ACC1_SCL, ACC1_SDA, ACC1_VDD: CONN_01; 1X01
ACC_INT: CONN_01; 1X01
ACC_VDD: CONN_01; 1X01
BT_GND: CONN_01; 1X01
BT_RXD: CONN_01; 1X01
BT_TXD: CONN_01; 1X01
BT_VCC: CONN_01; 1X01
BT_VDD: CONN_01; 1X01
BUZ_CTR: CONN_01; 1X01
BUZ_GND: CONN_01; 1X01
C1: 0.1uF; CAP-PTH-SMALL-KIT
C2: 0.33uF; CAP-PTH-SMALL-KIT
GND: CONN_01; 1X01
HV_GND: CONN_01; 1X01
HV_RX: CONN_01; 1X01
HV_TX: CONN_01; 1X01
HV_VDD: CONN_01; 1X01
J1, J2, J3, J4, J5, J6, J7: CONN_01; 1X01
LED_B: CONN_01; 1X01
LED_G: CONN_01; 1X01
LED_GND: CONN_01; 1X01
LED_R: CONN_01; 1X01
LV_GND: CONN_01; 1X01
LV_RX: CONN_01; 1X01
LV_TX: CONN_01; 1X01
LV_VDD: CONN_01; 1X01
PSOC_ACC_INT: CONN_01; 1X01
PSOC_B: CONN_01; 1X01
PSOC_BUZ: CONN_01; 1X01
PSOC_G: CONN_01; 1X01
PSOC_GND: CONN_01; 1X01
PSOC_R: CONN_01; 1X01
PSOC_RX: CONN_01; 1X01
PSOC_SCL: CONN_01; 1X01
PSOC_SDA: CONN_01; 1X01
PSOC_TX: CONN_01; 1X01
PSOC_VDD: CONN_01; 1X01
R4, R5, R6: 330; AXIAL-0.3
R_L: 330; AXIAL-0.3
V: CONN_01; 1X01
VDD: CONN_01; 1X01
VO: CONN_01; 1X01

Connections:
9V: 9V.1, C2.1, V.1
ACC_INT: ACC_INT.1, PSOC_ACC_INT.1
BT_RX: BT_RXD.1, LV_TX.1
BT_TX: BT_TXD.1, LV_RX.1
BUZ: BUZ_CTR.1, PSOC_BUZ.1
GND: ACC1_GND.1, BT_GND.1, BUZ_GND.1, C1.1, C2.2, GND.1, HV_GND.1, J2.1, LV_GND.1, PSOC_GND.1, R6.P$1 (1), R_L.P$2 (2)
LED_B: LED_B.1, PSOC_B.1
LED_G: LED_G.1, PSOC_G.1
LED_R: LED_R.1, PSOC_R.1
LV_VDD: LV_VDD.1, R4.P$1 (1), R5.P$2 (2)
unnamed: LED_GND.1, R_L.P$1 (1)
unnamed: R5.P$1 (1), R6.P$2 (2)
RX: HV_RX.1, PSOC_RX.1
SCL: ACC1_SCL.1, PSOC_SCL.1
SDA: ACC1_SDA.1, PSOC_SDA.1
TX: HV_TX.1, PSOC_TX.1
VDD: ACC1_VDD.1, ACC_VDD.1, BT_VCC.1, BT_VDD.1, C1.2, HV_VDD.1, PSOC_VDD.1, R4.P$2 (2), VDD.1, VO.1

Notes on the sheet:
Psoc support

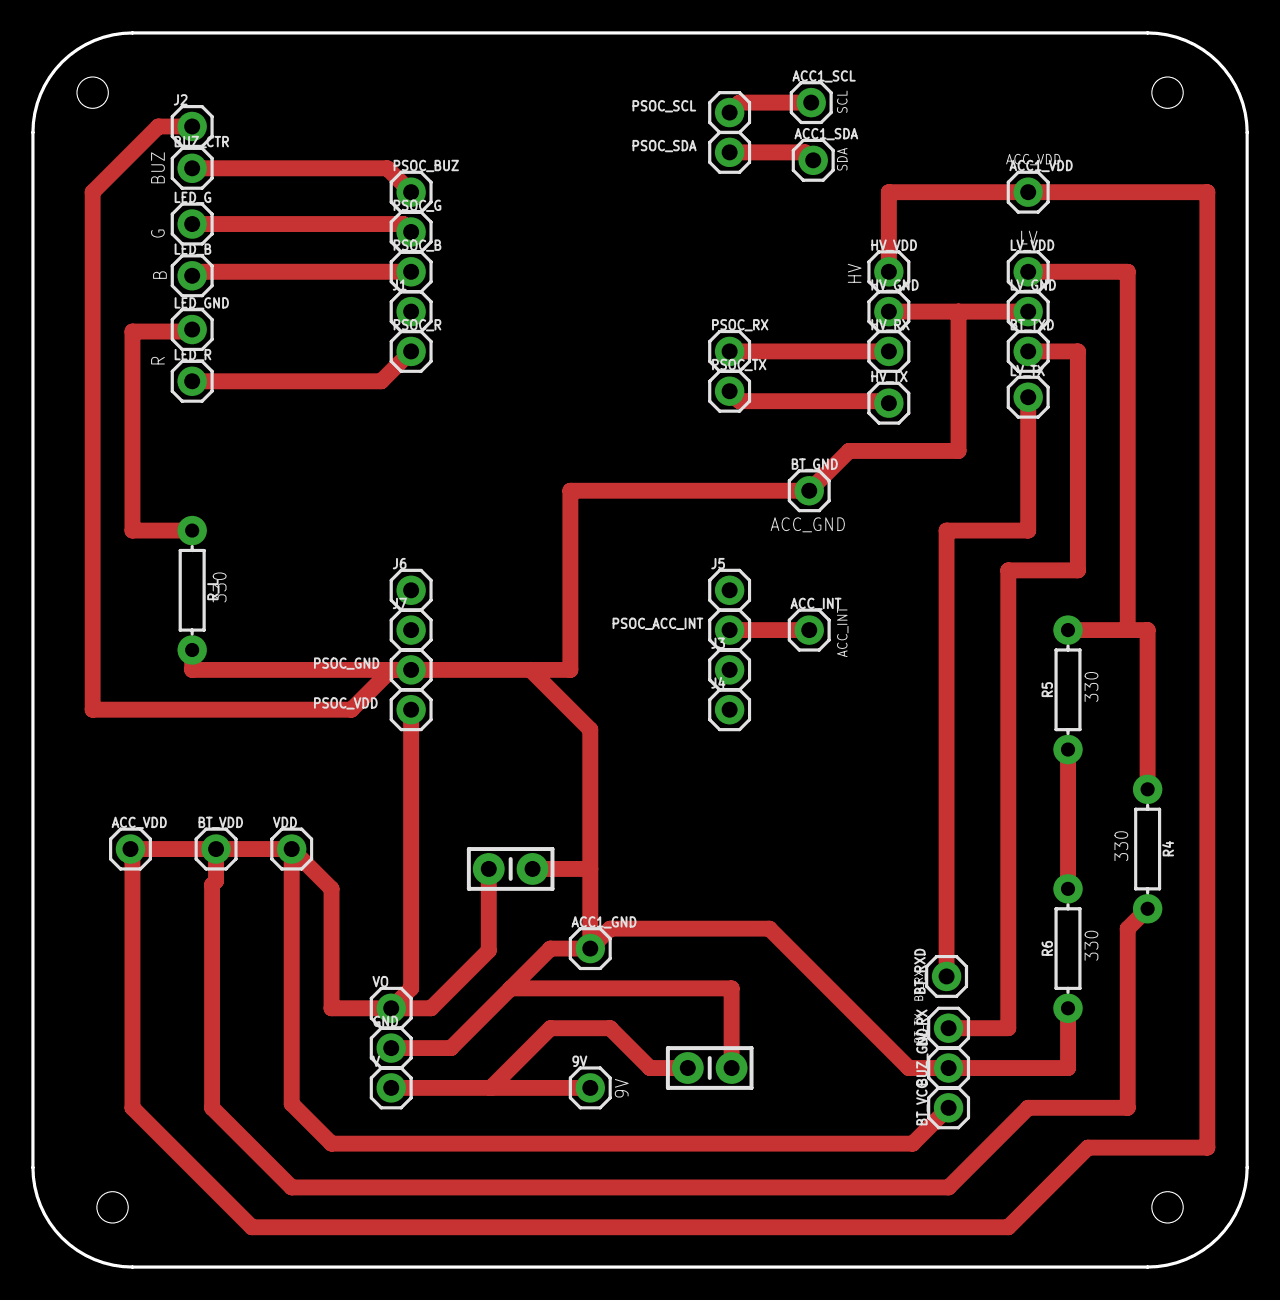
[picture p161: board RespirationSchematics.brd from above]

Board: 2 copper layers, 77.5 x 78.7 mm, 54 parts (0 on the bottom side), 17 nets.
