GioVeronelli/BREATH/PSoC_CODE/GatheringData/06-Read_ACC_Data_BCP.cydsn/Read_Acc_Data_XYZ.cydsn/codegentemp/LED_B.h

/*******************************************************************************
* File Name: LED_B.h  
* Version 2.20
*
* Description:
*  This file contains Pin function prototypes and register defines
*
* Note:
*
********************************************************************************
* Copyright 2008-2015, Cypress Semiconductor Corporation.  All rights reserved.
* You may use this file only in accordance with the license, terms, conditions, 
* disclaimers, and limitations in the end user license agreement accompanying 
* the software package with which this file was provided.
*******************************************************************************/

#if !defined(CY_PINS_LED_B_H) /* Pins LED_B_H */
#define CY_PINS_LED_B_H

#include "cytypes.h"
#include "cyfitter.h"
#include "cypins.h"
#include "LED_B_aliases.h"

/* APIs are not generated for P15[7:6] */
#if !(CY_PSOC5A &&\
	 LED_B__PORT == 15 && ((LED_B__MASK & 0xC0) != 0))


/***************************************
*        Function Prototypes             
***************************************/    

/**
* \addtogroup group_general
* @{
*/
void    LED_B_Write(uint8 value);
void    LED_B_SetDriveMode(uint8 mode);
uint8   LED_B_ReadDataReg(void);
uint8   LED_B_Read(void);
void    LED_B_SetInterruptMode(uint16 position, uint16 mode);
uint8   LED_B_ClearInterrupt(void);
/** @} general */

/***************************************
*           API Constants        
***************************************/
/**
* \addtogroup group_constants
* @{
*/
    /** \addtogroup driveMode Drive mode constants
     * \brief Constants to be passed as "mode" parameter in the LED_B_SetDriveMode() function.
     *  @{
     */
        #define LED_B_DM_ALG_HIZ         PIN_DM_ALG_HIZ
        #define LED_B_DM_DIG_HIZ         PIN_DM_DIG_HIZ
        #define LED_B_DM_RES_UP          PIN_DM_RES_UP
        #define LED_B_DM_RES_DWN         PIN_DM_RES_DWN
        #define LED_B_DM_OD_LO           PIN_DM_OD_LO
        #define LED_B_DM_OD_HI           PIN_DM_OD_HI
        #define LED_B_DM_STRONG          PIN_DM_STRONG
        #define LED_B_DM_RES_UPDWN       PIN_DM_RES_UPDWN
    /** @} driveMode */
/** @} group_constants */
    
/* Digital Port Constants */
#define LED_B_MASK               LED_B__MASK
#define LED_B_SHIFT              LED_B__SHIFT
#define LED_B_WIDTH              1u

/* Interrupt constants */
#if defined(LED_B__INTSTAT)
/**
* \addtogroup group_constants
* @{
*/
    /** \addtogroup intrMode Interrupt constants
     * \brief Constants to be passed as "mode" parameter in LED_B_SetInterruptMode() function.
     *  @{
     */
        #define LED_B_INTR_NONE      (uint16)(0x0000u)
        #define LED_B_INTR_RISING    (uint16)(0x0001u)
        #define LED_B_INTR_FALLING   (uint16)(0x0002u)
        #define LED_B_INTR_BOTH      (uint16)(0x0003u) 
    /** @} intrMode */
/** @} group_constants */

    #define LED_B_INTR_MASK      (0x01u) 
#endif /* (LED_B__INTSTAT) */


/***************************************
*             Registers        
***************************************/

/* Main Port Registers */
/* Pin State */
#define LED_B_PS                     (* (reg8 *) LED_B__PS)
/* Data Register */
#define LED_B_DR                     (* (reg8 *) LED_B__DR)
/* Port Number */
#define LED_B_PRT_NUM                (* (reg8 *) LED_B__PRT) 
/* Connect to Analog Globals */                                                  
#define LED_B_AG                     (* (reg8 *) LED_B__AG)                       
/* Analog MUX bux enable */
#define LED_B_AMUX                   (* (reg8 *) LED_B__AMUX) 
/* Bidirectional Enable */                                                        
#define LED_B_BIE                    (* (reg8 *) LED_B__BIE)
/* Bit-mask for Aliased Register Access */
#define LED_B_BIT_MASK               (* (reg8 *) LED_B__BIT_MASK)
/* Bypass Enable */
#define LED_B_BYP                    (* (reg8 *) LED_B__BYP)
/* Port wide control signals */                                                   
#define LED_B_CTL                    (* (reg8 *) LED_B__CTL)
/* Drive Modes */
#define LED_B_DM0                    (* (reg8 *) LED_B__DM0) 
#define LED_B_DM1                    (* (reg8 *) LED_B__DM1)
#define LED_B_DM2                    (* (reg8 *) LED_B__DM2) 
/* Input Buffer Disable Override */
#define LED_B_INP_DIS                (* (reg8 *) LED_B__INP_DIS)
/* LCD Common or Segment Drive */
#define LED_B_LCD_COM_SEG            (* (reg8 *) LED_B__LCD_COM_SEG)
/* Enable Segment LCD */
#define LED_B_LCD_EN                 (* (reg8 *) LED_B__LCD_EN)
/* Slew Rate Control */
#define LED_B_SLW                    (* (reg8 *) LED_B__SLW)

/* DSI Port Registers */
/* Global DSI Select Register */
#define LED_B_PRTDSI__CAPS_SEL       (* (reg8 *) LED_B__PRTDSI__CAPS_SEL) 
/* Double Sync Enable */
#define LED_B_PRTDSI__DBL_SYNC_IN    (* (reg8 *) LED_B__PRTDSI__DBL_SYNC_IN) 
/* Output Enable Select Drive Strength */
#define LED_B_PRTDSI__OE_SEL0        (* (reg8 *) LED_B__PRTDSI__OE_SEL0) 
#define LED_B_PRTDSI__OE_SEL1        (* (reg8 *) LED_B__PRTDSI__OE_SEL1) 
/* Port Pin Output Select Registers */
#define LED_B_PRTDSI__OUT_SEL0       (* (reg8 *) LED_B__PRTDSI__OUT_SEL0) 
#define LED_B_PRTDSI__OUT_SEL1       (* (reg8 *) LED_B__PRTDSI__OUT_SEL1) 
/* Sync Output Enable Registers */
#define LED_B_PRTDSI__SYNC_OUT       (* (reg8 *) LED_B__PRTDSI__SYNC_OUT) 

/* SIO registers */
#if defined(LED_B__SIO_CFG)
    #define LED_B_SIO_HYST_EN        (* (reg8 *) LED_B__SIO_HYST_EN)
    #define LED_B_SIO_REG_HIFREQ     (* (reg8 *) LED_B__SIO_REG_HIFREQ)
    #define LED_B_SIO_CFG            (* (reg8 *) LED_B__SIO_CFG)
    #define LED_B_SIO_DIFF           (* (reg8 *) LED_B__SIO_DIFF)
#endif /* (LED_B__SIO_CFG) */

/* Interrupt Registers */
#if defined(LED_B__INTSTAT)
    #define LED_B_INTSTAT            (* (reg8 *) LED_B__INTSTAT)
    #define LED_B_SNAP               (* (reg8 *) LED_B__SNAP)
    
	#define LED_B_0_INTTYPE_REG 		(* (reg8 *) LED_B__0__INTTYPE)
#endif /* (LED_B__INTSTAT) */

#endif /* CY_PSOC5A... */

#endif /*  CY_PINS_LED_B_H */


/* [] END OF FILE */
