GioVeronelli/BREATH/PSoC_CODE/GatheringData/06-Read_ACC_Data_BCP.cydsn/Read_Acc_Data_XYZ.cydsn/codegentemp/LED_B_aliases.h

/*******************************************************************************
* File Name: LED_B.h  
* Version 2.20
*
* Description:
*  This file contains the Alias definitions for Per-Pin APIs in cypins.h. 
*  Information on using these APIs can be found in the System Reference Guide.
*
* Note:
*
********************************************************************************
* Copyright 2008-2015, Cypress Semiconductor Corporation.  All rights reserved.
* You may use this file only in accordance with the license, terms, conditions, 
* disclaimers, and limitations in the end user license agreement accompanying 
* the software package with which this file was provided.
*******************************************************************************/

#if !defined(CY_PINS_LED_B_ALIASES_H) /* Pins LED_B_ALIASES_H */
#define CY_PINS_LED_B_ALIASES_H

#include "cytypes.h"
#include "cyfitter.h"


/***************************************
*              Constants        
***************************************/
#define LED_B_0			(LED_B__0__PC)
#define LED_B_0_INTR	((uint16)((uint16)0x0001u << LED_B__0__SHIFT))

#define LED_B_INTR_ALL	 ((uint16)(LED_B_0_INTR))

#endif /* End Pins LED_B_ALIASES_H */


/* [] END OF FILE */
