GioVeronelli/BREATH/PSoC_CODE/GatheringData/06-Read_ACC_Data_BCP.cydsn/Read_Acc_Data_XYZ.cydsn/codegentemp/isr_DATA.h

/*******************************************************************************
* File Name: isr_DATA.h
* Version 1.70
*
*  Description:
*   Provides the function definitions for the Interrupt Controller.
*
*
********************************************************************************
* Copyright 2008-2015, Cypress Semiconductor Corporation.  All rights reserved.
* You may use this file only in accordance with the license, terms, conditions, 
* disclaimers, and limitations in the end user license agreement accompanying 
* the software package with which this file was provided.
*******************************************************************************/
#if !defined(CY_ISR_isr_DATA_H)
#define CY_ISR_isr_DATA_H


#include <cytypes.h>
#include <cyfitter.h>

/* Interrupt Controller API. */
void isr_DATA_Start(void);
void isr_DATA_StartEx(cyisraddress address);
void isr_DATA_Stop(void);

CY_ISR_PROTO(isr_DATA_Interrupt);

void isr_DATA_SetVector(cyisraddress address);
cyisraddress isr_DATA_GetVector(void);

void isr_DATA_SetPriority(uint8 priority);
uint8 isr_DATA_GetPriority(void);

void isr_DATA_Enable(void);
uint8 isr_DATA_GetState(void);
void isr_DATA_Disable(void);

void isr_DATA_SetPending(void);
void isr_DATA_ClearPending(void);


/* Interrupt Controller Constants */

/* Address of the INTC.VECT[x] register that contains the Address of the isr_DATA ISR. */
#define isr_DATA_INTC_VECTOR            ((reg32 *) isr_DATA__INTC_VECT)

/* Address of the isr_DATA ISR priority. */
#define isr_DATA_INTC_PRIOR             ((reg8 *) isr_DATA__INTC_PRIOR_REG)

/* Priority of the isr_DATA interrupt. */
#define isr_DATA_INTC_PRIOR_NUMBER      isr_DATA__INTC_PRIOR_NUM

/* Address of the INTC.SET_EN[x] byte to bit enable isr_DATA interrupt. */
#define isr_DATA_INTC_SET_EN            ((reg32 *) isr_DATA__INTC_SET_EN_REG)

/* Address of the INTC.CLR_EN[x] register to bit clear the isr_DATA interrupt. */
#define isr_DATA_INTC_CLR_EN            ((reg32 *) isr_DATA__INTC_CLR_EN_REG)

/* Address of the INTC.SET_PD[x] register to set the isr_DATA interrupt state to pending. */
#define isr_DATA_INTC_SET_PD            ((reg32 *) isr_DATA__INTC_SET_PD_REG)

/* Address of the INTC.CLR_PD[x] register to clear the isr_DATA interrupt. */
#define isr_DATA_INTC_CLR_PD            ((reg32 *) isr_DATA__INTC_CLR_PD_REG)


#endif /* CY_ISR_isr_DATA_H */


/* [] END OF FILE */
