GioVeronelli/BREATH/PSoC_CODE/GatheringData/06-Read_ACC_Data_BCP.cydsn/Read_Acc_Data_XYZ.cydsn/codegentemp/isr_STREAM.h

/*******************************************************************************
* File Name: isr_STREAM.h
* Version 1.70
*
*  Description:
*   Provides the function definitions for the Interrupt Controller.
*
*
********************************************************************************
* Copyright 2008-2015, Cypress Semiconductor Corporation.  All rights reserved.
* You may use this file only in accordance with the license, terms, conditions, 
* disclaimers, and limitations in the end user license agreement accompanying 
* the software package with which this file was provided.
*******************************************************************************/
#if !defined(CY_ISR_isr_STREAM_H)
#define CY_ISR_isr_STREAM_H


#include <cytypes.h>
#include <cyfitter.h>

/* Interrupt Controller API. */
void isr_STREAM_Start(void);
void isr_STREAM_StartEx(cyisraddress address);
void isr_STREAM_Stop(void);

CY_ISR_PROTO(isr_STREAM_Interrupt);

void isr_STREAM_SetVector(cyisraddress address);
cyisraddress isr_STREAM_GetVector(void);

void isr_STREAM_SetPriority(uint8 priority);
uint8 isr_STREAM_GetPriority(void);

void isr_STREAM_Enable(void);
uint8 isr_STREAM_GetState(void);
void isr_STREAM_Disable(void);

void isr_STREAM_SetPending(void);
void isr_STREAM_ClearPending(void);


/* Interrupt Controller Constants */

/* Address of the INTC.VECT[x] register that contains the Address of the isr_STREAM ISR. */
#define isr_STREAM_INTC_VECTOR            ((reg32 *) isr_STREAM__INTC_VECT)

/* Address of the isr_STREAM ISR priority. */
#define isr_STREAM_INTC_PRIOR             ((reg8 *) isr_STREAM__INTC_PRIOR_REG)

/* Priority of the isr_STREAM interrupt. */
#define isr_STREAM_INTC_PRIOR_NUMBER      isr_STREAM__INTC_PRIOR_NUM

/* Address of the INTC.SET_EN[x] byte to bit enable isr_STREAM interrupt. */
#define isr_STREAM_INTC_SET_EN            ((reg32 *) isr_STREAM__INTC_SET_EN_REG)

/* Address of the INTC.CLR_EN[x] register to bit clear the isr_STREAM interrupt. */
#define isr_STREAM_INTC_CLR_EN            ((reg32 *) isr_STREAM__INTC_CLR_EN_REG)

/* Address of the INTC.SET_PD[x] register to set the isr_STREAM interrupt state to pending. */
#define isr_STREAM_INTC_SET_PD            ((reg32 *) isr_STREAM__INTC_SET_PD_REG)

/* Address of the INTC.CLR_PD[x] register to clear the isr_STREAM interrupt. */
#define isr_STREAM_INTC_CLR_PD            ((reg32 *) isr_STREAM__INTC_CLR_PD_REG)


#endif /* CY_ISR_isr_STREAM_H */


/* [] END OF FILE */
