GioVeronelli/BREATH/(commit log)

2025-03-09 Data acquired folder
    [Fur_Option1_15-47-26_15-51-24.csv, Fur_Option1_15-53-27_15-57-33.csv, Fur_Option1_15-58-58_16-05-34.csv, Fur_Option1_15-58-58_16-07-43.csv, Fur_Option1_15-58-58_16-14-17.csv, Fur_Option1_16-16-34_16-20-02.csv, Fur_Option1_16-16-34_16-26-17.csv, Fur_Option1_18-12-15_18-15-55.csv]
2025-03-09 GUI, Images and PCB added
    [RespirationSchematics.brd, RespirationSchematics.sch]
2025-03-09 PsOC Files added
    [06-Read_ACC_Data_BCP.sdf, Read_Acc_Data_XYZ.sdf]
